bryfur/tang-av-scaler/hardware/av-board/README.md

# The AV board (rev C-B)

The scaler's hardware, for the sixth generation of game consoles: a Sipeed Tang Mega 138K SOM (Gowin
GW5AST-138, with its DDR3 and configuration flash) on a carrier of its own, 100 x 100 mm, four
layers, about 290 parts. Built (JLCPCB) and running the scaler since 2026-11.

Rev C-B, 3D

| On the board | Part | For |
|---|---|---|
| Component video in (three RCA jacks) | ADV7181D decoder | the console's YPbPr, sampled line-locked: 16-bit 4:2:2 to the FPGA; also wired: RGB with SCART sync, a VGA header (RGBHV with DDC): not used by the gateware yet |
| Stereo audio in (two RCA jacks) | PCM1808 converter, on its own 4.5 V supply | the console's sound, to HDMI |
| S/PDIF in (a header: coax or an optical module) | a slicer | not used by the gateware yet |
| HDMI out | SN65DP159 between the FPGA's transceivers and the receptacle (run as a redriver), ESD arrays, DDC/HPD/CEC | up to 4K60 by the link's rate; the scaler sends 1080p60 |
| Clock | MS5351M generator | the transceivers' reference, trimmed by the scaler to keep the output in step with the input; the audio converter's clock |
| Control | a Seeed XIAO ESP32-C5 in sockets, through level translators | Wi-Fi and the web page; the FPGA's JTAG (it loads bitstreams) and a UART and SPI port to it |
| Power | USB-C, 5 V / 3 A; a buck and LDOs | 3.3 V, 1.8 V, 1.1 V and the analogue rails |
| Test access | J17 (I2C buses and six spare FPGA pins behind 220 R), J16 (JTAG), rail test pads | [rev-cb/README.md](rev-cb/README.md) |

The design, connection by connection with its sources: [rev-c/design.md](rev-c/design.md) (the
SOM's interface, power, the clock generator, the XIAO, HDMI) and, for the circuits taken from the
earlier rev B (the decoder's front end, the audio converter, the supplies),
[older/rev-b/design.md](older/rev-b/design.md). Reviewed against every part's data sheet:
[rev-c/review.md](rev-c/review.md), [older/rev-b/review.md](older/rev-b/review.md). Fab files and
ordering notes: [rev-cb/README.md](rev-cb/README.md). The FPGA's pins:
`rev-cb/fpga/av-board-cb.cst` (generated from the board).

The board is generated with KiCad's Python API from `rev-cb/board.py`; nothing is drawn by hand.

## Layout of this directory

| Path | What |
|---|---|
| `rev-cb/` | the board: `board.py` (its parts and nets: the one source the schematic and PCB are generated from), `gen_pcb.py` (outline, placement, routing passes), the generated KiCad project, `fab/` (JLCPCB Gerbers, BOM, CPL), `img/` (renders), `fpga/` (pin constraints) |
| `rev-c/` | what rev C-B shares with its sibling C-A: the circuit (`carrier.py`), floor plan and layout, the SOM's interface (`som.py`, `som-pinout.csv`, `check_som_fp.py`), the FPGA pin assignment (`pinmap.py`), `design.md`, `review.md` |
| `kit/` | the generators and checks (below), and the circuits and layout taken from rev B: `circuits.py` (the supplies, the ADV7181D front end, the PCM1808, the S/PDIF input, the XIAO, the HDMI receptacle), `adv7181d_layout.py`, `tmds_layout.py` |
| `lib/` | LCSC symbols and footprints (3D models not in git) |
| `refs/` | data sheets and reference designs (not in git) |
| `older/` | the revisions before this one (A, B: hats on Sipeed's Tang Console; C-A: with an ADV7511): not built, kept for their design notes and reviews. [older/README.md](older/README.md) |

## Making the board

Everything is generated from `rev-cb/board.py`; edit that (and `gen_pcb.py` for placement), not
the KiCad files. On a machine with KiCad 9 (here: the build host), from this directory:

| Step | Command | Makes |
|---|---|---|
| check the design | `python3 rev-cb/board.py` | errors: one-pin nets, chip pins left open that should not be |
| schematic | `python3 kit/gen_sch.py rev-cb` | `rev-cb/av-board-cb.kicad_sch`, project and library tables |
| ERC | `kicad-cli sch erc rev-cb/av-board-cb.kicad_sch` | (clean) |
| netlist check | `kicad-cli sch export netlist -o /tmp/av.net rev-cb/av-board-cb.kicad_sch && python3 kit/check_netlist.py rev-cb /tmp/av.net` | schematic = board.py, pin by pin |
| PCB | `python3 rev-cb/gen_pcb.py --route` | `rev-cb/av-board-cb.kicad_pcb`: placed, fanned out, routed, ground poured, the revision's own pass, then whatever is left unconnected finished by mazeroute.py (`--complete`). Router: Freerouting (`FREEROUTING=1.9.0` default, under a private Xvfb; `2.5.0` headless), or DeepPCB (`ROUTER=deeppcb MINUTES=60`, API key in `~/.config/deeppcb/key`), or any session (`SES=file.ses`); a session from elsewhere gets a Freerouting finishing pass with its copper fixed (`FINISH=0`: none); `PCB=path` for a trial board elsewhere; `--silk`: the silkscreen pass again on a routed board; `--move REF x y angle`, then `--complete`: one part moved on a routed board, its connections made again |
| finishing | `kicad-cli pcb drc ...`, then for each connection left: `python3 kit/mazeroute.py dump BOARD REF.PAD REF.PAD /tmp/m.json [PARTNER_NET] && ~/tools/eda-venv/bin/python kit/mazeroute.py route /tmp/m.json /tmp/p.json && python3 kit/mazeroute.py apply BOARD /tmp/p.json` | a grid router (A*) for what Freerouting leaves: F/In2/B (`MAZE_LAYERS`, `MAZE_WIDTH`), new vias where they fit, our clearances; with `MAZE_SOFT=1` it may cross other signal nets' unlocked copper at a cost, and apply takes up what it crossed (rip-up). `gen_pcb.py --complete` does all this for whatever DRC lists, the rip-up last; DRC after |
| a router's result for some nets | `python3 kit/sesgraft.py BOARD x.ses PREFIX` | those nets' copper from a session added to a routed board |
| keep-outs on a routed board | `python3 rev-cb/gen_pcb.py --keepouts && python3 rev-cb/gen_pcb.py --complete` | after a change to the keep-outs (kit/tmds_layout.py's along the TMDS pairs: other lines 30 mil off, the arrays' pads voided in the planes): the board's own taken off, made again from its locked lines, the copper they now hold out taken up; `--complete` routes those connections again. The rest of the route stays |
| placement check | `python3 kit/placecheck.py rev-cb [--min 8]` | the small parts' signal pins far from the rest of their net (a part by the wrong anchor); `gen_pcb.py` itself prints the crossings left in each header bus |
| analog isolation | `python3 kit/xtalk.py rev-cb` | each analog line's digital neighbours within 1 mm on its layer: the closest gap, how far they run within 1 mm and within 0.5 mm |
| HDMI layout | `python3 kit/hdmi_audit.py rev-cb` | the TMDS pairs (and on rev C-B the transceivers' lanes and reference clock) against TI's layout rules (SN65DP159 12.1, SPRAAR7) and the HDMI skew budgets: lengths, skew, vias, turns, other copper along the run, crystals, switchers and holes nearby, the ground plane's edges and voids under the lines, the planes voided under parts on them; each finding with its rule |
| renders | `python3 kit/render.py rev-cb` | `rev-cb/img/`: a 3D view and a top view (KiCad's raytracer; models from `fetch_lib.sh` and `kit/fetch_3d.py`) |
| picture | `python3 kit/snap.py BOARD out.png` | a PNG of the board (needs PyMuPDF in `~/tools/eda-venv`) |
| DRC | `kicad-cli pcb drc BOARD` | |
| fab files | `python3 kit/gen_fab.py rev-cb` | `rev-cb/fab/`: Gerbers + drill zip, JLCPCB BOM and CPL, all from the board's lower-left corner; a BOM + CPL per assembly variant (`VARIANTS` in board.py: parts left for hand soldering) |
| parts library | `./kit/fetch_lib.sh` | `lib/`: LCSC symbols/footprints (committed) and 3D models (not) |

`kit/parts.py` is what board.py is written with (parts, LCSC numbers);
`kit/pcbkit.py` the PCB generator (placer, fanout, rules, planes, routing passes, silkscreen);
`kit/doubled.py` connections a router laid twice (loops, lengths counted twice, copper slivers);
`kit/decouple.py` each chip's supply pins and their capacitors (distances; regulators' in and out);
`kit/sexp.py` reads and writes KiCad's s-expression files; `kit/fix_lib.py` makes the LCSC
symbols' pins passive (their EasyEDA pin types are arbitrary); `kit/merge_sym.py` adds a symbol
whose EasyEDA name clashes with one already there; `kit/deeppcb.py` drives DeepPCB.

## Reference documents

In `refs/` (not in git). Every circuit on the board follows these (the ADV7842's and the ADV7511's are the older revisions').

| File | What | From |
|---|---|---|
| ADV7842_datasheet_adi.pdf | ADV7842 data sheet, Rev B: supplies, currents, crystal (28.63636 MHz), 256-ball map | analog.com data-sheets/ADV7842.pdf |
| UG-214_ADV7842_hardware.pdf | ADV7842 Hardware User Guide: analog input configuration (6.2.1), reset, pixel port, PCB layout recommendations, recommended decoupling (Fig. 168, 179), 75 R input termination (Appendix B) | analog.com user-guides/UG-214.pdf (via docs.ampnuts.ru mirror) |
| HDMI_RX_PowerSupplies_RevA_050411.pdf | ADI "PCB Layout and Power Supply Design Recommendations for HDMI RX Products", Rev A (April 2011): a ferrite per supply rail (Murata NFE61PT472C1H9), 10 nF + 100 nF per pin, 10 uF bulk on AVDD/CVDD/PVDD, LDOs not switchers, 3.3 V before 1.8 V; Fig. 2 the reference LDO supply (10 uH + 10 uF after the 1.8 V LDO, 100 nF + 1 uF on AVDD/CVDD/PVDD, 100 nF on DVDD/DVDDIO/TVDD, 1.8 V enable from 3.3 V via 100 k / 470 nF) | ADI EngineerZone, ADV7842 design support files (downloaded by hand) |
| adv7844ebz/ | ADI's ADV7844 evaluation board ("ADV7844 Input Module", Rev C, July 2010): schematic (11 sheets, image-only PDF), manufacturing BOM (.xls), IPC-356 netlist, Gerbers. The main circuit reference: see reference-notes.md | ADI EngineerZone, ADV7844 evaluation board info (downloaded by hand) |
| ADV7844-VER.5.8c.txt | ADI's recommended register scripts for the ADV7844 (v5.8c, 2012), the ADV7842's sibling: I2C write sequences per input mode, configuring the receiver (0x40 IO, 0x44 CP, 0x4C AFE ...) and the ADV7511 (0x72) together; "CP YPbPr SD/ED/HD" are the PS2's component modes. For bring-up; the ADV7842's own file (Rev 1.9) is the exact match | ADI EngineerZone, ADV7842 design support files (downloaded by hand) |
| UG-206_ADV7842_software.pdf | ADV7842 software (register) guide | analog.com user-guides/UG-206.pdf |
| UG-235_eval_ADV7842_7511.pdf | EVAL-ADV7842-7511 user guide (placement drawing, jumpers; no schematic) | farnell.com mirror of UG-235 |
| ADV7511_hardware_users_guide_RevD.pdf | ADV7511 Hardware User's Guide, Rev D: 100-lead LQFP pinout, input/output connections, HPD, DDC, PLL circuit, power domains and filtering, example schematic (Fig. 27) | analog.com user-guides/ADV7511_Hardware_Users_Guide.pdf |
| ADV7511_programming_guide.pdf | ADV7511 Programming Guide | analog.com user-guides |
| ADV7511_HDMI_designs_appnote.pdf | HDMI-enabled designs using the ADV7511 | analog.com evaluation-documentation |
| ADV7511W_hardware_users_guide_RevA.pdf | ADV7511W (64-lead) guide: cross-check only, its pinout does not apply | digikey.com |
| ADV7511_datasheet.pdf | ADV7511 short data sheet | docs.ampnuts.ru mirror |
| ADV7181D_datasheet.pdf | ADV7181D data sheet, Rev C (2024): 64-lead LFCSP pinout, supplies, component formats (525i-1080i), typical connection diagram (Fig. 9: ADC reference caps, loop filter, crystal), pixel output modes (rev B) | analog.com data-sheets/ADV7181D.pdf (downloaded by hand) |
| AN-1260.pdf | Crystal design considerations for ADI video decoders and HDMI parts | docs.ampnuts.ru mirror |
| AN-1270.pdf | ADV7511-based video generators | docs.ampnuts.ru mirror |
| AN-1143.pdf | ADV7511 HDCP 1.1 enable/disable | docs.ampnuts.ru mirror |
| PCM1808_datasheet.pdf | TI PCM1808 (Rev B): typical application circuit | ti.com |
| console138k_C.pdf | Sipeed Tang_138K_Console_V32001C schematic | dl.sipeed.com TANG/Console/02_Schematic |
| ibom_C.html | Sipeed's interactive BOM for board 32001C (part positions) | dl.sipeed.com TANG/Console/03_Designator_drawing |
| console/ | the Tang Mega 138K SOM's drawing, the NEO Console's schematic, the Retro Console's STEP model | dl.sipeed.com |
| RCJ-01.pdf | CUI RCJ-01x RCA jacks: footprint, colour codes | cuidevices.com |
| tlv62569.pdf, tps7a7001.pdf, tps7a20.pdf, tpd1e05u06.pdf, tpd4e05u06.pdf | TI: the buck, the LDOs, the ESD diodes and arrays | ti.com |
| sn65dp159.pdf | TI SN65DP159 retimer, SLLSEJ2G (rev C-B) | ti.com |
| MS5351M_datasheet_V1.4.pdf | Relmon MS5351M clock generator, V1.4 (Chinese): supplies, crystal, outputs (rev C) | LCSC (atta.szlcsc.com) |
| gowin/DS1239E.pdf | Gowin GW5AST data sheet DS1239: I/O standards, transceiver DC and reference clock characteristics (rev C) | cdn.gowinsemi.com.cn |

Still wanted, for cross-checking: the ADV7842 recommended settings (Rev 1.9) and the ADV7511
evaluation schematic (ADI's design support files).

What these documents say, circuit by circuit: [rev-c/design.md](rev-c/design.md) and [older/rev-b/design.md](older/rev-b/design.md) (rev C-B's circuits), [older/rev-a/reference-notes.md](older/rev-a/reference-notes.md) (ADV7842, ADV7511).

Fetching: analog.com serves its PDFs to `wget` (HTTP/1.1); curl over HTTP/2 stalls. EngineerZone
(ez.analog.com) refuses automated clients ("Access Denied"): its files are downloaded by hand.
Sipeed's file server lists folders with a POST to `https://dl.sipeed.com/fileList/<path>`.
