bryfur/tang-av-scaler/docs/compare/abyss-480i.png

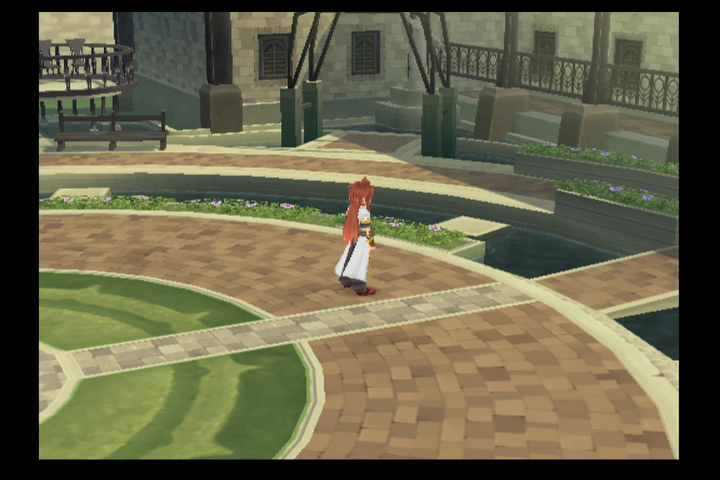
docs/compare/abyss-480i.png
