bryfur/tang-av-scaler/docs/compare/ammo.png

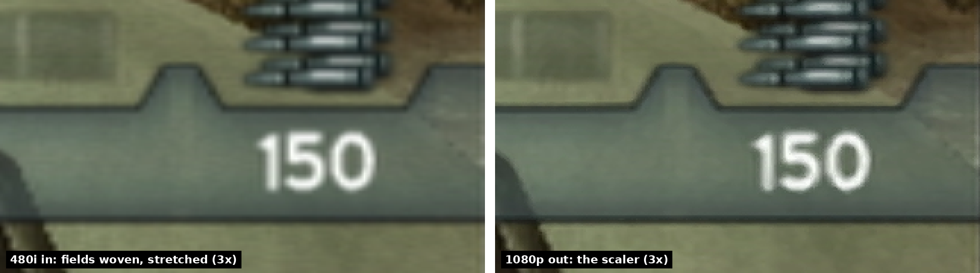
docs/compare/ammo.png
