bryfur/tang-av-scaler/docs/compare/foliage.png

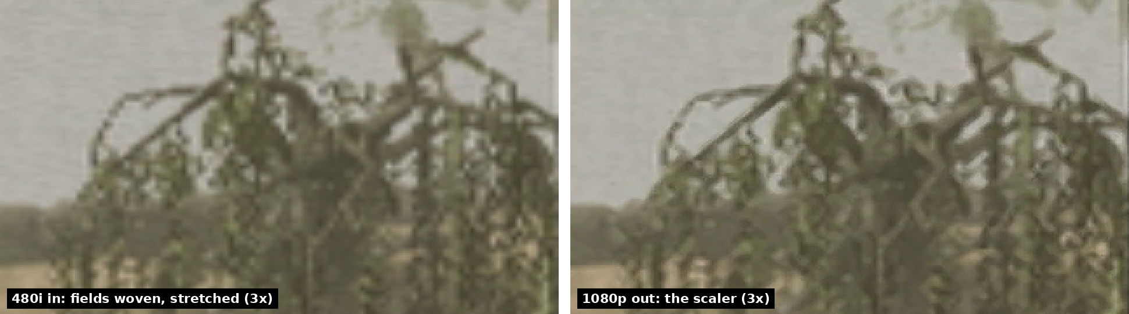
docs/compare/foliage.png
