bryfur/tang-av-scaler/docs/compare/game-480i.png

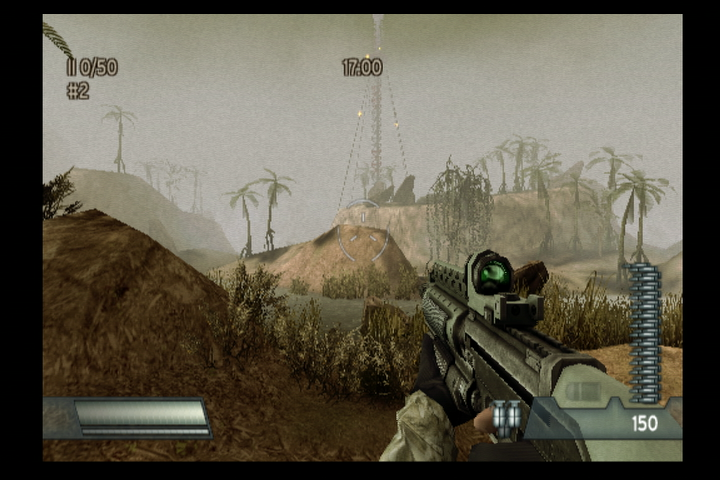
docs/compare/game-480i.png
