bryfur/tang-av-scaler/docs/compare/game-plain.png

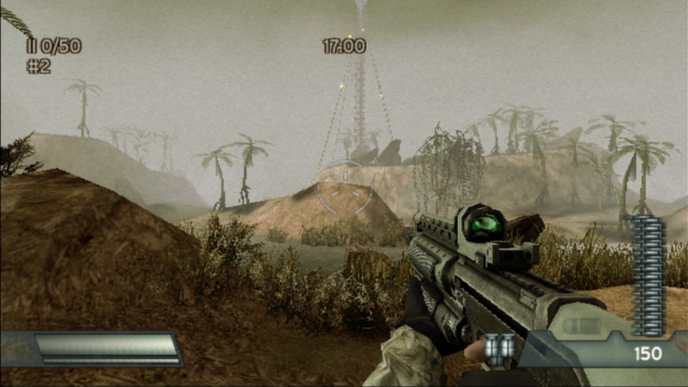
docs/compare/game-plain.png
