bryfur/tang-av-scaler/docs/compare/hud-text.png

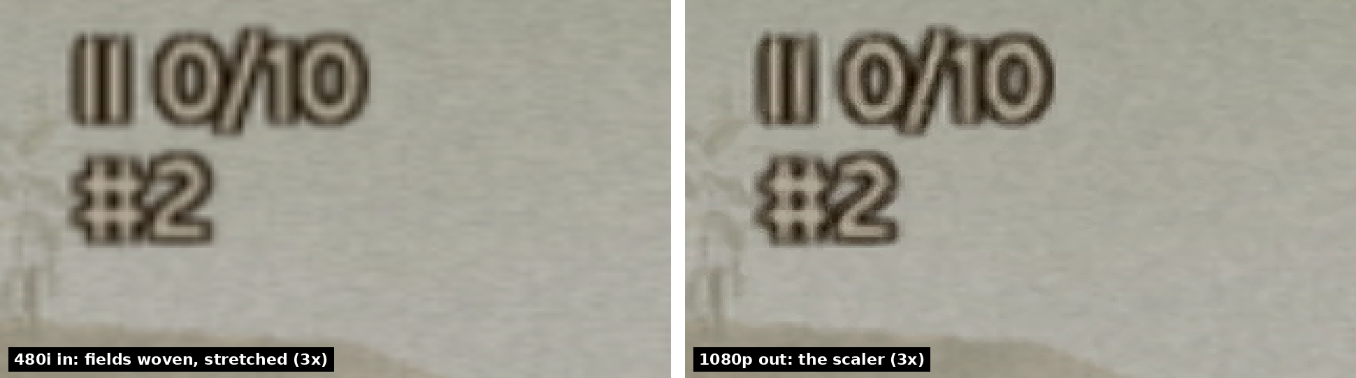
docs/compare/hud-text.png
