bryfur/tang-av-scaler/docs/compare/palms.png

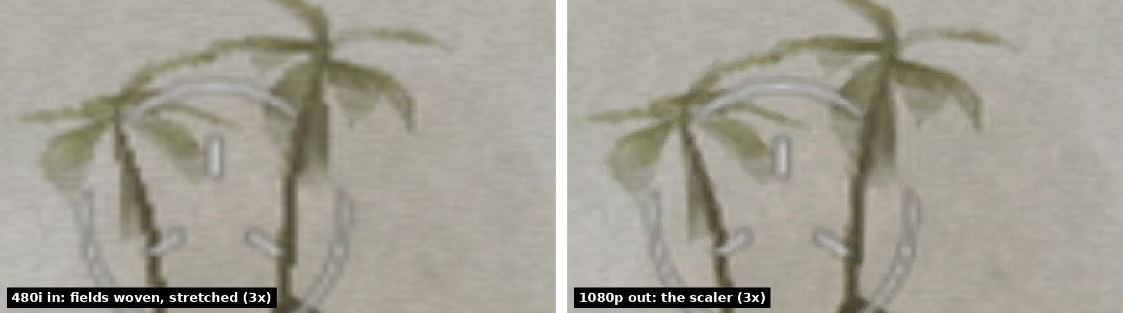
docs/compare/palms.png
