bryfur/tang-av-scaler/docs/compare/tower.png

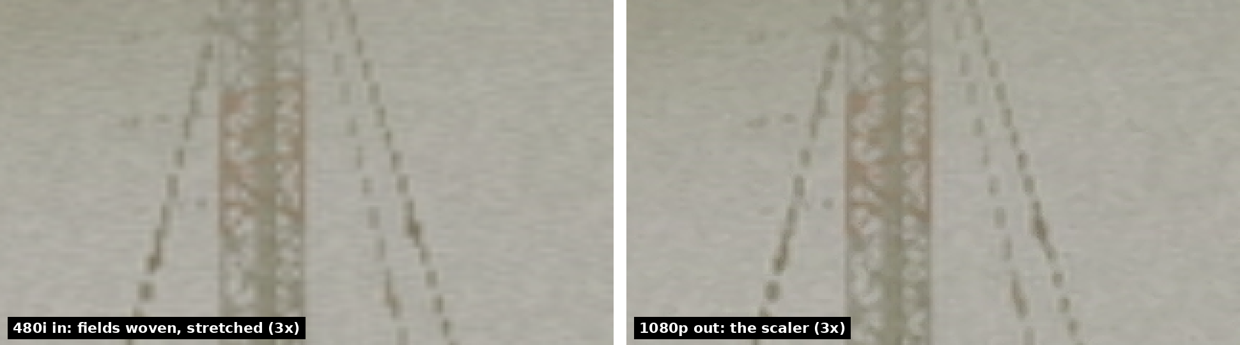
docs/compare/tower.png
