bryfur/tang-av-scaler/gateware/sim/ref/border480.png

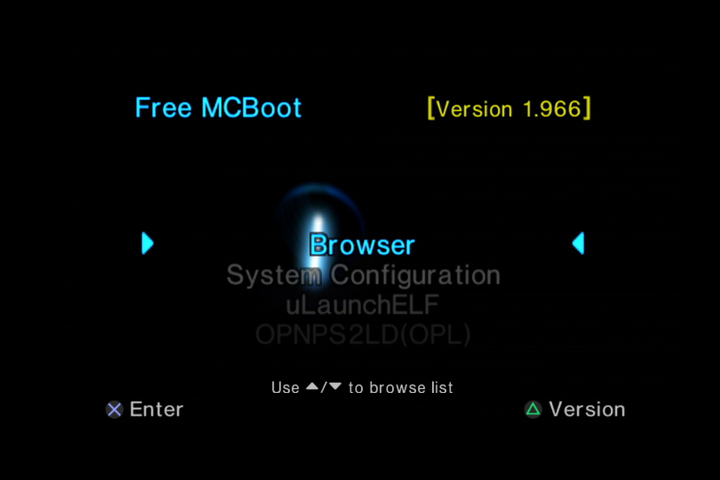
gateware/sim/ref/border480.png
