bryfur/tang-av-scaler/gateware/sim/ref/diag480.png

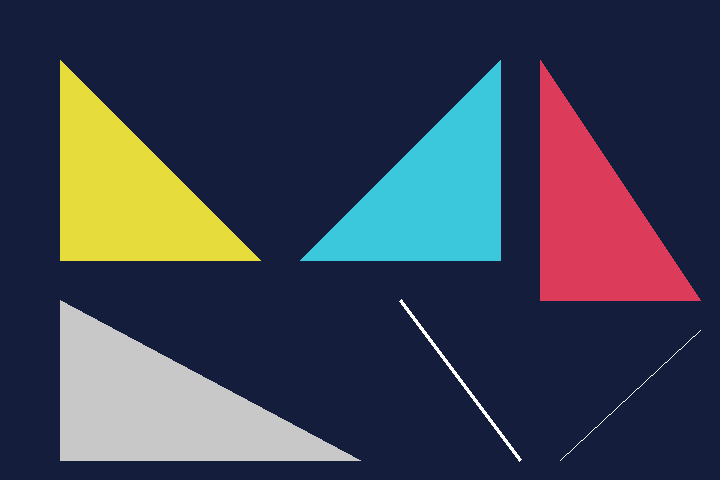
gateware/sim/ref/diag480.png
