bryfur/tang-av-scaler/gateware/sim/ref/layers480.png

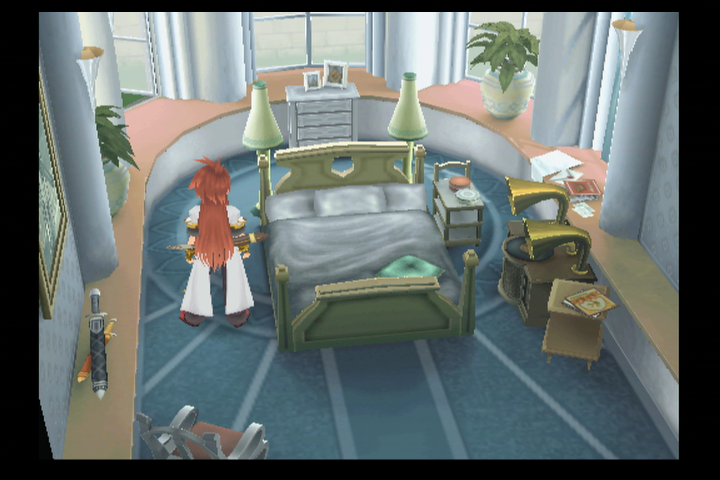
gateware/sim/ref/layers480.png
