bryfur/tang-av-scaler/gateware/sim/ref/menu480.png

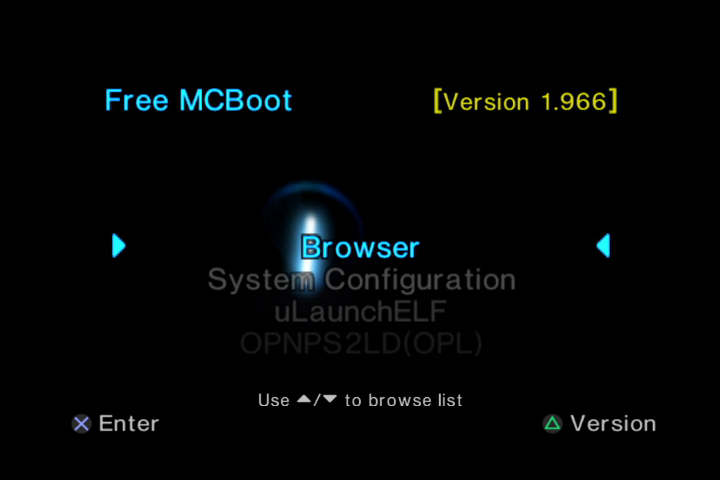
gateware/sim/ref/menu480.png
