bryfur/tang-av-scaler/gateware/sim/ref/shallow480.png

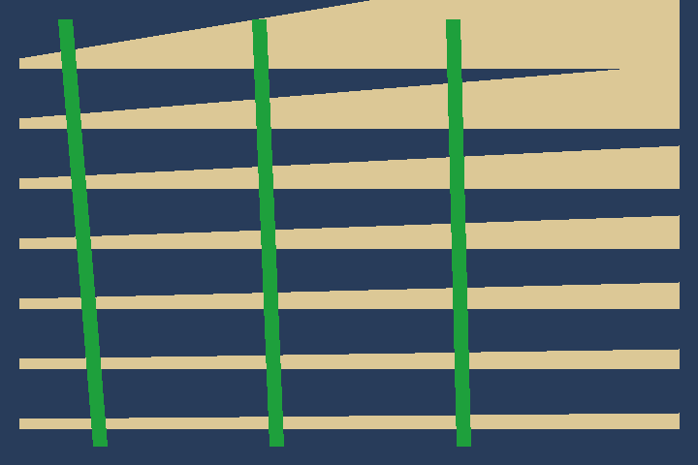
gateware/sim/ref/shallow480.png
