bryfur/tang-av-scaler/gateware/sim/ref/shapes480.png

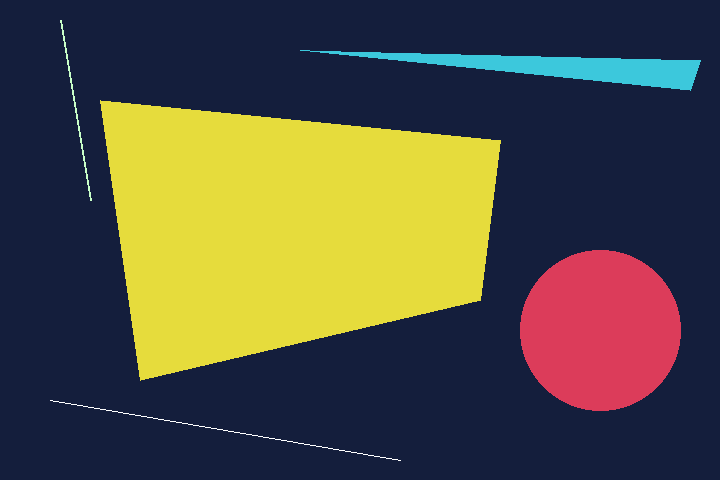
gateware/sim/ref/shapes480.png
