bryfur/tang-av-scaler/hardware/av-board/rev-c/som-pinout.csv

connector | pin | net | console_use | clock
J0 | 1 | GND
J0 | 2 | GND
J0 | 3 | BANK10_T13_IOB169B | JTAG.TMS
J0 | 4 | BANK8_V19_IOB81B | PMOD0_IO1 | SGCLKC_4/BPLL2_C_FB1/BPLL3_C_FB1
J0 | 5 | BANK10_U13_IOB169A | {DBG_JTAG} JTAG.TDO
J0 | 6 | BANK8_V18_IOB81A | PMOD0_IO0 | SGCLKT_4/BPLL2_T_FB1/BPLL3_T_FB1
J0 | 7 | BANK10_V12_IOB173B | JTAG.TCK
J0 | 8 | GND | {LCD_DPI}
J0 | 9 | BANK10_R13_IOB173A | JTAG.TDI
J0 | 10 | BANK4_U22_IOB104A | LCD_DPI.DEN | PUDC_B
J0 | 11 | GND
J0 | 12 | BANK4_T18_IOB138B | SDRAM1_D6
J0 | 13 | BANK4_U21_IOB97B | SDRAM1_D2 | SSPI_SI
J0 | 14 | BANK4_R18_IOB138A | SDRAM1_D7
J0 | 15 | BANK4_T21_IOB97A | {SDRAM1} SDRAM1_D3
J0 | 16 | GND
J0 | 17 | GND
J0 | 18 | BANK4_R17_IOB144B | {SDRAM1} SDRAM1_D4
J0 | 19 | BANK4_T20_IOB102B | SDRAM1_~{CS} | SSPI_SO
J0 | 20 | BANK4_P16_IOB144A | SDRAM1_D5
J0 | 21 | GND
J0 | 22 | GND | {LCD_DPI}
J0 | 23 | BANK4_R19_IOB99B | SDRAM1_D0 | SSPI_WPN
J0 | 24 | BANK3_L14_IOR62A | LCD_DPI.G1
J0 | 25 | BANK4_P19_IOB99A | SDRAM1_D1 | SSPI_CLK
J0 | 26 | BANK3_L15_IOR62B | LCD_DPI.VSYNC
J0 | 27 | GND
J0 | 28 | BANK3_N20_IOR94A | LCD_DPI.HSYNC
J0 | 29 | VCCO_3
J0 | 30 | BANK3_M20_IOR94B | LCD_DPI.B7
J0 | 31 | BANK3_N22_IOR89A | LCD_DPI.G6 | SSPI_SI
J0 | 32 | BANK3_L16_IOR65A | LCD_DPI.B6
J0 | 33 | BANK3_M22_IOR89B | LCD_DPI.G5 | SSPI_CSN
J0 | 34 | BANK3_K16_IOR65B | LCD_DPI.B5
J0 | 35 | GND
J0 | 36 | BANK4_P20_IOB92A | LCD_DPI_BL
J0 | 37 | BANK3_M21_IOR71A | LCD_DPI.G4
J0 | 38 | GND
J0 | 39 | BANK3_L21_IOR71B | LCD_DPI.G3
J0 | 40 | BANK3_N18_IOR92A | LCD_DPI.B4
J0 | 41 | BANK3_L19_IOR85A | LCD_DPI.CLK | SGCLKT_2/RPLL2_T_IN0/RPLL3_T_IN0
J0 | 42 | BANK3_N19_IOR92B | LCD_DPI.B3
J0 | 43 | BANK3_L20_IOR85B | LCD_DPI.G0 | SGCLKC_2/RPLL2_C_IN0/RPLL3_C_IN0
J0 | 44 | BANK3_M18_IOR87A | LCD_DPI.B2
J0 | 45 | BANK3_K21_IOR76A | LCD_DPI.R7
J0 | 46 | BANK3_L18_IOR87B | LCD_DPI.B1
J0 | 47 | BANK3_K22_IOR76B | LCD_DPI.R6
J0 | 48 | BANK3_K18_IOR83A | LCD_DPI.G2 | MGCLKT_2/RPLL2_T_IN1/RPLL3_T_IN1
J0 | 49 | BANK3_J22_IOR74A | LCD_DPI.R5
J0 | 50 | BANK3_K19_IOR83B | LCD_DPI.G7 | MGCLKC_2/RPLL2_C_IN1/RPLL3_C_IN1
J0 | 51 | BANK3_H22_IOR74B | LCD_DPI.R4
J0 | 52 | BANK3_H17_IOR96A | USB_RXDP_D+
J0 | 53 | BANK3_J20_IOR78A | LCD_DPI.R1 | SGCLKT_3/RPLL2_T_FB0/RPLL3_T_FB0
J0 | 54 | BANK3_H18_IOR96B | USB_RXDP_D-
J0 | 55 | BANK3_J21_IOR78B | LCD_DPI.R0 | SGCLKC_3/RPLL2_C_FB0/RPLL3_C_FB0
J0 | 56 | BANK3_J19_IOR80A | USB_DX_D+ | MGCLKT_3/RPLL2_T_FB1/RPLL3_T_FB1
J0 | 57 | BANK3_G17_IOR107A | LCD_DPI.R3 | ADCINCK1
J0 | 58 | BANK3_H19_IOR80B | USB_DX_D- | MGCLKC_3/RPLL2_C_FB1/RPLL3_C_FB1
J0 | 59 | BANK3_G18_IOR107B | LCD_DPI.R2
J0 | 60 | GND
J0 | 61 | BANK10_N12_IOB179B | RECONFIG_N {LCD_DPI}
J0 | 62 | BANK3_H20_IOR69A | {USB_SOFT_D} USB_RXDN_D+
J0 | 63 | GND
J0 | 64 | BANK3_G20_IOR69B | USB_RXDN_D-
J0 | 65 | BANK2_G21_IOR53A | PMOD0_IO2
J0 | 66 | GND | {PMOD1}
J0 | 67 | BANK2_G22_IOR53B | PMOD0_IO3
J0 | 68 | BANK2_F19_IOT124A | PMOD1_IO2
J0 | 69 | BANK2_F18_IOR35A | PMOD0_IO4
J0 | 70 | BANK2_F20_IOT124B | PMOD1_IO3 {SDRAM0}
J0 | 71 | BANK2_E18_IOR35B | PMOD0_IO5
J0 | 72 | BANK2_F21_IOT142A | SDRAM0_~{CS} SDRAM0_~{CS}IS
J0 | 73 | BANK2_C22_IOR42A | PMOD0_IO6
J0 | 74 | BANK2_E22_IOT140A | PMOD1_IO4
J0 | 75 | BANK2_B22_IOR42B | PMOD0_IO7
J0 | 76 | BANK2_D22_IOT140B | PMOD1_IO5
J0 | 77 | DONE | {PMOD0}
J0 | 78 | BANK2_E21_IOT138A | {PMOD1} PMOD1_IO6
J0 | 79 | READY
J0 | 80 | BANK2_D21_IOT138B | PMOD1_IO7
J1 | 1 | VCCO_2
J1 | 2 | GND
J1 | 3 | GND
J1 | 4 | BANK2_C20_IOR47B | SDRAM0_BA1
J1 | 5 | BANK2_A21_IOR44B | SDRAM0_D9
J1 | 6 | BANK2_D20_IOR47A | SDRAM0_A10
J1 | 7 | BANK2_B21_IOR44A | SDRAM0_D8
J1 | 8 | GND
J1 | 9 | GND
J1 | 10 | BANK2_D19_IOR29B | SDRAM0_A0 | SGCLKC_0/RPLL0_C_IN0/RPLL1_C_IN0
J1 | 11 | BANK2_A20_IOR40B | SDRAM0_D11
J1 | 12 | BANK2_E19_IOR29A | SDRAM0_A1 | SGCLKT_0/RPLL0_T_IN0/RPLL1_T_IN0
J1 | 13 | BANK2_B20_IOR40A | SDRAM0_D10
J1 | 14 | GND
J1 | 15 | GND
J1 | 16 | BANK2_C19_IOR31B | SDRAM0_A2 | MGCLKC_0/RPLL0_C_IN1/RPLL1_C_IN1
J1 | 17 | BANK2_A19_IOR38B | SDRAM0_A7
J1 | 18 | BANK2_C18_IOR31A | SDRAM0_A3 | MGCLKT_0/RPLL0_T_IN1/RPLL1_T_IN1
J1 | 19 | BANK2_A18_IOR38A | SDRAM0_A8
J1 | 20 | GND
J1 | 21 | GND
J1 | 22 | BANK2_E17_IOR13B | SDRAM0_~{CAS}
J1 | 23 | BANK2_B18_IOR24B | SDRAM0_A12 | SGCLKC_1/RPLL0_C_FB0/RPLL1_C_FB0
J1 | 24 | BANK2_F16_IOR13A | SDRAM0_~{RAS}
J1 | 25 | BANK2_B17_IOR24A | SDRAM0_CLK | SGCLKT_1/RPLL0_T_FB0/RPLL1_T_FB0
J1 | 26 | GND
J1 | 27 | GND
J1 | 28 | BANK2_D16_IOR6B | SDRAM0_~{WE}
J1 | 29 | BANK2_C17_IOR26B | SDRAM0_A9 | MGCLKC_1/RPLL0_C_FB1/RPLL1_C_FB1
J1 | 30 | BANK2_E16_IOR6A | SDRAM0_A4
J1 | 31 | BANK2_D17_IOR26A | SDRAM0_A11 | MGCLKT_1/RPLL0_T_FB1/RPLL1_T_FB1
J1 | 32 | GND
J1 | 33 | GND
J1 | 34 | BANK2_D15_IOR4B | SDRAM0_A5
J1 | 35 | BANK2_A16_IOR20B | SDRAM0_D13
J1 | 36 | BANK2_D14_IOR4A | SDRAM0_A6
J1 | 37 | BANK2_A15_IOR20A | SDRAM0_D12
J1 | 38 | GND
J1 | 39 | GND
J1 | 40 | BANK2_F15_IOR1A | SDRAM0_BA0
J1 | 41 | BANK2_B16_IOR22B | SDRAM0_D15
J1 | 42 | BANK2_F14_IOR11B | SDRAM0_DM0
J1 | 43 | BANK2_B15_IOR22A | SDRAM0_D14
J1 | 44 | BANK2_F13_IOR11A | SDRAM0_DM1
J1 | 45 | GND
J1 | 46 | GND | {USB_SOFT_D}
J1 | 47 | BANK2_A14_IOR15B | SDRAM0_D6
J1 | 48 | BANK3_J16_IOR109A | USB_TERM_RXDP
J1 | 49 | BANK2_A13_IOR15A | SDRAM0_D7
J1 | 50 | BANK3_J17_IOR58B | DVI-A_D2.N
J1 | 51 | GND
J1 | 52 | BANK3_K17_IOR58A | DVI-A_D2.P
J1 | 53 | BANK2_B13_IOR17B | SDRAM0_D4
J1 | 54 | BANK3_H15_IOR101B | DVI-A_D1.N
J1 | 55 | BANK2_C13_IOR17A | SDRAM0_D5
J1 | 56 | BANK3_J15_IOR101A | DVI-A_D1.P
J1 | 57 | GND
J1 | 58 | BANK3_H14_IOR103B | DVI-A_D0.N
J1 | 59 | BANK2_C15_IOR8B | SDRAM0_D2
J1 | 60 | BANK3_J14_IOR103A | {DVI_TMDS} DVI-A_D0.P
J1 | 61 | BANK2_C14_IOR8A | SDRAM0_D3
J1 | 62 | BANK3_G16_IOR105B | DVI-A_CK.N
J1 | 63 | GND
J1 | 64 | BANK3_G15_IOR105A | DVI-A_CK.P
J1 | 65 | BANK2_E14_IOR2B | SDRAM0_D0
J1 | 66 | BANK3_G13_IOR98B | FPGA_USB2_N
J1 | 67 | BANK2_E13_IOR2A | SDRAM0_D1
J1 | 68 | BANK3_H13_IOR98A | {USB-A2} FPGA_USB2_P
J1 | 69 | GND
J1 | 70 | GND
J1 | 71 | Q0_REFCLK1.N | E10
J1 | 72 | Q0_L3.RXN | C11
J1 | 73 | Q0_REFCLK1.P | {Q0_REFCLK1} F10
J1 | 74 | Q0_L3.RXP | {Q0_DAT3} D11
J1 | 75 | GND
J1 | 76 | GND
J1 | 77 | Q0_L1.TXN
J1 | 78 | Q0_L2.RXN
J1 | 79 | Q0_L1.TXP | {Q0_DAT1}
J1 | 80 | Q0_L2.RXP | {Q0_DAT2}
J1 | 81 | GND
J1 | 82 | GND
J1 | 83 | Q0_L2.TXN
J1 | 84 | Q0_L1.RXN
J1 | 85 | Q0_L2.TXP | {Q0_DAT2}
J1 | 86 | Q0_L1.RXP | {Q0_DAT1}
J1 | 87 | GND
J1 | 88 | GND
J1 | 89 | Q0_L3.TXN
J1 | 90 | Q0_L0.RXN
J1 | 91 | Q0_L3.TXP | {Q0_DAT3}
J1 | 92 | Q0_L0.RXP | {Q0_DAT0}
J1 | 93 | GND
J1 | 94 | GND
J1 | 95 | Q0_L0.TXN
J1 | 96 | Q0_REFCLK0.N
J1 | 97 | Q0_L0.TXP | {Q0_DAT0}
J1 | 98 | Q0_REFCLK0.P | {Q0_REFCLK0}
J1 | 99 | GND
J1 | 100 | GND
J2 | 1 | VCCO_6/7/8
J2 | 2 | BANK4_W22_IOB124B | {SDRAM1} SDRAM1_D13
J2 | 3 | BANK4_Y22_IOB131B | SDRAM1_A9
J2 | 4 | BANK4_W21_IOB124A | SDRAM1_D12
J2 | 5 | BANK4_Y21_IOB131A | SDRAM1_A11 | SSPI_CS_N
J2 | 6 | BANK4_V20_IOB120B | SDRAM1_A12 | GCLKC_8 SGCLKC_5/BPLL2_C_IN0/BPLL3_C_IN0
J2 | 7 | BANK4_AB22_IOB129B | SDRAM1_A7
J2 | 8 | BANK4_U20_IOB120A | SDRAM1_CLK | GCLKT_8 SGCLKT_5/BPLL2_T_IN0/BPLL3_T_IN0
J2 | 9 | BANK4_AB21_IOB129A | SDRAM1_A8
J2 | 10 | BANK3_M17_IOR73A | USB_DP_PULL
J2 | 11 | BANK4_AA21_IOB126B | SDRAM1_A5
J2 | 12 | BANK4_P17_IOB135B | SDRAM1_D11
J2 | 13 | BANK4_AA20_IOB126A | SDRAM1_A6
J2 | 14 | BANK4_N17_IOB135A | {USB-A1} SDRAM1_D10
J2 | 15 | BANK4_AB20_IOB110B | SDRAM1_~{WE}
J2 | 16 | BANK3_M16_IOR67B | FPGA_USB1_N
J2 | 17 | BANK4_AA19_IOB110A | SDRAM1_A4
J2 | 18 | BANK3_M15_IOR67A | FPGA_USB1_P
J2 | 19 | BANK4_W20_IOB122B | PMOD1_IO1 | MGCLKC_5/BPLL2_C_IN1/BPLL3_C_IN1
J2 | 20 | BANK4_N15_IOB146A | SDRAM1_BA0
J2 | 21 | BANK4_W19_IOB122A | PMOD1_IO0 | MGCLKT_5/BPLL2_T_IN1/BPLL3_T_IN1
J2 | 22 | BANK4_N13_IOB142A | {SDRAM1} SDRAM1_D8
J2 | 23 | BANK4_AB18_IOB108B | SDRAM1_DM1 {PMOD1}
J2 | 24 | BANK4_N14_IOB142B | {I2S_OUT} SDRAM1_D9
J2 | 25 | BANK4_AA18_IOB108A | SDRAM1_DM0
J2 | 26 | BANK5_Y17_IOB91A | I2S_BCLK
J2 | 27 | BANK4_Y19_IOB116B | SDRAM1_~{CAS} | MGCLKC_4/BPLL2_C_FB0/BPLL3_C_FB0
J2 | 28 | BANK5_AB17_IOB80B | I2S_LRCK
J2 | 29 | BANK4_Y18_IOB116A | SDRAM1_~{RAS} | MGCLKT_4/BPLL2_T_FB0/BPLL3_T_FB0
J2 | 30 | BANK5_AA16_IOB78B | {DVI_DDC} I2S_DOUT
J2 | 31 | BANK4_W17_IOB106B | SDRAM1_D15
J2 | 32 | BANK3_M13_IOR56A | DVI_DDC_CLK
J2 | 33 | BANK4_V17_IOB106A | SDRAM1_D14
J2 | 34 | BANK3_L13_IOR56B | {USB_SOFT_D} DVI_DDC_DAT
J2 | 35 | BANK4_U18_IOB112B | SDRAM1_BA1
J2 | 36 | BANK5_AB16_IOB80A | USB_TERM_RXDN
J2 | 37 | BANK4_U17_IOB112A | SDRAM1_A10
J2 | 38 | BANK5_AA15_IOB83A | TF_SDIO_D0 | SPI_MISO
J2 | 39 | BANK5_W16_IOB72B | LCD.INT0
J2 | 40 | BANK5_AB15_IOB83B | TF_SDIO_D1
J2 | 41 | BANK5_U16_IOB76B | LCD.INT1
J2 | 42 | BANK5_Y16_IOB78A | TF_SDIO_CMD | SPI_MOSI
J2 | 43 | BANK5_T16_IOB76A | LCD.INT2
J2 | 44 | BANK5_W15_IOB72A | TF_SDIO_D3 | SPI_CSN
J2 | 45 | BANK5_T15_IOB70B | LCD.INT3
J2 | 46 | BANK5_V15_IOB68B | {SDIO_CARD} TF_SDIO_CLK | SGCLKC_7/BPLL0_C_FB1/BPLL1_C_FB1 SPI_SCK
J2 | 47 | GND | {LCD_INIT}
J2 | 48 | BANK5_W14_IOB85A | {FPGA_UART} TF_SDIO_D2
J2 | 49 | BANK4_R16_IOB140B | SDRAM1_A0
J2 | 50 | BANK5_U15_IOB68A | FPGA_UART.TX | SGCLKT_7/BPLL0_T_FB1/BPLL1_T_FB1
J2 | 51 | BANK4_P15_IOB140A | SDRAM1_A1
J2 | 52 | BANK5_Y14_IOB56B | PA_EN
J2 | 53 | GND
J2 | 54 | BANK5_V14_IOB47B | FPGA_UART.RX | MGCLKC_7/BPLL0_C_FB0/BPLL1_C_FB0
J2 | 55 | BANK4_R14_IOB133B | SDRAM1_A2
J2 | 56 | BANK5_Y13_IOB56A | SDIO_DET
J2 | 57 | BANK4_P14_IOB133A | SDRAM1_A3
J2 | 58 | BANK5_AA14_IOB87B | {EX_KEY} PCIE_CLKREQ#
J2 | 59 | GND
J2 | 60 | BANK5_AA13_IOB54B | EX_KEY.0
J2 | 61 | BANK3_K14_IOR60B | DVI-A_PSV
J2 | 62 | BANK5_AB13_IOB54A | EX_KEY.1
J2 | 63 | BANK3_K13_IOR60A | DVI-A_HPD
J2 | 64 | BANK5_Y12_IOB52A | EX_KEY.2 | SGCLKC_6/BPLL0_C_IN0/BPLL1_C_IN0
J2 | 65 | GND | {DVI_ALT}
J2 | 66 | BANK5_AB12_IOB18A | FAN_EN
J2 | 67 | VCCO_5
J2 | 68 | BANK5_V10_IOB71B | USR_CLK_IN
J2 | 69 | BANK10_U9_IOB177B | MODE2
J2 | 70 | BANK5_W11_IOB35A | PCIE_PRST# | MGCLKT_6/BPLL0_T_IN1/BPLL1_T_IN1
J2 | 71 | BANK10_U10_IOB177A | MODE1
J2 | 72 | BANK5_Y11_IOB20B | NC_IO7 | SGCLKT_6/BPLL0_T_IN0/BPLL1_T_IN0
J2 | 73 | BANK10_U11_IOB175A | MODE0
J2 | 74 | BANK5_W10_IOB35B | {NC_10P} NC_IO6
J2 | 75 | BANK10_U8_IOB179A | LCD_DPI.B0 | CFGBVS
J2 | 76 | BANK5_AB11_IOB18B | NC_IO5
J2 | 77 | GND | {LCD_DPI} R22
J2 | 78 | BANK5_AA11_IOB20A | NC_IO4
J2 | 79 | GND
J2 | 80 | BANK5_AB10_IOB3B | NC_IO3
J2 | 81 | GND
J2 | 82 | BANK5_AA10_IOB1B | NC_IO2
J2 | 83 | GND | Modes Configuration
J2 | 84 | BANK5_AA9_IOB1A | NC_IO1
J2 | 85 | GND | Description Width
J2 | 86 | BANK5_W12_IOB52B | NC_IO0 | MGCLKC_6/BPLL0_C_IN1/BPLL1_C_IN1
J2 | 87 | GND
J2 | 88 | BANK5_V13_IOB66A | SYS_ACT | MGCLKT_7/BPLL0_T_FB0/BPLL1_T_FB0
J2 | 89 | VBUS_SOM | series GW5AST
J2 | 90 | BANK5_T14_IOB70A | PCIE_WAKE#
J2 | 91 | VBUS_SOM | interface JTAG
J2 | 92 | ADC_N9 | ADCT_N
J2 | 93 | VBUS_SOM
J2 | 94 | ADC_N10 | {FPGA_ADC} {PCIE_CTRL}
J2 | 95 | VBUS_SOM | data reads
J2 | 96 | ADC_M9 | ADCV_N
J2 | 97 | VBUS_SOM | configuration for
J2 | 98 | ADC_L10 | ADCV_P
J2 | 99 | VBUS_SOM
J2 | 100 | GND
