bryfur/tang-av-scaler/hardware/av-board/rev-ca/fab/av-board-ca-bom.csv

Comment | Designator | Footprint | LCSC Part #
47u | C1,C2 | C_1206_3216Metric | C96123
100n | C3,C20,C21,C22,C27,C28,C30,C33,C36,C38,C41,C42,C43,C44,C45,C47,C49,C51,C53,C55,C58,C60,C62,C68,C69,C70,C71,C72,C74,C75,C76,C77,C78,C81,C82,C86,C87,C88,C89,C90,C91,C92,C93,C94,C95,C96 | C_0402_1005Metric | C1525
10u | C4,C6,C7,C9,C10,C12,C13,C15,C73 | C_0805_2012Metric | C15850
6.8p | C5 | C_0402_1005Metric | C1576
220p | C8,C11,C14,C64,C66 | C_0402_1005Metric | C1530
10u | C16,C17,C18,C19,C59,C61,C63,C80,C83,C84,C85 | C_0603_1608Metric | C19702
1n | C23,C24 | C_0402_1005Metric | C1523
33p | C25,C26 | C_0402_1005Metric | C1562
10u | C29,C32,C35,C37 | C_0402_1005Metric | C15525
10n | C31,C34,C40,C46,C48,C50,C52,C54,C56 | C_0402_1005Metric | C15195
82n | C39 | C_0402_1005Metric | C277511
1u | C57,C65,C67,C79 | C_0603_1608Metric | C15849
22u | C97,C98,C99,C100 | C_0805_2012Metric | C45783
B5819W | D1,D3 | D_SOD-123 | C8598
KT-0603R | D2,D4,D5 | LED-SMD_L1.6-W0.8-R-RD | C2286
SMF5.0A | D6 | D_SMF | C2857263
1N4148WS | D7 | D_SOD-323 | C2128
TPD1E05U06DPYR | D8,D9,D10,D11,D12,D13 | X1SON-2_L1.0-W0.6-P0.65-RD-1 | C436349
3A | F1 | Fuse_1812_4532Metric | C18198349
0.2A | F2,F3 | F0805 | C883105
120R | FB1,FB2,FB3,FB4 | L_0603_1608Metric | C14709
RCA Y | J1 | CONN-TH_RCJ-011 | C4991844
RCA Pb | J2 | CONN-TH_RCJ-011 | C4991844
RCA Pr | J3 | CONN-TH_RCJ-011 | C4991691
RCA L | J4 | CONN-TH_RCJ-011 | C4991844
RCA R | J5 | CONN-TH_RCJ-011 | C4991691
HDMI-001 | J6 | HDMI-SMD_19P-P0.50-H-F | C138388
SYNC | J7 | HDR-TH_2P-P2.54-V-M | C492401
VGA | J8 | HDR-TH_16P-P2.54-V-M-R2-C8-S2.54 | C68234
XIAO 5V..D7 | J11 | HDR-TH_7P-P2.54-V-F | C22438157
XIAO D0..D6 | J12 | HDR-TH_7P-P2.54-V-F | C22438157
OPTICAL | J13 | HDR-TH_3P-P2.54-V-M_PZ254V-11-03P | C2937625
RCA S/PDIF | J14 | CONN-TH_RCJ-011 | C22359757
USB-C 5V | J15 | USB-C_SMD-TYPE-C-31-M-12_1 | C165948
JTAG | J16 | HDR-TH_6P-P2.54-V-M | C492405
DF40HC(3.0)-80DS | J20 | DF40HC-3.0-80DS-SOM | C2858577
DF40HC(3.0)-100DS | J21,J22 | DF40HC-3.0-100DS-SOM | C424649
2.2uH | L1 | IND-SMD_L3.0-W3.0_FNR30XXS | C167747
10uH | L2,L3,L4 | IND-SMD_L4.0-W4.0_SMNR4012 | C222882
2N7002 | Q1,Q2,Q3,Q4 | SOT-23-3_L2.9-W1.3-P1.90-LS2.4-BR | C8545
5.1k | R1,R2,R101,R102 | R_0402_1005Metric | C25905
499k | R3 | R_0402_1005Metric | C25793
100k | R4,R53,R55 | R_0402_1005Metric | C25741
169k | R5 | R_0402_1005Metric | C25758
30.1k | R6,R8,R10 | R_0402_1005Metric | C29402
78.7k | R7,R9 | R_0402_1005Metric | C67239
75 | R11,R12,R13,R14,R32,R33,R34,R50 | R_0603_1608Metric | C4275
1M | R15,R51 | R_0402_1005Metric | C26083
1.69k | R16 | R_0402_1005Metric | C25870
33 | R17,R18,R19,R20,R21,R22,R23,R24,R37,R38,R52,R54,R89 | R_0402_1005Metric | C25105
4.7k | R25,R26,R27,R28,R29,R30,R39,R41,R87,R88 | R_0402_1005Metric | C25900
10k | R31,R35,R36,R43,R44,R45,R47,R49,R60,R61,R62,R63,R64,R65,R66,R67,R68,R69,R70,R71,R72,R73,R74,R75,R76,R78,R80,R81,R85 | R_0402_1005Metric | C25744
47k | R40,R42 | R_0402_1005Metric | C25792
12k | R46,R48 | R_0402_1005Metric | C25752
470 | R56,R57,R58,R59,R77,R79,R82 | R_0402_1005Metric | C25117
2k | R83,R84,R96,R97,R98,R99 | R_0402_1005Metric | C4109
27k | R86 | R_0402_1005Metric | C25771
49.9 | R90,R91,R92,R93,R94 | R_0402_1005Metric | C25120
887 | R95 | R_0402_1005Metric | C55968414
1k | R100 | R_0402_1005Metric | C11702
33 | RN1,RN2,RN3 | RES-ARRAY-SMD_0402-8P-L2.0-W1.0-BL | C25501
TS-1187A-B-A-B | SW1,SW2,SW3 | SW-SMD_4P-L5.1-W5.1-P3.70-LS6.5-TL_H1.5 | C318884
ADV7181DBCPZ-RL | U1 | LFCSP-64_L9.0-W9.0-P0.50-BL-EP7.1 | C514378
ADV7511KSTZ | U2 | LQFP-100_L14.0-W14.0-P0.50-LS16.0-BL | C179459
PCM1808PWR | U3 | TSSOP-14_L5.0-W4.4-P0.65-LS6.4-BL | C55513
TLV62569DBVR | U4 | SOT-23-5_L3.0-W1.7-P0.95-LS2.8-BR | C141836
TPS7A7001DDAR | U5,U6,U7 | SOIC-8_L4.9-W3.9-P1.27-LS6.0-BL-EP | C60719
TPD4E05U06DQAR | U8,U9,U10,U19,U20 | USON-10_L2.5-W1.0-P0.50-BL | C138714
TPS7A2045PDBVR | U12 | SOT-23-5_L2.9-W1.6-P0.95-LS2.8-BR | C2873627
SN74LVC1GU04DBVR | U13 | SOT-23-5_L3.0-W1.7-P0.95-LS2.8-BR | C81934
SN74LVC1G04DBVR | U14,U15 | SOT-23-5_L3.0-W1.7-P0.95-LS2.8-BR | C7827
MS5351M | U17 | MSOP-10_L3.0-W3.0-P0.50-LS5.0-BL | C1509083
SN74LVC2G17DBVR | U21 | SOT-23-6_L2.9-W1.6-P0.95-LS2.8-BL | C10429
SN74LVC8T245PWR | U22 | TSSOP-24_L7.8-W4.4-P0.65-LS6.4-BL | C27643
SN74AVC4T245PWR | U23 | TSSOP-16_L5.0-W4.4-P0.65-LS6.4-BL | C81461
ME6211C30M5G-N | U24 | SOT-23-5_L2.9-W1.6-P0.95-LS2.8-BL | C403651
28.63636MHz 20pF | Y1 | CRYSTAL-SMD_L5.0-W3.2 | C112564
25MHz 10pF | Y2 | CRYSTAL-SMD_4P-L2.0-W1.6-BL | C5265839
