bryfur/tang-av-scaler/hardware/av-board/older/rev-b/av-board-b.kicad_pcb

## KiCad design hardware/av-board/older/rev-b/av-board-b.kicad_pcb (2026-10-28, an earlier design)

Schematic: av-board-b.kicad_sch, Tang Console AV board rev B

Parts:
C1, C2: 22u; C_0805_2012Metric; LCSC C45783
C3, C5, C6, C7, C8, C25, C26, C27, C32, C33, C35, C38, C41, C43, C46, C47, C48, C49, C50, C52, C54, C56, C58, C60, C63, C65, C67, C73, C74, C75, C76, C77, C81, C82, C83, C84, C85, C86, C87, C88, C89, C90, C91, C92: 100n; C_0402_1005Metric; LCSC C1525
C4, C9, C11, C12, C14, C15, C17, C18, C20: 10u; C_0805_2012Metric; LCSC C15850
C10: 6.8p; C_0402_1005Metric; LCSC C1576
C13, C16, C19, C69, C71: 220p; C_0402_1005Metric; LCSC C1530
C21, C22, C23, C24, C64, C66, C68, C78, C79, C80: 10u; C_0603_1608Metric; LCSC C19702
C28, C29: 1n; C_0402_1005Metric; LCSC C1523
C30, C31: 33p; C_0402_1005Metric; LCSC C1562
C34, C37, C40, C42: 10u; C_0402_1005Metric; LCSC C15525
C36, C39, C45, C51, C53, C55, C57, C59, C61: 10n; C_0402_1005Metric; LCSC C15195
C44: 82n; C_0402_1005Metric; LCSC C277511
C62, C70, C72: 1u; C_0603_1608Metric; LCSC C15849
D1, D3: B5819W; D_SOD-123; LCSC C8598
D2: KT-0603R; LED-SMD_L1.6-W0.8-R-RD; LCSC C2286
D7: 1N4148WS; D_SOD-323; LCSC C2128
D8, D9, D10, D11, D12, D13: TPD1E05U06DPYR; X1SON-2_L1.0-W0.6-P0.65-RD-1; LCSC C436349
F1, F2: 0.2A; F0805; LCSC C883105
FB1, FB2, FB3, FB4: 120R; L_0603_1608Metric; LCSC C14709
J1: RCA Y; CONN-TH_RCJ-011; LCSC C4991844
J2: RCA Pb; CONN-TH_RCJ-011; LCSC C4991844
J3: RCA Pr; CONN-TH_RCJ-011; LCSC C4991691
J4: RCA L; CONN-TH_RCJ-011; LCSC C4991844
J5: RCA R; CONN-TH_RCJ-011; LCSC C4991691
J6: HDMI-001; HDMI-SMD_19P-P0.50-H-F; LCSC C138388
J7: SYNC; HDR-TH_2P-P2.54-V-M; LCSC C492401
J8: VGA; HDR-TH_16P-P2.54-V-M-R2-C8-S2.54; LCSC C68234
J9, J10: 2x20 socket; HDR-TH_40P-P2.54-V-F-R2-C20-S2.54-2; LCSC C5124634
J11: XIAO 5V..D7; HDR-TH_7P-P2.54-V-F; LCSC C22438157
J12: XIAO D0..D6; HDR-TH_7P-P2.54-V-F; LCSC C22438157
J13: SPDIF; HDR-TH_5P-P2.54-V-M; LCSC C492404
L1: 2.2uH; IND-SMD_L3.0-W3.0_FNR30XXS; LCSC C167747
L2, L3, L4: 10uH; IND-SMD_L4.0-W4.0_SMNR4012; LCSC C222882
Q1, Q2: 2N7002; SOT-23-3_L2.9-W1.3-P1.90-LS2.4-BR; LCSC C8545
R1, R2, R7, R8, R9, R10, R11, R12, R41, R45, R46, R53, R54, R55, R57, R59, R77: 10k; R_0402_1005Metric; LCSC C25744
R3, R5, R6: 470; R_0402_1005Metric; LCSC C25117
R4, R14, R63: 100k; R_0402_1005Metric; LCSC C25741
R13: 499k; R_0402_1005Metric; LCSC C25793
R15: 169k; R_0402_1005Metric; LCSC C25758
R16, R18, R20: 30.1k; R_0402_1005Metric; LCSC C29402
R17, R19: 78.7k; R_0402_1005Metric; LCSC C67239
R21, R22, R23, R24, R42, R43, R44, R60: 75; R_0603_1608Metric; LCSC C4275
R25, R61: 1M; R_0402_1005Metric; LCSC C26083
R26: 1.69k; R_0402_1005Metric; LCSC C25870
R27, R28, R29, R30, R31, R32, R33, R34, R47, R48, R62, R64: 33; R_0402_1005Metric; LCSC C25105
R35, R36, R37, R38, R39, R40, R49, R51: 4.7k; R_0402_1005Metric; LCSC C25900
R50, R52: 47k; R_0402_1005Metric; LCSC C25792
R56, R58: 12k; R_0402_1005Metric; LCSC C25752
R65, R66, R67, R68, R69: 49.9; R_0402_1005Metric; LCSC C25120
R70: 887; R_0402_1005Metric; LCSC C55968414
R71, R72, R73, R74, R75, R76: 2k; R_0402_1005Metric; LCSC C4109
R78: 27k; R_0402_1005Metric; LCSC C25771
RN1, RN2, RN3: 33; RES-ARRAY-SMD_0402-8P-L2.0-W1.0-BL; LCSC C25501
SW1, SW2: TS-1187A-B-A-B; SW-SMD_4P-L5.1-W5.1-P3.70-LS6.5-TL_H1.5; LCSC C318884
U1: ADV7181DBCPZ-RL; LFCSP-64_L9.0-W9.0-P0.50-BL-EP7.1; LCSC C514378
U2: ADV7511KSTZ; LQFP-100_L14.0-W14.0-P0.50-LS16.0-BL; LCSC C179459
U3: PCM1808PWR; TSSOP-14_L5.0-W4.4-P0.65-LS6.4-BL; LCSC C55513
U4: TLV62569DBVR; SOT-23-5_L3.0-W1.7-P0.95-LS2.8-BR; LCSC C141836
U5, U6, U7: TPS7A7001DDAR; SOIC-8_L4.9-W3.9-P1.27-LS6.0-BL-EP; LCSC C60719
U8, U9, U10, U19, U20: TPD4E05U06DQAR; USON-10_L2.5-W1.0-P0.50-BL; LCSC C138714
U12: TPS7A2045PDBVR; SOT-23-5_L2.9-W1.6-P0.95-LS2.8-BR; LCSC C2873627
U13: SN74LVC1GU04DBVR; SOT-23-5_L3.0-W1.7-P0.95-LS2.8-BR; LCSC C81934
U14, U15: SN74LVC1G04DBVR; SOT-23-5_L3.0-W1.7-P0.95-LS2.8-BR; LCSC C7827
U21: SN74LVC2G17DBVR; SOT-23-6_L2.9-W1.6-P0.95-LS2.8-BL; LCSC C10429
U22: SN74LVC8T245PWR; TSSOP-24_L7.8-W4.4-P0.65-LS6.4-BL; LCSC C27643
U23: SN74AVC4T245PWR; TSSOP-16_L5.0-W4.4-P0.65-LS6.4-BL; LCSC C81461
Y1: 28.63636MHz 20pF; CRYSTAL-SMD_L5.0-W3.2; LCSC C112564

Connections:
1V8A: C16.1, C17.1, D1.2 (A), FB1.1, FB2.1, R17.1, U6.6 (OUT)
1V8B: C19.1, C20.1, L2.1, L3.1, L4.1, R19.1, U7.6 (OUT)
3V3: C6.1, C8.1, C13.1, C14.1, C15.1, C18.1, C49.1, C67.1, C68.1, C75.1, C76.1, C77.1, C91.1, D1.1 (K), FB3.1, FB4.1, Q1.1 (G), Q2.1 (G), R1.1, R2.1, R10.2, R11.2, R12.2, R15.1, R35.1, R36.1, R49.1, R51.1, R71.1, R72.1, R73.1, R78.1, U2.47 (MVDD), U3.4 (VDD), U5.6 (OUT), U6.2 (EN), U6.3 (IN), U7.2 (EN), U7.3 (IN), U13.5 (VCC), U14.5 (VCC), U15.5 (VCC), U21.5 (VCC), U22.23 (VCCB), U22.24 (VCCB), U23.16 (VCCB)
3V6: C10.1, C11.1, C12.1, L1.2, R13.1, U5.2 (EN), U5.3 (IN)
5VA: C65.1, C66.1, U3.3 (VCC), U12.5 (OUT)
+5V: C1.1, C2.1, C3.1, C9.1, C62.1, D3.2 (A), F1.1, F2.1, J9.11, J10.11, U4.1 (EN), U4.4 (VIN), U12.1 (IN), U12.3 (EN)
AIN_PB: C26.2, U1.47 (AIN8)
AIN_PR: C27.2, U1.45 (AIN6)
AIN_VB: C48.2, U1.48 (AIN9)
AIN_VG: C47.2, U1.35 (AIN2)
AIN_VR: C46.2, U1.46 (AIN7)
AIN_Y: C25.2, U1.49 (AIN10)
ALSB: R39.2, U1.52 (ALSB)
AUD_DIV_L: C69.1, C70.1, R56.2, R57.1
AUD_DIV_R: C71.1, C72.1, R58.2, R59.1
AUD_VINL: C70.2, U3.13 (VINL)
AUD_VINR: C72.2, U3.14 (VINR)
AV_AVDD: C23.1, C60.1, C61.1, FB3.2, U1.41 (AVDD)
AV_C0: R31.1, U1.26 (P2)
AV_C1: R30.1, U1.25 (P3)
AV_C2: RN3.3, U1.19 (P4)
AV_C3: RN3.2, U1.18 (P5)
AV_C4: RN3.1, U1.17 (P6)
AV_C5: R29.1, U1.16 (P7)
AV_C6: R28.1, U1.15 (P8)
AV_C7: R27.1, U1.14 (P9)
AV_DE: R34.1, U1.63 (FIELD/DE)
AV_DVDD: C21.1, C54.1, C55.1, C56.1, C57.1, FB1.2, U1.23 (DVDD), U1.58 (DVDD)
AV_DVDDIO: C24.1, C50.1, C51.1, C52.1, C53.1, FB4.2, R38.1, R39.1, R40.1, U1.4 (DVDDIO), U1.11 (DVDDIO)
AV_HS: R32.1, U1.2 (HS/CS)
AV_LLC: RN3.4, U1.20 (LLC)
AV_PVDD: C22.1, C44.2, C45.2, C58.1, C59.1, FB2.2, U1.31 (PVDD)
AV_VS: R33.1, U1.64 (VS)
AV_Y0: RN2.4, U1.8 (P12)
AV_Y1: RN2.3, U1.7 (P13)
AV_Y2: RN2.2, U1.6 (P14)
AV_Y3: RN2.1, U1.5 (P15)
AV_Y4: RN1.4, U1.62 (P16)
AV_Y5: RN1.3, U1.61 (P17)
AV_Y6: RN1.2, U1.60 (P18)
AV_Y7: RN1.1, U1.59 (P19)
CAPC2: C37.1, C38.1, C39.1, U1.44 (CAPC2)
CAPY1: C34.1, C35.1, C36.1, U1.39 (CAPY1)
CAPY2: C32.1, C33.1, C34.2, C35.2, C36.2, C37.2, C38.2, C39.2, U1.40 (CAPY2)
CEC_PU: D7.2 (A), R78.2
CML: C42.1, C43.1, U1.43 (CML)
ELPF: C45.1, R26.1, U1.30 (ELPF)
ELPF_RC: C44.1, R26.2
ESP_CS: J9.32, R10.1, U22.21 (B1)
ESP_IRQ: J9.33, R11.1, U23.13 (1B1)
ESP_MISO: J9.35, R12.1, U23.12 (1B2)
ESP_MOSI: J9.36, U22.19 (B3)
ESP_SCK: J9.34, U22.20 (B2)
FB_1V8A: C16.2, R17.2, R18.1, U6.7 (FB)
FB_1V8B: C19.2, R19.2, R20.1, U7.7 (FB)
FB_3V3: C13.2, R15.2, R16.1, U5.7 (FB)
FB_3V6: C10.2, R13.2, R14.1, U4.5 (FB)
FMT: R55.1, U3.12 (FMT)
GND: C1.2, C2.2, C3.2, C4.2, C5.2, C6.2, C7.2, C8.2, C9.2, C11.2, C12.2, C14.2, C15.2, C17.2, C18.2, C20.2, C21.2, C22.2, C23.2, C24.2, C30.2, C31.2, C32.2, C33.2, C40.2, C41.2, C42.2, C43.2, C49.2, C50.2, C51.2, C52.2, C53.2, C54.2, C55.2, C56.2, C57.2, C58.2, C59.2, C60.2, C61.2, C62.2, C63.2, C64.2, C65.2, C66.2, C67.2, C68.2, C69.2, C71.2, C73.2, C75.2, C76.2, C77.2, C78.2, C79.2, C80.2, C81.2, C82.2, C83.2, C84.2, C85.2, C86.2, C87.2, C88.2, C89.2, C90.2, C91.2, C92.2, D2.2 (K), D8.2 (GND), D9.2 (GND), D10.2 (GND), D11.2 (GND), D12.2 (GND), D13.2 (GND), J1.1, J2.1, J3.1, J4.1, J5.1, J6.2 (TMDSData2Shield), J6.5 (TMDSData1Shield), J6.8 (TMDSData0Shield), J6.11 (TMDSClockShield), J6.17 (DDC/CECGround), J6.20, J6.21, J6.22, J6.23, J7.2, J8.5, J8.6, J8.7, J8.8, J8.10, J9.12, J10.12, J10.37, J10.38, J10.39, J10.40, J11.2, J13.2, J13.4, R4.2, R9.2, R14.2, R16.2, R18.2, R20.2, R21.2, R22.2, R23.2, R24.2, R37.2, R41.2, R42.2, R43.2, R44.2, R45.2, R46.2, R53.2, R54.2, R55.2, R57.2, R59.2, R60.2, R63.2, R70.2, R74.2, R77.2, SW1.4 (D), SW2.4 (D), U1.3 (GND), U1.10 (GND), U1.24 (GND), U1.57 (GND), U1.65 (EP), U2.3 (DSD0), U2.4 (DSD1), U2.5 (DSD2), U2.6 (DSD3), U2.7 (DSD4), U2.8 (DSD5), U2.9 (DSDCLK), U2.13 (I2S1), U2.14 (I2S2), U2.15 (I2S3), U2.18 (GND), U2.20 (GND), U2.22 (GND), U2.23 (GND), U2.27 (GND), U2.31 (GND), U2.37 (GND), U2.44 (GND), U2.51 (HEAC-), U2.52 (HEAC+), U2.57 (D35), U2.58 (D34), U2.59 (D33), U2.60 (D32), U2.61 (D31), U2.62 (D30), U2.63 (D29), U2.64 (D28), U2.65 (D27), U2.66 (D26), U2.67 (D25), U2.68 (D24), U2.75 (GND), U2.89 (D7), U2.90 (D6), U2.91 (D5), U2.92 (D4), U2.93 (D3), U2.94 (D2), U2.95 (D1), U2.96 (D0), U2.99 (GND), U2.100 (GND), U3.2 (AGND), U3.5 (DGND), U4.2 (GND), U5.1 (NC), U5.4 (NC), U5.5 (NC), U5.8 (GND), U5.9 (EP), U6.1 (NC), U6.4 (NC), U6.5 (NC), U6.8 (GND), U6.9 (EP), U7.1 (NC), U7.4 (NC), U7.5 (NC), U7.8 (GND), U7.9 (EP), U8.3 (GND), U8.8 (GND), U9.3 (GND), U9.8 (GND), U10.3 (GND), U10.8 (GND), U12.2 (GND), U13.3 (GND), U14.3 (GND), U15.3 (GND), U19.3 (GND), U19.8 (GND), U20.3 (GND), U20.8 (GND), U21.2 (GND), U22.6 (A4), U22.7 (A5), U22.8 (A6), U22.9 (A7), U22.10 (A8), U22.11 (GND), U22.12 (GND), U22.13 (GND), U22.22 (~OE), U23.2 (1DIR), U23.3 (2DIR), U23.8 (GND), U23.9 (GND), U23.10 (2B2), U23.11 (2B1), U23.14 (2#OE), U23.15 (1#OE)
HDMI_5V: C92.1, F2.2, J6.18 (+5VPower), R75.1, R76.1
HDMI_CEC: D7.1 (K), J6.13 (CEC), U2.48 (CEC), U8.5 (D2-), U8.6 (NC)
HDMI_HPD: J6.19 (HotPlugDetect), R77.1, U2.30 (HPD), U8.4 (D2+), U8.7 (NC)
HDMI_SCL: J6.15 (SCL), R75.2, U2.53 (DDCSCL), U8.1 (D1+), U8.10 (NC)
HDMI_SDA: J6.16 (SDA), R76.2, U2.54 (DDCSDA), U8.2 (D1-), U8.9 (NC)
IN_BCK: J9.40, U3.8 (BCK)
IN_C0: J10.26, R31.2
IN_C1: J10.25, R30.2
IN_C2: J10.24, RN3.6
IN_C3: J10.23, RN3.7
IN_C4: J10.22, RN3.8
IN_C5: J10.21, R29.2
IN_C6: J10.19, R28.2
IN_C7: J10.18, R27.2
IN_DE: J10.8, R34.2
IN_DOUT: J9.39, U3.9 (DOUT)
IN_HS: J10.13, R32.2
IN_INT: J10.10, R38.2, U1.1 (#INT)
IN_KEY1: J10.31, R1.2, SW1.1 (A)
IN_KEY2: J10.32, R2.2, SW2.1 (A)
IN_LED: J10.33, R3.1
IN_LLC: J10.20, RN3.5
IN_LRCK: J9.38, U3.7 (LRCK)
IN_RESET_N: J10.1, R37.1, U1.51 (#RESET)
IN_SCKI: J9.37, U3.6 (SCKI)
IN_SCL: J10.3, R35.2, U1.54 (SCLK)
IN_SDA: J10.2, R36.2, U1.53 (SDATA)
IN_VS: J10.9, R33.2
IN_Y0: J10.17, RN2.5
IN_Y1: J10.16, RN2.6
IN_Y2: J10.15, RN2.7
IN_Y3: J10.14, RN2.8
IN_Y4: J10.7, RN1.5
IN_Y5: J10.6, RN1.6
IN_Y6: J10.5, RN1.7
IN_Y7: J10.4, RN1.8
LED_A: D2.1 (A), R3.2
MD0: R53.1, U3.10 (MD0)
MD1: R54.1, U3.11 (MD1)
OUT_C0: J9.15, U2.80 (D16)
OUT_C1: J9.13, U2.78 (D17)
OUT_C2: J9.10, U2.74 (D18)
OUT_C3: J9.9, U2.73 (D19)
OUT_C4: J9.8, U2.72 (D20)
OUT_C5: J9.7, U2.71 (D21)
OUT_C6: J9.6, U2.70 (D22)
OUT_C7: J9.5, U2.69 (D23)
OUT_CECCLK: J9.31, U2.50 (CEC_CLK)
OUT_CLK: J9.14, U2.79 (CLK)
OUT_DE: J9.24, U2.97 (DE)
OUT_HSYNC: J9.25, U2.98 (HSYNC)
OUT_I2S0: J9.28, R68.1
OUT_INT: J9.2, R73.2, U2.45 (INT)
OUT_LRCLK: J9.30, R67.1
OUT_MCLK: J9.27, R65.1
OUT_PD: J9.1, R74.1, U2.38 (PD)
OUT_SCL: J9.3, R71.2, U2.55 (SCL)
OUT_SCLK: J9.29, R66.1
OUT_SDA: J9.4, R72.2, U2.56 (SDA)
OUT_SPDIF: J10.28, R69.1
OUT_VSYNC: J9.26, U2.2 (VSYNC)
OUT_Y0: J9.23, U2.88 (D8)
OUT_Y1: J9.22, U2.87 (D9)
OUT_Y2: J9.21, U2.86 (D10)
OUT_Y3: J9.20, U2.85 (D11)
OUT_Y4: J9.19, U2.84 (D12)
OUT_Y5: J9.18, U2.83 (D13)
OUT_Y6: J9.17, U2.82 (D14)
OUT_Y7: J9.16, U2.81 (D15)
PD_FB: R41.1, U1.32 (FB)
PWRDWN: R40.2, U1.29 (#PWRDWN)
RCA_L: J4.2, R56.1
RCA_PB: C26.1, D9.1 (I/O), J2.2, R22.1
RCA_PR: C27.1, D10.1 (I/O), J3.2, R23.1
RCA_R: J5.2, R58.1
RCA_SYNC: C29.1, D11.1 (I/O), J7.1, R24.1
RCA_Y: C25.1, C28.1, D8.1 (I/O), J1.2, R21.1
REFOUT: C40.1, C41.1, U1.42 (REFOUT)
R_EXT: R70.1, U2.28 (R_EXT)
SPDIF_5V: C73.1, F1.2, J13.5
SPDIF_AC: C74.2, R61.2, U13.2 (A)
SPDIF_AMP: R61.1, U13.4 (Y), U14.2 (A)
SPDIF_COAX: C74.1, D12.1 (I/O), J13.1, R60.1
SPDIF_OPT: D13.1 (I/O), J13.3, R63.1, U15.2 (A)
SPDIF_ORX: J10.35, R64.2
SPDIF_OSQ: R64.1, U15.4 (Y)
SPDIF_RX: J10.27, R62.2
SPDIF_SQ: R62.1, U14.4 (Y)
SW_3V6: L1.1, U4.3 (SW)
SYNC_G: C29.2, U1.33 (SOG)
SYNC_Y: C28.2, U1.50 (SOY)
TMDS_CK_N: J6.12 (TMDSClock-), U2.32 (TXC-), U10.5 (D2-), U10.6 (NC)
TMDS_CK_P: J6.10 (TMDSClock+), U2.33 (TXC+), U10.4 (D2+), U10.7 (NC)
TMDS_D0_N: J6.9 (TMDSData0-), U2.35 (TX0-), U10.2 (D1-), U10.9 (NC)
TMDS_D0_P: J6.7 (TMDSData0+), U2.36 (TX0+), U10.1 (D1+), U10.10 (NC)
TMDS_D1_N: J6.6 (TMDSData1-), U2.39 (TX1-), U9.5 (D2-), U9.6 (NC)
TMDS_D1_P: J6.4 (TMDSData1+), U2.40 (TX1+), U9.4 (D2+), U9.7 (NC)
TMDS_D2_N: J6.3 (TMDSData2-), U2.42 (TX2-), U9.2 (D1-), U9.9 (NC)
TMDS_D2_P: J6.1 (TMDSData2+), U2.43 (TX2+), U9.1 (D1+), U9.10 (NC)
TX_AVDD: C79.1, C85.1, C86.1, C87.1, C88.1, L3.2, U2.24 (PVDD), U2.25 (PVDD), U2.29 (AVDD), U2.34 (AVDD), U2.41 (AVDD)
TX_DVDD: C78.1, C81.1, C82.1, C83.1, C84.1, L2.2, U2.1 (DVDD), U2.19 (DVDD), U2.49 (DVDD), U2.76 (DVDD), U2.77 (DVDD)
TX_I2S0: R68.2, U2.12 (I2S0)
TX_LRCLK: R67.2, U2.17 (LRCLK)
TX_MCLK: R65.2, U2.11 (MCLK)
TX_PLVDD: C80.1, C89.1, C90.1, L4.2, U2.21 (PLVDD), U2.26 (BGVDD)
TX_SCLK: R66.2, U2.16 (SCLK)
TX_SPDIF: R69.2, U2.10 (SPDIF)
VGA_5V: J8.9, R50.1, R52.1
VGA_B: C48.1, J8.3, R44.1, U19.5 (D2-), U19.6 (NC)
VGA_G: C47.1, J8.2, R43.1, U19.2 (D1-), U19.9 (NC)
VGA_HS: J8.13, R45.1, U20.1 (D1+), U20.10 (NC), U21.1 (1A)
VGA_HSB: R47.1, U21.6 (1Y)
VGA_HSIN: R47.2, U1.56 (HS_IN/CS_IN)
VGA_R: C46.1, J8.1, R42.1, U19.4 (D2+), U19.7 (NC)
VGA_SCL: J8.15, Q2.3 (D), R52.2, U20.5 (D2-), U20.6 (NC)
VGA_SCL_F: J10.34, Q2.2 (S), R51.2
VGA_SDA: J8.12, Q1.3 (D), R50.2, U20.4 (D2+), U20.7 (NC)
VGA_SDA_F: J10.36, Q1.2 (S), R49.2
VGA_VS: J8.14, R46.1, U20.2 (D1-), U20.9 (NC), U21.3 (2A)
VGA_VSB: R48.1, U21.4 (2Y)
VGA_VSIN: R48.2, U1.55 (VS_IN)
VREF: C63.1, C64.1, U3.1 (VREF)
XIAO_3V3: C5.1, C7.1, J11.3, R4.1, R7.2, R8.2, U22.1 (VCCA), U22.2 (DIR), U23.1 (VCCA)
XIAO_5V: C4.1, D3.1 (K), J11.1
XIAO_D4: J12.5, R7.1, U22.3 (A1)
XIAO_D5: J12.6, R5.2
XIAO_D5_A: R5.1, U23.4 (1A1)
XIAO_D8: J11.6, R8.1, U22.4 (A2)
XIAO_D9: J11.5, R6.2
XIAO_D9_A: R6.1, U23.5 (1A2)
XIAO_D10: J11.4, R9.1, U22.5 (A3)
XTAL: C30.1, R25.1, U1.22 (XTAL), Y1.1 (OSC1)
XTAL1: C31.1, R25.2, U1.21 (XTAL1), Y1.2 (OSC2)

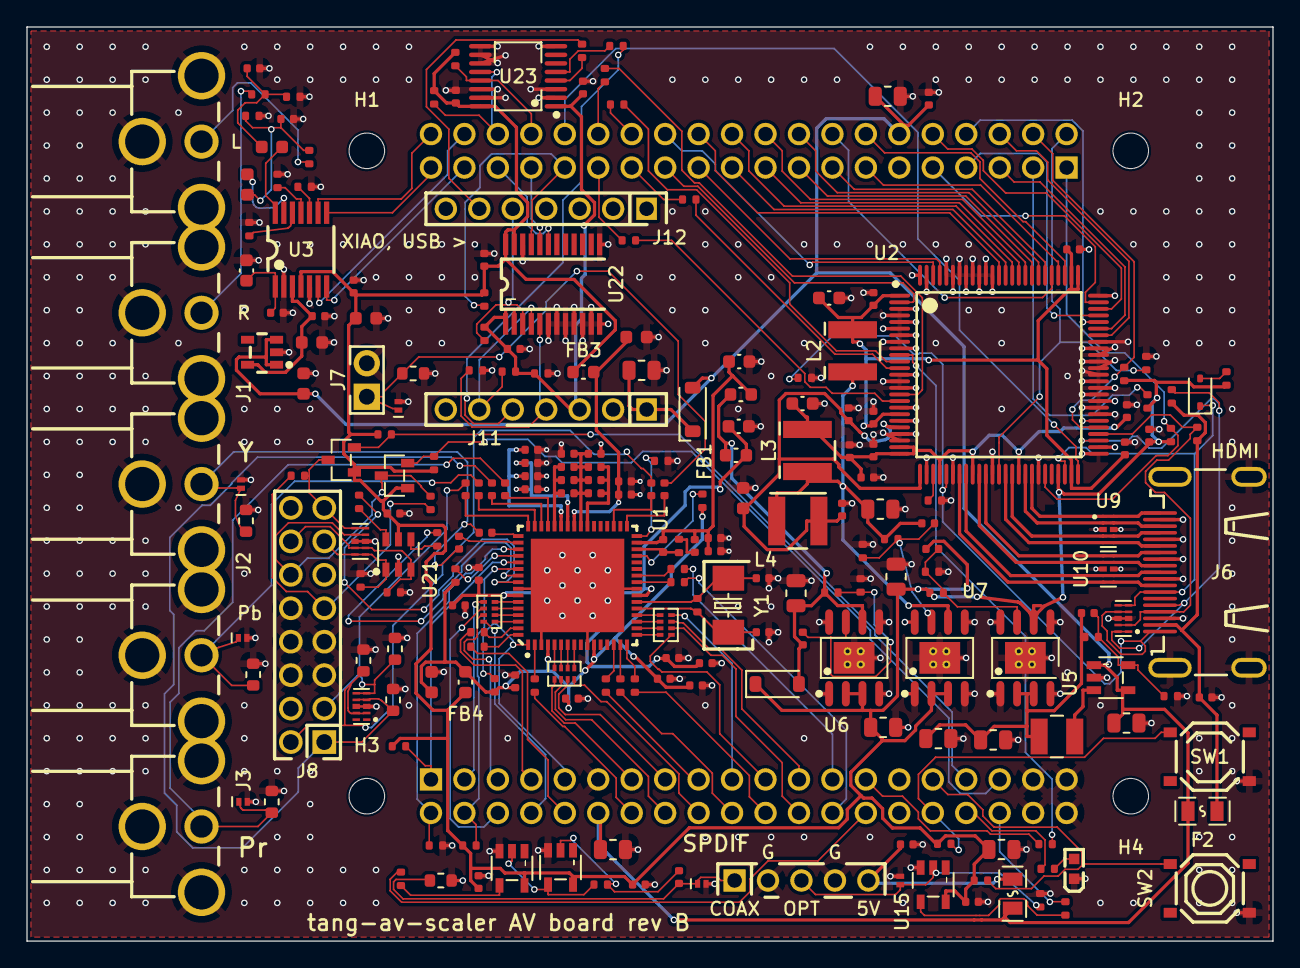
[picture p27: board av-board-b.kicad_pcb from above]

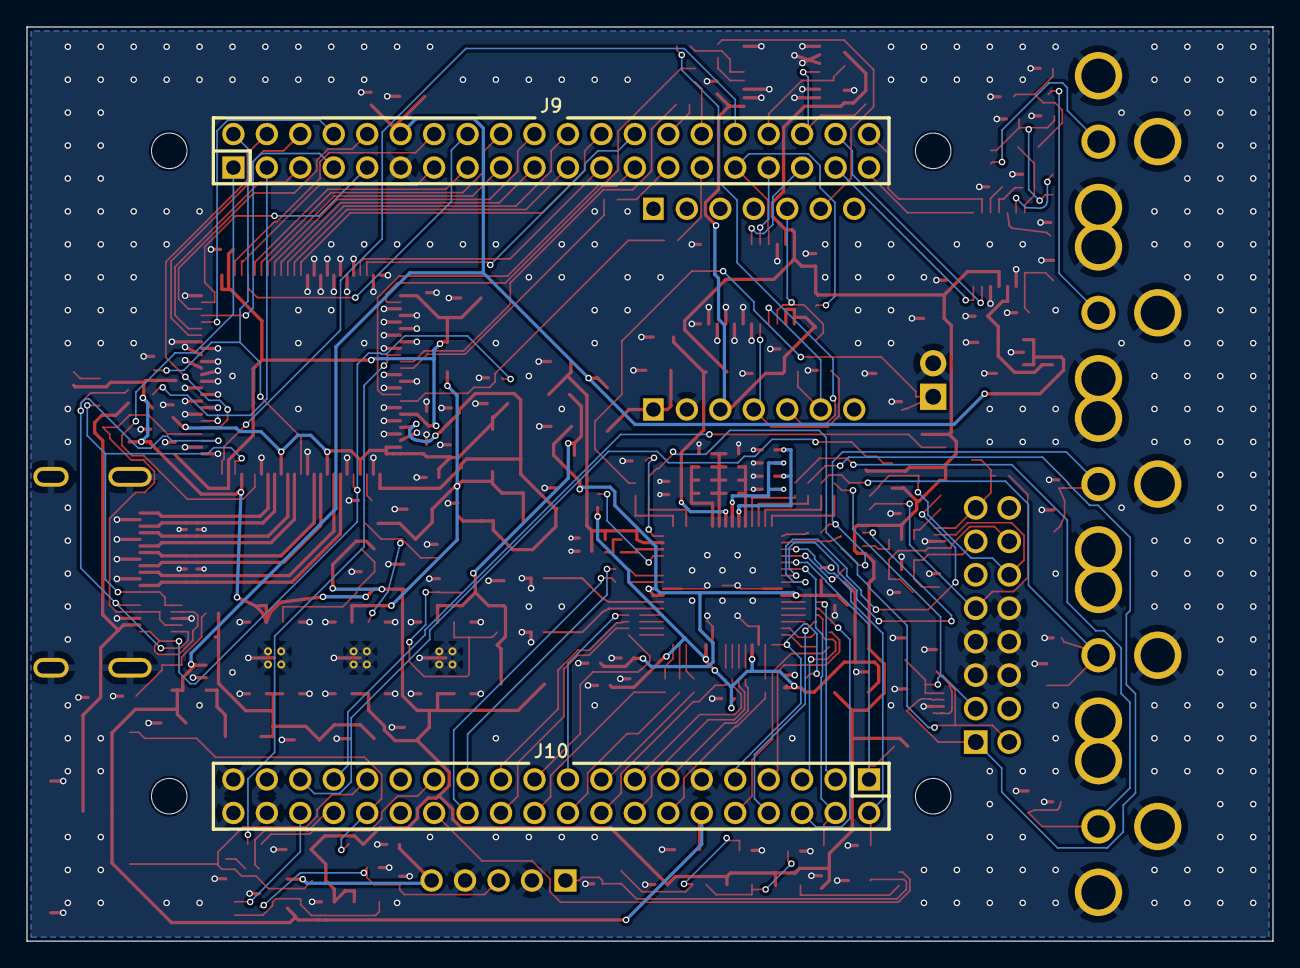
[picture p28: board av-board-b.kicad_pcb from below]

Board: 4 copper layers, 94.6 x 69.4 mm, 234 parts (2 on the bottom side), 192 nets.

Other parts of the board:
H1, H2, H3, H4: MountingHole_2.7mm_M2.5
