bryfur/tang-av-scaler/hardware/av-board/older/rev-a/av-board-a.kicad_pcb

## KiCad design hardware/av-board/older/rev-a/av-board-a.kicad_pcb (2026-10-27, an earlier design)

Schematic: av-board-a.kicad_sch, Tang Console AV board rev A

Parts:
C1, C2: 22u; C_0805_2012Metric; LCSC C45783
C3, C32, C33, C34, C38, C39, C43, C44, C71, C103, C104, C106, C108, C114, C115, C116, C117, C118, C119, C120, C121, C122, C123, C124, C125: 100n; C_0402_1005Metric; LCSC C1525
C4, C5, C8, C11, C12, C14, C15: 10u; C_0805_2012Metric; LCSC C15850
C6, C13, C16, C45, C46, C47, C48, C49, C50, C51, C52, C53, C59, C60, C61, C62, C63, C64, C65, C66, C67, C77, C78, C89, C90, C91, C92, C93, C94, C95, C96, C97, C98, C99, C100, C101, C110, C112: 220p; C_0402_1005Metric; LCSC C1530
C7: 4.7u; C_0805_2012Metric; LCSC C1779
C9: 6.8p; C_0402_1005Metric; LCSC C1576
C10: 470n; C_0603_1608Metric; LCSC C1623
C17, C19, C21, C23, C25, C27: 33u; CAP-SMD_L3.5-W2.8-R-RD; LCSC C7202
C18, C20, C22, C24, C26, C28, C29, C30, C31, C40, C105, C107, C109: 10u; C_0603_1608Metric; LCSC C19702
C35: 1n; C_0402_1005Metric; LCSC C1523
C36, C37: 30p; C_0402_1005Metric; LCSC C1570
C41, C42, C54, C55, C56, C57, C58, C68, C69, C70, C72, C73, C74, C75, C76, C79, C80, C81, C82, C83, C84, C85, C86, C87, C88, C102: 10n; C_0402_1005Metric; LCSC C15195
C111, C113: 1u; C_0603_1608Metric; LCSC C15849
F1: 0.2A; F0805; LCSC C883105
FB1: 600R; L_0603_1608Metric; LCSC C1002
FL1, FL2, FL3, FL4, FL5, FL6: NFE61PT472C1H9L; FILTER-SMD_NFE61PT472C1H9L; LCSC C79933
J1: RCA Y; CONN-TH_RCJ-011; LCSC C4992678
J2: RCA Pb; CONN-TH_RCJ-011; LCSC C4992678
J3: RCA Pr; CONN-TH_RCJ-011; LCSC C4991691
J4: RCA L; CONN-TH_RCJ-011; LCSC C4992678
J5: RCA R; CONN-TH_RCJ-011; LCSC C4991691
J6: HDMI-001; HDMI-SMD_19P-P0.50-H-F; LCSC C138388
J9, J10: 2x20 socket; HDR-TH_40P-P2.54-V-F-R2-C20-S2.54-2; LCSC C5124634
L1: 2.2uH; IND-SMD_L3.0-W3.0_FNR30XXS; LCSC C167747
L2, L3, L4: 10uH; IND-SMD_L4.0-W4.0_SMNR4012; LCSC C222882
R1, R2, R27, R28, R29, R30, R49, R50, R51, R52, R53, R54, R55, R67: 10k; R_0402_1005Metric; LCSC C25744
R3: 169k; R_0402_1005Metric; LCSC C25758
R4, R9, R11: 30.1k; R_0402_1005Metric; LCSC C29402
R5: 316k; R_0402_1005Metric; LCSC C25777
R6, R7: 100k; R_0402_1005Metric; LCSC C25741
R8, R10: 78.7k; R_0402_1005Metric; LCSC C67239
R12, R14, R16: 24; R_0402_1005Metric; LCSC C2909340
R13, R15, R17, R56, R57, R58, R59: 51; R_0402_1005Metric; LCSC C25125
R18: 390k; R_0402_1005Metric; LCSC C2909352
R19: 499; R_0402_1005Metric; LCSC C4125
R20, R21, R22, R23, R24, R25, R31, R32, R33, R34, R35, R36, R37, R38, R39, R40, R41, R42, R43, R44, R45, R46, R47, R48: 4.7k; R_0402_1005Metric; LCSC C25900
R26: 4.7k; R_0402_1005Metric; LCSC C25900; not fitted
R60: 887; R_0402_1005Metric; LCSC C55968414
R61, R62, R63, R64, R65, R66: 2k; R_0402_1005Metric; LCSC C4109
RN1, RN2, RN3, RN4, RN5: 75; RES-ARRAY-SMD_0402-8P-L2.0-W1.0-BL; LCSC C39128
SW1, SW2: TS-1187A-B-A-B; SW-SMD_4P-L5.1-W5.1-P3.70-LS6.5-TL_H1.5; LCSC C318884
U1: ADV7842KBCZ-5; CSPBGA-256_L17.0-W17.0-R16-C16-P1.00-BL; LCSC C514382
U2: ADV7511KSTZ; LQFP-100_L14.0-W14.0-P0.50-LS16.0-BL; LCSC C179459
U3: PCM1808PWR; TSSOP-14_L5.0-W4.4-P0.65-LS6.4-BL; LCSC C55513
U4: TLV62569DBVR; SOT-23-5_L3.0-W1.7-P0.95-LS2.8-BR; LCSC C141836
U5, U6, U7: TPS7A7001DDAR; SOIC-8_L4.9-W3.9-P1.27-LS6.0-BL-EP; LCSC C60719
U8, U9, U10: TPD4E05U06DQAR; USON-10_L2.5-W1.0-P0.50-BL; LCSC C138714
Y1: 28.63636MHz 20pF; CRYSTAL-SMD_L5.0-W3.2; LCSC C362486

Connections:
1V8A: C12.1, C13.1, FL1.1 (IN), FL2.1 (IN), FL3.1 (IN), FL4.1 (IN), R8.1, U6.6 (OUT)
1V8B: C15.1, C16.1, L2.1, L3.1, L4.1, R10.1, U7.6 (OUT)
2V5: C8.1, C9.1, C11.1, C14.1, L1.2, R5.1, R7.1, U6.3 (IN), U7.3 (IN)
3V3: C5.1, C6.1, C108.1, C109.1, C124.1, FL5.1 (IN), FL6.1 (IN), R1.1, R2.1, R3.1, R20.1, R21.1, R23.1, R24.1, R25.1, R61.1, R62.1, R63.1, U2.47 (MVDD), U3.4 (VDD), U5.6 (OUT)
5VA: C106.1, C107.1, FB1.2, U3.3 (VCC)
+5V: C1.1, C2.1, C3.1, C4.1, C7.1, F1.1, FB1.1, J9.11, J10.11, U1.C8 (RXB_5V), U1.C9 (RXA_5V), U4.1 (EN), U4.4 (VIN), U5.2 (EN), U5.3 (IN)
AIN_PB: C33.2, U1.J13 (AIN6)
AIN_PR: C34.2, U1.K13 (AIN5)
AIN_Y: C32.2, U1.J14 (AIN4)
AUD_DIV_L: C110.1, C111.1, R52.2, R53.1
AUD_DIV_R: C112.1, C113.1, R54.2, R55.1
AUD_VINL: C111.2, U3.13 (VINL)
AUD_VINR: C113.2, U3.14 (VINR)
AV_AVDD: C19.1, C20.1, C54.1, C55.1, C56.1, C57.1, C58.1, C59.1, C60.1, C61.1, C62.1, C63.1, C64.1, C65.1, C66.1, C67.1, FL2.3 (OUT), U1.F12 (AVDD), U1.G12 (AVDD), U1.H12 (AVDD), U1.J12 (AVDD), U1.K12 (AVDD), U1.L12 (AVDD)
AV_C0: RN1.1, U1.B2 (P4)
AV_C1: RN1.2, U1.B1 (P5)
AV_C2: RN1.3, U1.C2 (P6)
AV_C3: RN1.4, U1.C1 (P7)
AV_C4: RN2.3, U1.D2 (P8)
AV_C5: RN2.4, U1.D1 (P9)
AV_C6: RN3.2, U1.E2 (P10)
AV_C7: RN3.3, U1.F2 (P11)
AV_CVDD: C21.1, C22.1, C68.1, C69.1, C70.1, C71.1, FL3.3 (OUT), U1.C12 (CVDD), U1.C13 (CVDD), U1.C14 (CVDD), U1.D12 (CVDD), U1.E11 (CVDD), U1.E12 (CVDD)
AV_DE: RN3.1, U1.D4 (FIELD/DE)
AV_DVDDIO: C25.1, C26.1, C79.1, C80.1, C81.1, C82.1, C83.1, C84.1, C85.1, C86.1, C87.1, C88.1, C89.1, C90.1, C91.1, C92.1, C93.1, C94.1, C95.1, C96.1, C97.1, C98.1, C99.1, C100.1, C101.1, FL5.3 (OUT), U1.F5 (DVDDIO), U1.G5 (DVDDIO), U1.H5 (DVDDIO), U1.J5 (DVDDIO), U1.K5 (DVDDIO), U1.L5 (DVDDIO), U1.M5 (DVDDIO), U1.M6 (VDD_SDRAM), U1.M7 (VDD_SDRAM), U1.M8 (VDD_SDRAM), U1.M9 (VDD_SDRAM), U1.M10 (VDD_SDRAM)
AV_HS: RN2.2, U1.C4 (HS/CS)
AV_LLC: RN5.4, U1.N1 (LLC)
AV_PVDD: C23.1, C24.1, C102.1, C103.1, FL4.3 (OUT), U1.D15 (PVDD), U1.D16 (PVDD)
AV_TVDD: C27.1, C28.1, C41.1, C42.1, C43.1, C44.1, C45.1, C46.1, C47.1, C48.1, C49.1, C50.1, C51.1, C52.1, C53.1, FL6.3 (OUT), U1.A5 (TVDD), U1.A15 (TVDD), U1.B5 (TVDD), U1.B15 (TVDD)
AV_VDD: C17.1, C18.1, C72.1, C73.1, C74.1, C75.1, C76.1, C77.1, C78.1, FL1.3 (OUT), U1.J7 (VDD), U1.K6 (VDD), U1.K7 (VDD), U1.K8 (VDD), U1.K9 (VDD), U1.L6 (VDD), U1.L7 (VDD), U1.L8 (VDD), U1.L9 (VDD)
AV_VS: RN2.1, U1.C3 (VS/FIELD)
AV_Y0: RN3.4, U1.H1 (P16)
AV_Y1: RN4.1, U1.J2 (P17)
AV_Y2: RN4.2, U1.J1 (P18)
AV_Y3: RN4.3, U1.K2 (P19)
AV_Y4: RN4.4, U1.K1 (P20)
AV_Y5: RN5.1, U1.L2 (P21)
AV_Y6: RN5.2, U1.L1 (P22)
AV_Y7: RN5.3, U1.M2 (P23)
EN_1V8: C10.1, R7.2, U6.2 (EN), U7.2 (EN)
FB_1V8A: C13.2, R8.2, R9.1, U6.7 (FB)
FB_1V8B: C16.2, R10.2, R11.1, U7.7 (FB)
FB_2V5: C9.2, R5.2, R6.1, U4.5 (FB)
FB_3V3: C6.2, R3.2, R4.1, U5.7 (FB)
FMT: R51.1, U3.12 (FMT)
GND: C1.2, C2.2, C3.2, C4.2, C5.2, C7.2, C8.2, C10.2, C11.2, C12.2, C14.2, C15.2, C17.2, C18.2, C19.2, C20.2, C21.2, C22.2, C23.2, C24.2, C25.2, C26.2, C27.2, C28.2, C29.2, C30.2, C31.2, C36.2, C37.2, C38.2, C39.2, C41.2, C42.2, C43.2, C44.2, C45.2, C46.2, C47.2, C48.2, C49.2, C50.2, C51.2, C52.2, C53.2, C54.2, C55.2, C56.2, C57.2, C58.2, C59.2, C60.2, C61.2, C62.2, C63.2, C64.2, C65.2, C66.2, C67.2, C68.2, C69.2, C70.2, C71.2, C72.2, C73.2, C74.2, C75.2, C76.2, C77.2, C78.2, C79.2, C80.2, C81.2, C82.2, C83.2, C84.2, C85.2, C86.2, C87.2, C88.2, C89.2, C90.2, C91.2, C92.2, C93.2, C94.2, C95.2, C96.2, C97.2, C98.2, C99.2, C100.2, C101.2, C102.2, C103.2, C104.2, C105.2, C106.2, C107.2, C108.2, C109.2, C110.2, C112.2, C114.2, C115.2, C116.2, C117.2, C118.2, C119.2, C120.2, C121.2, C122.2, C123.2, C124.2, C125.2, FL1.2 (GND), FL2.2 (GND), FL3.2 (GND), FL4.2 (GND), FL5.2 (GND), FL6.2 (GND), J1.1, J2.1, J3.1, J4.1, J5.1, J6.2 (TMDSData2Shield), J6.5 (TMDSData1Shield), J6.8 (TMDSData0Shield), J6.11 (TMDSClockShield), J6.17 (DDC/CECGround), J6.20, J6.21, J6.22, J6.23, J9.12, J9.31, J9.32, J9.33, J9.34, J9.35, J9.36, J10.12, J10.27, J10.28, J10.29, J10.30, J10.33, J10.34, J10.35, J10.36, J10.37, J10.38, J10.39, J10.40, R4.2, R6.2, R9.2, R11.2, R13.2, R15.2, R17.2, R19.2, R22.2, R26.2, R27.2, R28.2, R29.2, R30.2, R31.2, R32.2, R33.2, R34.2, R35.2, R36.2, R37.2, R38.2, R39.2, R40.2, R41.2, R42.2, R43.2, R44.2, R45.2, R46.2, R47.2, R48.2, R49.2, R50.2, R51.2, R53.2, R55.2, R60.2, R64.2, R67.2, SW1.4 (D), SW2.4 (D), U1.A1 (GND), U1.A10 (GND), U1.A16 (GND), U1.B10 (GND), U1.C5 (GND), U1.C15 (GND), U1.D5 (GND), U1.E1 (GND), U1.E5 (GND), U1.E6 (GND), U1.E7 (GND), U1.E8 (GND), U1.E9 (GND), U1.E10 (GND), U1.F6 (GND), U1.F7 (GND), U1.F8 (GND), U1.F9 (GND), U1.F10 (GND), U1.F11 (GND), U1.F15 (TRI4), U1.G6 (GND), U1.G7 (GND), U1.G8 (GND), U1.G9 (GND), U1.G10 (GND), U1.G11 (GND), U1.G14 (SYNC4), U1.H6 (GND), U1.H7 (GND), U1.H8 (GND), U1.H9 (GND), U1.H10 (GND), U1.H11 (GND), U1.H16 (SYNC3), U1.J6 (GND), U1.J8 (GND), U1.J9 (GND), U1.J10 (GND), U1.J11 (GND), U1.J16 (GND), U1.K10 (GND), U1.K11 (GND), U1.L10 (GND), U1.L11 (GND), U1.M1 (GND), U1.M11 (GND), U1.M12 (GND), U1.M13 (GND), U1.M14 (GND), U1.M15 (GND), U1.M16 (GND), U1.N4 (TEST4), U1.P3 (TEST5), U1.P13 (SDRAM_VREF), U1.T1 (GND), U1.T6 (GND), U1.T12 (GND), U1.T16 (GND), U2.3 (DSD0), U2.4 (DSD1), U2.5 (DSD2), U2.6 (DSD3), U2.7 (DSD4), U2.8 (DSD5), U2.9 (DSDCLK), U2.10 (SPDIF), U2.13 (I2S1), U2.14 (I2S2), U2.15 (I2S3), U2.18 (GND), U2.20 (GND), U2.22 (GND), U2.23 (GND), U2.27 (GND), U2.31 (GND), U2.37 (GND), U2.44 (GND), U2.48 (CEC), U2.50 (CEC_CLK), U2.51 (HEAC-), U2.52 (HEAC+), U2.57 (D35), U2.58 (D34), U2.59 (D33), U2.60 (D32), U2.61 (D31), U2.62 (D30), U2.63 (D29), U2.64 (D28), U2.65 (D27), U2.66 (D26), U2.67 (D25), U2.68 (D24), U2.75 (GND), U2.89 (D7), U2.90 (D6), U2.91 (D5), U2.92 (D4), U2.93 (D3), U2.94 (D2), U2.95 (D1), U2.96 (D0), U2.99 (GND), U2.100 (GND), U3.2 (AGND), U3.5 (DGND), U4.2 (GND), U5.1 (NC), U5.4 (NC), U5.5 (NC), U5.8 (GND), U5.9 (EP), U6.1 (NC), U6.4 (NC), U6.5 (NC), U6.8 (GND), U6.9 (EP), U7.1 (NC), U7.4 (NC), U7.5 (NC), U7.8 (GND), U7.9 (EP), U8.3 (GND), U8.8 (GND), U9.3 (GND), U9.8 (GND), U10.3 (GND), U10.8 (GND)
HDMI_5V: C125.1, F1.2, J6.18 (+5VPower), R65.1, R66.1, U8.5 (D2-), U8.6 (NC)
HDMI_HPD: J6.19 (HotPlugDetect), R67.1, U2.30 (HPD), U8.4 (D2+), U8.7 (NC)
HDMI_SCL: J6.15 (SCL), R65.2, U2.53 (DDCSCL), U8.1 (D1+), U8.10 (NC)
HDMI_SDA: J6.16 (SDA), R66.2, U2.54 (DDCSDA), U8.2 (D1-), U8.9 (NC)
IN_BCK: J9.40, U3.8 (BCK)
IN_C0: J10.1, RN1.8
IN_C1: J10.2, RN1.7
IN_C2: J10.3, RN1.6
IN_C3: J10.4, RN1.5
IN_C4: J10.7, RN2.6
IN_C5: J10.8, RN2.5
IN_C6: J10.10, RN3.7
IN_C7: J10.13, RN3.6
IN_DE: J10.9, RN3.8
IN_DOUT: J9.39, U3.9 (DOUT)
IN_HS: J10.6, RN2.7
IN_INT1: J10.24, R23.2, U1.M4 (INT1)
IN_KEY1: J10.31, R1.2, SW1.1 (A)
IN_KEY2: J10.32, R2.2, SW2.1 (A)
IN_LLC: J10.20, RN5.5
IN_LRCK: J9.38, U3.7 (LRCK)
IN_RESET_N: J10.26, R22.1, U1.N5 (~RESET)
IN_SCKI: J9.37, U3.6 (SCKI)
IN_SCL: J10.23, R20.2, U1.L3 (SCL)
IN_SDA: J10.25, R21.2, U1.M3 (SDA)
IN_VS: J10.5, RN2.8
IN_Y0: J10.14, RN3.5
IN_Y1: J10.15, RN4.8
IN_Y2: J10.16, RN4.7
IN_Y3: J10.17, RN4.6
IN_Y4: J10.18, RN4.5
IN_Y5: J10.19, RN5.8
IN_Y6: J10.21, RN5.7
IN_Y7: J10.22, RN5.6
MD0: R49.1, U3.10 (MD0)
MD1: R50.1, U3.11 (MD1)
OUT_C0: J9.15, U2.80 (D16)
OUT_C1: J9.13, U2.78 (D17)
OUT_C2: J9.10, U2.74 (D18)
OUT_C3: J9.9, U2.73 (D19)
OUT_C4: J9.8, U2.72 (D20)
OUT_C5: J9.7, U2.71 (D21)
OUT_C6: J9.6, U2.70 (D22)
OUT_C7: J9.5, U2.69 (D23)
OUT_CLK: J9.14, U2.79 (CLK)
OUT_DE: J9.24, U2.97 (DE)
OUT_HSYNC: J9.25, U2.98 (HSYNC)
OUT_I2S0: J9.28, R59.1
OUT_INT: J9.2, R63.2, U2.45 (INT)
OUT_LRCLK: J9.30, R58.1
OUT_MCLK: J9.27, R56.1
OUT_PD: J9.1, R64.1, U2.38 (PD)
OUT_SCL: J9.3, R61.2, U2.55 (SCL)
OUT_SCLK: J9.29, R57.1
OUT_SDA: J9.4, R62.2, U2.56 (SDA)
OUT_VSYNC: J9.26, U2.2 (VSYNC)
OUT_Y0: J9.23, U2.88 (D8)
OUT_Y1: J9.22, U2.87 (D9)
OUT_Y2: J9.21, U2.86 (D10)
OUT_Y3: J9.20, U2.85 (D11)
OUT_Y4: J9.19, U2.84 (D12)
OUT_Y5: J9.18, U2.83 (D13)
OUT_Y6: J9.17, U2.82 (D14)
OUT_Y7: J9.16, U2.81 (D15)
PD_DDCA_SCL: R28.1, U1.D10 (DDCA_SCL)
PD_DDCB_SCL: R27.1, U1.D8 (DDCB_SCL)
PD_SDRAM_DQ0: R31.1, U1.R13 (SDRAM_DQ0)
PD_SDRAM_DQ1: R32.1, U1.T13 (SDRAM_DQ1)
PD_SDRAM_DQ2: R33.1, U1.R12 (SDRAM_DQ2)
PD_SDRAM_DQ3: R34.1, U1.P12 (SDRAM_DQ3)
PD_SDRAM_DQ4: R35.1, U1.N12 (SDRAM_DQ4)
PD_SDRAM_DQ5: R36.1, U1.T11 (SDRAM_DQ5)
PD_SDRAM_DQ6: R37.1, U1.R11 (SDRAM_DQ6)
PD_SDRAM_DQ7: R38.1, U1.P11 (SDRAM_DQ7)
PD_SDRAM_DQ8: R39.1, U1.R16 (SDRAM_DQ8)
PD_SDRAM_DQ9: R40.1, U1.R15 (SDRAM_DQ9)
PD_SDRAM_DQ10: R41.1, U1.T15 (SDRAM_DQ10)
PD_SDRAM_DQ11: R42.1, U1.N14 (SDRAM_DQ11)
PD_SDRAM_DQ12: R43.1, U1.P14 (SDRAM_DQ12)
PD_SDRAM_DQ13: R44.1, U1.R14 (SDRAM_DQ13)
PD_SDRAM_DQ14: R45.1, U1.T14 (SDRAM_DQ14)
PD_SDRAM_DQ15: R46.1, U1.N13 (SDRAM_DQ15)
PD_SDRAM_LDQS: R47.1, U1.N11 (SDRAM_LDQS)
PD_SDRAM_UDQS: R48.1, U1.P15 (SDRAM_UDQS)
PD_TTX_SCL: R30.1, U1.F4 (TTX_SCL)
PD_VGA_SCL: R29.1, U1.D13 (VGA_SCL)
PWRDN1: R24.2, U1.C10 (~PWRDN1)
RCA_L: J4.2, R52.1
RCA_PB: J2.2, R14.1
RCA_PR: J3.2, R16.1
RCA_R: J5.2, R54.1
RCA_Y: J1.2, R12.1
REFN: C39.1, C40.2, U1.E16 (REFN)
REFP: C38.1, C40.1, U1.E15 (REFP)
RTERM: R19.1, U1.D11 (RTERM)
R_EXT: R60.1, U2.28 (R_EXT)
SW_2V5: L1.1, U4.3 (SW)
SYNC_Y: C35.2, U1.J15 (SYNC2)
TERM_PB: C33.1, R14.2, R15.1
TERM_PR: C34.1, R16.2, R17.1
TERM_Y: C32.1, C35.1, R12.2, R13.1
TEST8: R25.2, R26.1, U1.C11 (TEST8)
TMDS_CK_N: J6.12 (TMDSClock-), U2.32 (TXC-), U10.5 (D2-), U10.6 (NC)
TMDS_CK_P: J6.10 (TMDSClock+), U2.33 (TXC+), U10.4 (D2+), U10.7 (NC)
TMDS_D0_N: J6.9 (TMDSData0-), U2.35 (TX0-), U10.2 (D1-), U10.9 (NC)
TMDS_D0_P: J6.7 (TMDSData0+), U2.36 (TX0+), U10.1 (D1+), U10.10 (NC)
TMDS_D1_N: J6.6 (TMDSData1-), U2.39 (TX1-), U9.5 (D2-), U9.6 (NC)
TMDS_D1_P: J6.4 (TMDSData1+), U2.40 (TX1+), U9.4 (D2+), U9.7 (NC)
TMDS_D2_N: J6.3 (TMDSData2-), U2.42 (TX2-), U9.2 (D1-), U9.9 (NC)
TMDS_D2_P: J6.1 (TMDSData2+), U2.43 (TX2+), U9.1 (D1+), U9.10 (NC)
TX_AVDD: C30.1, C118.1, C119.1, C120.1, C121.1, L3.2, U2.24 (PVDD), U2.25 (PVDD), U2.29 (AVDD), U2.34 (AVDD), U2.41 (AVDD)
TX_DVDD: C29.1, C114.1, C115.1, C116.1, C117.1, L2.2, U2.1 (DVDD), U2.19 (DVDD), U2.49 (DVDD), U2.76 (DVDD), U2.77 (DVDD)
TX_I2S0: R59.2, U2.12 (I2S0)
TX_LRCLK: R58.2, U2.17 (LRCLK)
TX_MCLK: R56.2, U2.11 (MCLK)
TX_PLVDD: C31.1, C122.1, C123.1, L4.2, U2.21 (PLVDD), U2.26 (BGVDD)
TX_SCLK: R57.2, U2.16 (SCLK)
VREF: C104.1, C105.1, U3.1 (VREF)
XTALN: C37.1, R18.2, U1.C16 (XTALN), Y1.2 (OSC2)
XTALP: C36.1, R18.1, U1.B16 (XTALP), Y1.1 (OSC1)

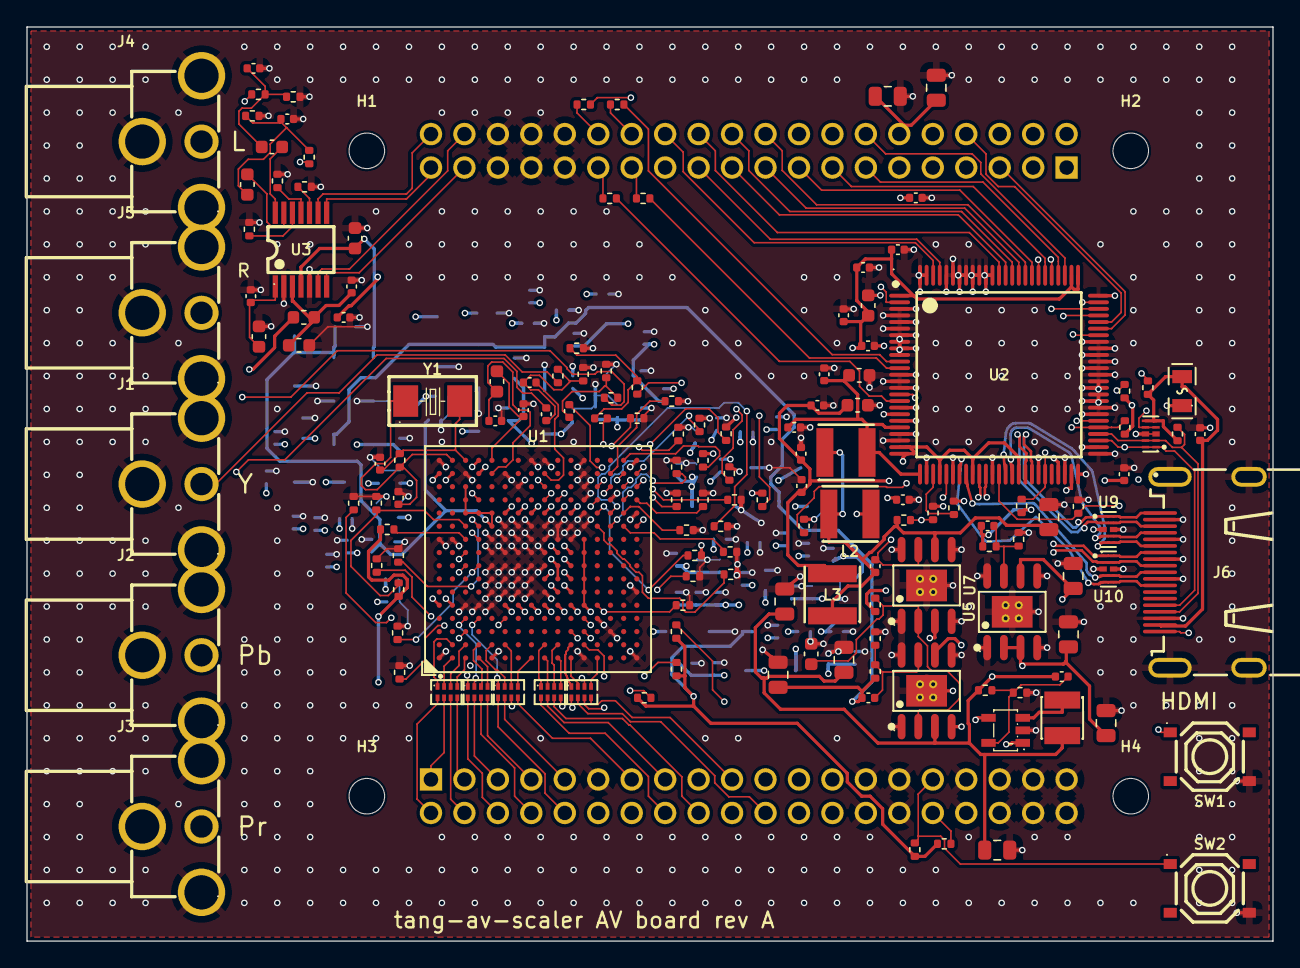
[picture p30: board av-board-a.kicad_pcb from above]

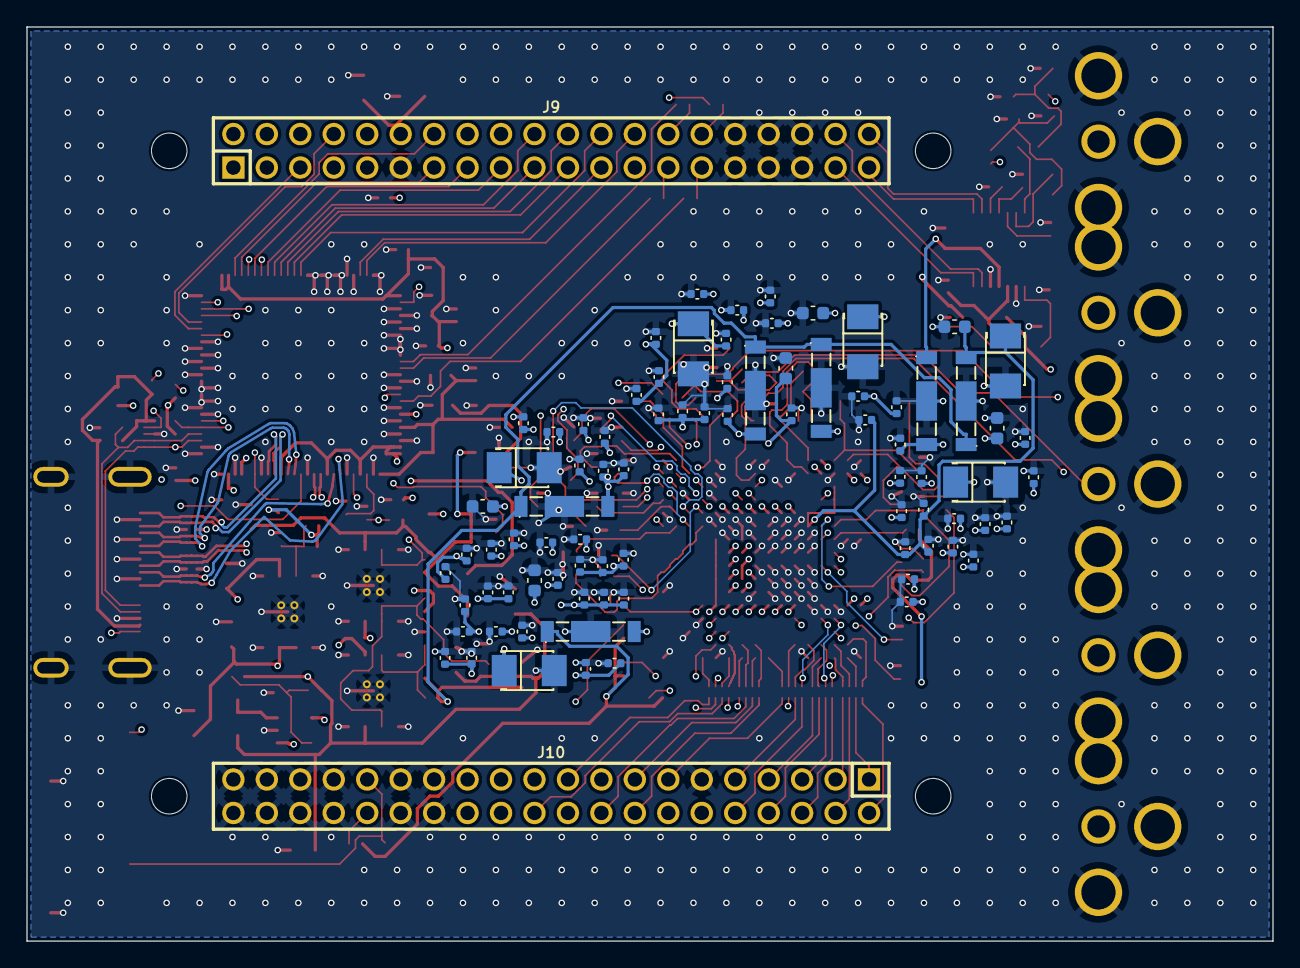
[picture p31: board av-board-a.kicad_pcb from below]

Board: 6 copper layers, 94.6 x 69.4 mm, 234 parts (83 on the bottom side), 166 nets.

Other parts of the board:
H1, H2, H3, H4: MountingHole_2.7mm_M2.5
