bryfur/tang-av-scaler/hardware/av-board/rev-cb/av-board-cb.kicad_pcb

## KiCad design hardware/av-board/rev-cb/av-board-cb.kicad_pcb (2026-10-28)

Schematic: av-board-cb.kicad_sch, Tang Console AV board rev C-B

Parts:
C1, C2: 47u; C_1206_3216Metric; LCSC C96123
C3, C17, C18, C19, C24, C25, C27, C30, C33, C35, C38, C39, C40, C41, C42, C44, C46, C48, C50, C52, C55, C57, C59, C65, C66, C67, C68, C69, C71, C72, C73, C74, C75, C80, C81, C82, C83, C87, C88, C89, C90, C91, C92, C93, C94, C95, C97, C98, C101, C102, C103, C104, C105: 100n; C_0402_1005Metric; LCSC C1525
C4, C6, C7, C9, C10, C12, C70, C84, C85: 10u; C_0805_2012Metric; LCSC C15850
C5, C86: 6.8p; C_0402_1005Metric; LCSC C1576
C8, C11, C61, C63: 220p; C_0402_1005Metric; LCSC C1530
C13, C14, C15, C16, C56, C58, C60, C77, C79, C96, C100: 10u; C_0603_1608Metric; LCSC C19702
C20, C21: 1n; C_0402_1005Metric; LCSC C1523
C22, C23: 33p; C_0402_1005Metric; LCSC C1562
C26, C29, C32, C34: 10u; C_0402_1005Metric; LCSC C15525
C28, C31, C37, C43, C45, C47, C49, C51, C53, C99, C106, C107: 10n; C_0402_1005Metric; LCSC C15195
C36: 82n; C_0402_1005Metric; LCSC C277511
C54, C62, C64, C76, C78: 1u; C_0603_1608Metric; LCSC C15849
C108, C109, C110, C111: 22u; C_0805_2012Metric; LCSC C45783
D1, D3: B5819W; D_SOD-123; LCSC C8598
D2, D4, D5: KT-0603R; LED-SMD_L1.6-W0.8-R-RD; LCSC C2286
D6: SMF5.0A; D_SMF; LCSC C2857263
D7: 1N4148WS; D_SOD-323; LCSC C2128
D8, D9, D10, D11, D12, D13: TPD1E05U06DPYR; X1SON-2_L1.0-W0.6-P0.65-RD-1; LCSC C436349
F1: 3A; Fuse_1812_4532Metric; LCSC C18198349
F2, F3: 0.2A; F0805; LCSC C883105
FB1, FB2, FB3, FB4: 120R; L_0603_1608Metric; LCSC C14709
J1: RCA Y; CONN-TH_RCJ-011; LCSC C4991844
J2: RCA Pb; CONN-TH_RCJ-011; LCSC C4991844
J3: RCA Pr; CONN-TH_RCJ-011; LCSC C4991691
J4: RCA L; CONN-TH_RCJ-011; LCSC C4991844
J5: RCA R; CONN-TH_RCJ-011; LCSC C4991691
J6: HDMI-001; HDMI-SMD_19P-P0.50-H-F; LCSC C138388
J7: SYNC; HDR-TH_2P-P2.54-V-M; LCSC C492401
J8: VGA; HDR-TH_16P-P2.54-V-M-R2-C8-S2.54; LCSC C68234
J11: XIAO 5V..D7; HDR-TH_7P-P2.54-V-F; LCSC C22438157
J12: XIAO D0..D6; HDR-TH_7P-P2.54-V-F; LCSC C22438157
J13: SPDIF; HDR-TH_5P-P2.54-V-M; LCSC C492404
J15: USB-C 5V; USB-C_SMD-TYPE-C-31-M-12_1; LCSC C165948
J16: JTAG; HDR-TH_6P-P2.54-V-M; LCSC C492405
J17: DEBUG; HDR-TH_16P-P2.54-V-M-R2-C8-S2.54; LCSC C68234
J20: DF40HC(3.0)-80DS; DF40HC-3.0-80DS-SOM; LCSC C2858577
J21, J22: DF40HC(3.0)-100DS; DF40HC-3.0-100DS-SOM; LCSC C424649
L1, L2: 2.2uH; IND-SMD_L3.0-W3.0_FNR30XXS; LCSC C167747
Q1, Q2, Q3, Q4, Q5: 2N7002; SOT-23-3_L2.9-W1.3-P1.90-LS2.4-BR; LCSC C8545
R1, R2, R114, R115: 5.1k; R_0402_1005Metric; LCSC C25905
R3: 499k; R_0402_1005Metric; LCSC C25793
R4, R51, R53, R91: 100k; R_0402_1005Metric; LCSC C25741
R5: 169k; R_0402_1005Metric; LCSC C25758
R6, R8: 30.1k; R_0402_1005Metric; LCSC C29402
R7: 78.7k; R_0402_1005Metric; LCSC C67239
R9, R10, R11, R12, R30, R31, R32, R48: 75; R_0603_1608Metric; LCSC C4275
R13, R49: 1M; R_0402_1005Metric; LCSC C26083
R14: 1.69k; R_0402_1005Metric; LCSC C25870
R15, R16, R17, R18, R19, R20, R21, R22, R35, R36, R50, R52, R87: 33; R_0402_1005Metric; LCSC C25105
R23, R24, R25, R26, R27, R28, R37, R39, R85, R86, R96, R97: 4.7k; R_0402_1005Metric; LCSC C25900
R29, R33, R34, R41, R42, R43, R45, R47, R58, R59, R60, R61, R62, R63, R64, R65, R66, R67, R68, R69, R70, R71, R72, R73, R74, R76, R78, R79, R83, R94, R95, R99: 10k; R_0402_1005Metric; LCSC C25744
R38, R40: 47k; R_0402_1005Metric; LCSC C25792
R44, R46: 12k; R_0402_1005Metric; LCSC C25752
R54, R55, R56, R57, R75, R77, R80: 470; R_0402_1005Metric; LCSC C25117
R81, R82, R92, R93: 2k; R_0402_1005Metric; LCSC C4109
R84: 27k; R_0402_1005Metric; LCSC C25771
R88, R89: 2.2; R_0402_1005Metric; LCSC C2909330
R90: 82.5k; R_0402_1005Metric; LCSC C11717
R98: 7.06k; R_0402_1005Metric; LCSC C853722
R100, R101, R102, R103, R104, R105, R106, R107, R108, R109, R110, R111, R112: 220; R_0402_1005Metric; LCSC C25091
R113: 1k; R_0402_1005Metric; LCSC C11702
RN1, RN2, RN3: 33; RES-ARRAY-SMD_0402-8P-L2.0-W1.0-BL; LCSC C25501
SO1, SO2, SO3, SO4: M2 spacer 3mm; SOM-M2-Hole
SW1, SW2, SW3: TS-1187A-B-A-B; SW-SMD_4P-L5.1-W5.1-P3.70-LS6.5-TL_H1.5; LCSC C318884
TP1: +5V; TestPoint_Pad_D1.5mm
TP2: 3V6; TestPoint_Pad_D1.5mm
TP3: 3V3; TestPoint_Pad_D1.5mm
TP4: 1V8A; TestPoint_Pad_D1.5mm
TP5: 1V1; TestPoint_Pad_D1.5mm
TP6: 3V0; TestPoint_Pad_D1.5mm
TP7: 2V5; TestPoint_Pad_D1.5mm
TP8: 5VA; TestPoint_Pad_D1.5mm
TP9, TP10: GND; TestPoint_THTPad_D2.0mm_Drill1.0mm
U1: ADV7181DBCPZ-RL; LFCSP-64_L9.0-W9.0-P0.50-BL-EP7.1; LCSC C514378
U2: SN65DP159RGZR; VQFN-48_L7.0-W7.0-P0.50-BL-EP4.1; LCSC C179676
U3: PCM1808PWR; TSSOP-14_L5.0-W4.4-P0.65-LS6.4-BL; LCSC C55513
U4, U7: TLV62569DBVR; SOT-23-5_L3.0-W1.7-P0.95-LS2.8-BR; LCSC C141836
U5, U6: TPS7A7001DDAR; SOIC-8_L4.9-W3.9-P1.27-LS6.0-BL-EP; LCSC C60719
U8, U9, U10, U19, U20: TPD4E05U06DQAR; USON-10_L2.5-W1.0-P0.50-BL; LCSC C138714
U12: TPS7A2045PDBVR; SOT-23-5_L2.9-W1.6-P0.95-LS2.8-BR; LCSC C2873627
U13: SN74LVC1GU04DBVR; SOT-23-5_L3.0-W1.7-P0.95-LS2.8-BR; LCSC C81934
U14, U15: SN74LVC1G04DBVR; SOT-23-5_L3.0-W1.7-P0.95-LS2.8-BR; LCSC C7827
U17: MS5351M; MSOP-10_L3.0-W3.0-P0.50-LS5.0-BL; LCSC C1509083
U18: ME6211C25M5G-N; SOT-23-5_L3.0-W1.7-P0.95-LS2.8-BR; LCSC C194395
U21: SN74LVC2G17DBVR; SOT-23-6_L2.9-W1.6-P0.95-LS2.8-BL; LCSC C10429
U22: SN74LVC8T245PWR; TSSOP-24_L7.8-W4.4-P0.65-LS6.4-BL; LCSC C27643
U23: SN74AVC4T245PWR; TSSOP-16_L5.0-W4.4-P0.65-LS6.4-BL; LCSC C81461
U24: ME6211C30M5G-N; SOT-23-5_L2.9-W1.6-P0.95-LS2.8-BL; LCSC C403651
Y1: 28.63636MHz 20pF; CRYSTAL-SMD_L5.0-W3.2; LCSC C112564
Y2: 25MHz 10pF; CRYSTAL-SMD_4P-L2.0-W1.6-BL; LCSC C5265839

Connections:
1V1: C85.1, C86.1, C100.1, C101.1, C102.1, C103.1, C104.1, C105.1, C106.1, C107.1, L2.2, R90.1, TP5.1, U2.14 (VDD), U2.23 (VDD), U2.24 (VDD), U2.37 (VDD), U2.48 (VDD)
1V8A: C11.1, C12.1, D1.2 (A), FB1.1, FB2.1, R7.1, TP4.1, U6.6 (OUT)
2V5: C79.1, C81.1, TP7.1, U17.7 (VDDO), U18.5 (VOUT)
3V0: C77.1, C80.1, TP6.1, U17.1 (VDD), U24.5 (VOUT)
3V3: C8.1, C9.1, C10.1, C41.1, C59.1, C60.1, C67.1, C68.1, C69.1, C72.1, C74.1, C76.1, C78.1, C96.1, C97.1, C98.1, C99.1, D1.1 (K), FB3.1, FB4.1, J16.1, Q1.1 (G), Q2.1 (G), Q5.1 (G), R5.1, R23.1, R24.1, R37.1, R39.1, R65.2, R67.2, R68.2, R69.2, R70.2, R71.2, R72.2, R73.1, R74.1, R75.1, R76.1, R77.1, R78.1, R79.1, R84.1, R85.1, R86.1, R92.1, R93.1, R94.1, R96.1, R97.1, R99.1, R100.1, R113.1, TP3.1, U2.13 (VCC), U2.43 (VCC), U3.4 (VDD), U5.6 (OUT), U6.2 (EN), U6.3 (IN), U13.5 (VCC), U14.5 (VCC), U15.5 (VCC), U18.1 (VIN), U18.3 (CE), U21.5 (VCC), U22.23 (VCCB), U22.24 (VCCB), U23.16 (VCCB), U24.1 (VIN), U24.3 (CE)
3V6: C5.1, C6.1, C7.1, L1.2, R3.1, TP2.1, U5.2 (EN), U5.3 (IN)
5VA: C57.1, C58.1, TP8.1, U3.3 (VCC), U12.5 (OUT)
+5V: C1.1, C2.1, C3.1, C4.1, C54.1, C84.1, C108.1, C109.1, C110.1, C111.1, D3.2 (A), F1.2, F2.1, F3.1, J22.89, J22.91, J22.93, J22.95, J22.97, J22.99, TP1.1, U4.1 (EN), U4.4 (VIN), U7.1 (EN), U7.4 (VIN), U12.1 (IN), U12.3 (EN)
AIN_PB: C18.2, U1.47 (AIN8)
AIN_PR: C19.2, U1.45 (AIN6)
AIN_VB: C40.2, U1.48 (AIN9)
AIN_VG: C39.2, U1.35 (AIN2)
AIN_VR: C38.2, U1.46 (AIN7)
AIN_Y: C17.2, U1.49 (AIN10)
ALSB: R27.2, U1.52 (ALSB)
AUD_DIV_L: C61.1, C62.1, R44.2, R45.1
AUD_DIV_R: C63.1, C64.1, R46.2, R47.1
AUD_VINL: C62.2, U3.13 (VINL)
AUD_VINR: C64.2, U3.14 (VINR)
AV_AVDD: C15.1, C52.1, C53.1, FB3.2, U1.41 (AVDD)
AV_C0: R19.1, U1.26 (P2)
AV_C1: R18.1, U1.25 (P3)
AV_C2: RN3.3, U1.19 (P4)
AV_C3: RN3.2, U1.18 (P5)
AV_C4: RN3.1, U1.17 (P6)
AV_C5: R17.1, U1.16 (P7)
AV_C6: R16.1, U1.15 (P8)
AV_C7: R15.1, U1.14 (P9)
AV_DE: R22.1, U1.63 (FIELD/DE)
AV_DVDD: C13.1, C46.1, C47.1, C48.1, C49.1, FB1.2, U1.23 (DVDD), U1.58 (DVDD)
AV_DVDDIO: C16.1, C42.1, C43.1, C44.1, C45.1, FB4.2, R26.1, R27.1, R28.1, U1.4 (DVDDIO), U1.11 (DVDDIO)
AV_HS: R20.1, U1.2 (HS/CS)
AV_LLC: RN3.4, U1.20 (LLC)
AV_PVDD: C14.1, C36.2, C37.2, C50.1, C51.1, FB2.2, U1.31 (PVDD)
AV_VS: R21.1, U1.64 (VS)
AV_Y0: RN2.4, U1.8 (P12)
AV_Y1: RN2.3, U1.7 (P13)
AV_Y2: RN2.2, U1.6 (P14)
AV_Y3: RN2.1, U1.5 (P15)
AV_Y4: RN1.4, U1.62 (P16)
AV_Y5: RN1.3, U1.61 (P17)
AV_Y6: RN1.2, U1.60 (P18)
AV_Y7: RN1.1, U1.59 (P19)
CAPC2: C29.1, C30.1, C31.1, U1.44 (CAPC2)
CAPY1: C26.1, C27.1, C28.1, U1.39 (CAPY1)
CAPY2: C24.1, C25.1, C26.2, C27.2, C28.2, C29.2, C30.2, C31.2, U1.40 (CAPY2)
CC1: J15.A5 (CC1), R1.1
CC2: J15.B5 (CC2), R2.1
CEC_FPGA: J21.53, Q5.2 (S), R99.2
CEC_PU: D7.2 (A), R84.2
CML: C34.1, C35.1, U1.43 (CML)
D4_A: D4.1 (A), R75.2
D4_K: D4.2 (K), Q3.3 (D)
D5_A: D5.1 (A), R77.2
D5_K: D5.2 (K), Q4.3 (D)
DBG0: J22.36, R107.1
DBG0_J: J17.9, R107.2
DBG1: J22.34, R108.1
DBG1_J: J17.10, R108.2
DBG2: J22.32, R109.1
DBG2_J: J17.11, R109.2
DBG3: J22.30, R110.1
DBG3_J: J17.12, R110.2
DBG4: J22.28, R111.1
DBG4_J: J17.13, R111.2
DBG5: J22.26, R112.1
DBG5_J: J17.14, R112.2
DBG_VREF: J17.1, R100.2
DDC_SCL: J21.60, R93.2, U2.46 (SCL_SRC)
DDC_SDA: J21.58, R92.2, U2.47 (SDA_SRC)
DP_A0: R95.1, U2.21 (EQ_SEL/A0)
DP_CK_N: C94.2, U2.12 (IN_CLKn)
DP_CK_P: C93.2, U2.11 (IN_CLKp)
DP_D0_N: C92.2, U2.9 (IN_D0n)
DP_D0_P: C91.2, U2.8 (IN_D0p)
DP_D1_N: C90.2, U2.6 (IN_D1n)
DP_D1_P: C89.2, U2.5 (IN_D1p)
DP_D2_N: C88.2, U2.3 (IN_D2n)
DP_D2_P: C87.2, U2.2 (IN_D2p)
DP_HPD: J21.49, U2.4 (HPD_SRC)
DP_I2C_EN: R94.2, U2.10 (I2C_EN/PIN)
DP_OE: C95.1, J21.62, U2.42 (OE)
DP_SCL: J21.47, R96.2, R103.1, U2.15 (SCL_CTL)
DP_SCL_J: J17.5, R103.2
DP_SDA: J21.43, R97.2, R104.1, U2.16 (SDA_CTL)
DP_SDA_J: J17.6, R104.2
DP_VSADJ: R98.1, U2.22 (VSADJ)
ELPF: C37.1, R14.1, U1.30 (ELPF)
ELPF_RC: C36.1, R14.2
ESP_CS: J22.2, R68.1, U22.18 (B4)
ESP_IRQ: J22.4, R70.1, U23.12 (1B2)
ESP_MISO: J22.14, R72.1, U23.10 (2B2)
ESP_MOSI: J22.16, U22.15 (B7)
ESP_RX: J22.10, R71.1, U23.11 (2B1)
ESP_SCK: J22.12, U22.16 (B6)
ESP_TX: J22.6, U22.17 (B5)
FB_1V1: C86.2, R90.2, R91.1, U7.5 (FB)
FB_1V8A: C11.2, R7.2, R8.1, U6.7 (FB)
FB_3V3: C8.2, R5.2, R6.1, U5.7 (FB)
FB_3V6: C5.2, R3.2, R4.1, U4.5 (FB)
FMT: R43.1, U3.12 (FMT)
FPGA_DONE: J20.77, Q3.1 (G), R74.2
FPGA_READY: J20.79, Q4.1 (G), R76.2
GND: C1.2, C2.2, C3.2, C4.2, C6.2, C7.2, C9.2, C10.2, C12.2, C13.2, C14.2, C15.2, C16.2, C22.2, C23.2, C24.2, C25.2, C32.2, C33.2, C34.2, C35.2, C41.2, C42.2, C43.2, C44.2, C45.2, C46.2, C47.2, C48.2, C49.2, C50.2, C51.2, C52.2, C53.2, C54.2, C55.2, C56.2, C57.2, C58.2, C59.2, C60.2, C61.2, C63.2, C65.2, C67.2, C68.2, C69.2, C70.2, C71.2, C72.2, C73.2, C74.2, C75.2, C76.2, C77.2, C78.2, C79.2, C80.2, C81.2, C84.2, C85.2, C95.2, C96.2, C97.2, C98.2, C99.2, C100.2, C101.2, C102.2, C103.2, C104.2, C105.2, C106.2, C107.2, C108.2, C109.2, C110.2, C111.2, D2.2 (K), D6.2 (A), D8.2 (GND), D9.2 (GND), D10.2 (GND), D11.2 (GND), D12.2 (GND), D13.2 (GND), J1.1, J2.1, J3.1, J4.1, J5.1, J6.2 (TMDSData2Shield), J6.5 (TMDSData1Shield), J6.8 (TMDSData0Shield), J6.11 (TMDSClockShield), J6.17 (DDC/CECGround), J6.20, J6.21, J6.22, J6.23, J7.2, J8.5, J8.6, J8.7, J8.8, J8.10, J11.2, J13.2, J13.4, J15.1 (EH), J15.2 (EH), J15.3 (EH), J15.4 (EH), J15.A1B12 (GND), J15.B1A12 (GND), J16.2, J17.2, J17.15, J17.16, J20.1, J20.2, J20.8, J20.11, J20.16, J20.17, J20.21, J20.22, J20.27, J20.35, J20.38, J20.60, J20.63, J20.66, J21.2, J21.3, J21.8, J21.9, J21.14, J21.15, J21.20, J21.21, J21.26, J21.27, J21.32, J21.33, J21.38, J21.39, J21.45, J21.46, J21.51, J21.57, J21.63, J21.69, J21.70, J21.75, J21.76, J21.81, J21.82, J21.87, J21.88, J21.93, J21.94, J21.99, J21.100, J22.47, J22.53, J22.59, J22.65, J22.77, J22.79, J22.81, J22.83, J22.85, J22.87, J22.100, Q3.2 (S), Q4.2 (S), R1.2, R2.2, R4.2, R6.2, R8.2, R9.2, R10.2, R11.2, R12.2, R25.2, R29.2, R30.2, R31.2, R32.2, R33.2, R34.2, R41.2, R42.2, R43.2, R45.2, R47.2, R48.2, R51.2, R53.2, R59.2, R64.2, R66.2, R83.2, R91.2, R95.2, R98.2, R114.2, R115.2, SO1.1, SO2.1, SO3.1, SO4.1, SW1.4 (D), SW2.4 (D), SW3.4 (D), TP9.1, TP10.1, U1.3 (GND), U1.10 (GND), U1.24 (GND), U1.57 (GND), U1.65 (EP), U2.7 (GND), U2.19 (GND), U2.30 (GND), U2.41 (GND), U2.49 (EP), U3.2 (AGND), U3.5 (DGND), U4.2 (GND), U5.1 (NC), U5.4 (NC), U5.5 (NC), U5.8 (GND), U5.9 (EP), U6.1 (NC), U6.4 (NC), U6.5 (NC), U6.8 (GND), U6.9 (EP), U7.2 (GND), U8.3 (GND), U8.8 (GND), U9.3 (GND), U9.8 (GND), U10.3 (GND), U10.8 (GND), U12.2 (GND), U13.3 (GND), U14.3 (GND), U15.3 (GND), U17.8 (GND), U18.2 (VSS), U19.3 (GND), U19.8 (GND), U20.3 (GND), U20.8 (GND), U21.2 (GND), U22.10 (A8), U22.11 (GND), U22.12 (GND), U22.13 (GND), U22.22 (~OE), U23.2 (1DIR), U23.3 (2DIR), U23.8 (GND), U23.9 (GND), U23.14 (2#OE), U23.15 (1#OE), U24.2 (VSS), Y2.2 (GND), Y2.4 (GND)
HDMI_5V: C75.1, F3.2, J6.18 (+5VPower), R81.1, R82.1
HDMI_CEC: D7.1 (K), J6.13 (CEC), Q5.3 (D), U8.5 (D2-), U8.6 (NC)
HDMI_HPD: J6.19 (HotPlugDetect), R83.1, U2.33 (HPD_SNK), U8.4 (D2+), U8.7 (NC)
HDMI_SCL: J6.15 (SCL), R81.2, U2.38 (SCL_SNK), U8.1 (D1+), U8.10 (NC)
HDMI_SDA: J6.16 (SDA), R82.2, U2.39 (SDA_SNK), U8.2 (D1-), U8.9 (NC)
IN_BCK: J21.67, U3.8 (BCK)
IN_C0: J22.86, R19.2
IN_C1: J22.84, R18.2
IN_C2: J22.82, RN3.6
IN_C3: J22.63, RN3.7
IN_C4: J22.80, RN3.8
IN_C5: J22.78, R17.2
IN_C6: J22.61, R16.2
IN_C7: J22.76, R15.2
IN_DE: J22.56, R22.2
IN_DOUT: J21.65, U3.9 (DOUT)
IN_HS: J22.62, R20.2
IN_INT: J22.60, R26.2, U1.1 (#INT)
IN_KEY1: J20.75, R78.2, SW1.1 (A)
IN_KEY2: J20.73, R79.2, SW2.1 (A)
IN_LED: J20.71, R80.1
IN_LLC: J22.88, RN3.5
IN_LRCK: J21.66, U3.7 (LRCK)
IN_RESET_N: J22.90, R25.1, U1.51 (#RESET)
IN_SCKI: J21.68, U3.6 (SCKI)
IN_SCL: J22.44, R23.2, R101.1, U1.54 (SCLK)
IN_SCL_J: J17.3, R101.2
IN_SDA: J22.42, R24.2, R102.1, U1.53 (SDATA)
IN_SDA_J: J17.4, R102.2
IN_VS: J22.58, R21.2
IN_Y0: J22.74, RN2.5
IN_Y1: J22.68, RN2.6
IN_Y2: J22.66, RN2.7
IN_Y3: J22.64, RN2.8
IN_Y4: J22.54, RN1.5
IN_Y5: J22.52, RN1.6
IN_Y6: J22.48, RN1.7
IN_Y7: J22.46, RN1.8
JTAG_TCK: J16.3, J20.7, R66.1, U22.20 (B2)
JTAG_TDI: J16.5, J20.9, R67.1, U22.19 (B3)
JTAG_TDO: J16.4, J20.5, R69.1, U23.13 (1B1)
JTAG_TMS: J16.6, J20.3, R65.1, U22.21 (B1)
LED_A: D2.1 (A), R80.2
MD0: R41.1, U3.10 (MD0)
MD1: R42.1, U3.11 (MD1)
MODE0: J22.73, R113.2
MODE1: J22.71, R114.1
MODE2: J22.69, R115.1
PD_FB: R29.1, U1.32 (FB)
PLL_CLK0: R88.1, U17.10 (CLK0)
PLL_CLK0_S: C82.1, R88.2
PLL_CLK1: R89.1, U17.9 (CLK1)
PLL_CLK1_S: C83.1, R89.2
PLL_CLK2: J21.31, R87.2
PLL_CLK2_S: R87.1, U17.6 (CLK2)
PLL_SCL: J21.64, R85.2, R105.1, U17.4 (SCL)
PLL_SCL_J: J17.7, R105.2
PLL_SDA: J21.55, R86.2, R106.1, U17.5 (SDA)
PLL_SDA_J: J17.8, R106.2
PLL_XA: U17.2 (XA), Y2.1
PLL_XB: U17.3 (XB), Y2.3
PWRDWN: R28.2, U1.29 (#PWRDWN)
RCA_L: J4.2, R44.1
RCA_PB: C18.1, D9.1 (I/O), J2.2, R10.1
RCA_PR: C19.1, D10.1 (I/O), J3.2, R11.1
RCA_R: J5.2, R46.1
RCA_SYNC: C21.1, D11.1 (I/O), J7.1, R12.1
RCA_Y: C17.1, C20.1, D8.1 (I/O), J1.2, R9.1
RECONFIG_N: J20.61, R73.2, SW3.1 (A)
REFOUT: C32.1, C33.1, U1.42 (REFOUT)
SER_CK_N: C94.1, J21.77
SER_CK_P: C93.1, J21.79
SER_D0_N: C92.1, J21.83
SER_D0_P: C91.1, J21.85
SER_D1_N: C90.1, J21.89
SER_D1_P: C89.1, J21.91
SER_D2_N: C88.1, J21.95
SER_D2_P: C87.1, J21.97
SER_REFCLK_N: C83.2, J21.96
SER_REFCLK_P: C82.2, J21.98
SPDIF_5V: C65.1, F2.2, J13.5
SPDIF_AC: C66.2, R49.2, U13.2 (A)
SPDIF_AMP: R49.1, U13.4 (Y), U14.2 (A)
SPDIF_COAX: C66.1, D12.1 (I/O), J13.1, R48.1
SPDIF_OPT: D13.1 (I/O), J13.3, R51.1, U15.2 (A)
SPDIF_ORX: J21.59, R52.2
SPDIF_OSQ: R52.1, U15.4 (Y)
SPDIF_RX: J21.61, R50.2
SPDIF_SQ: R50.1, U14.4 (Y)
SW_1V1: L2.1, U7.3 (SW)
SW_3V6: L1.1, U4.3 (SW)
SYNC_G: C21.2, U1.33 (SOG)
SYNC_Y: C20.2, U1.50 (SOY)
TMDS_CK_N: J6.12 (TMDSClock-), U2.25 (OUT_CLKn), U10.5 (D2-), U10.6 (NC)
TMDS_CK_P: J6.10 (TMDSClock+), U2.26 (OUT_CLKp), U10.4 (D2+), U10.7 (NC)
TMDS_D0_N: J6.9 (TMDSData0-), U2.28 (OUT_D0n), U10.2 (D1-), U10.9 (NC)
TMDS_D0_P: J6.7 (TMDSData0+), U2.29 (OUT_D0p), U10.1 (D1+), U10.10 (NC)
TMDS_D1_N: J6.6 (TMDSData1-), U2.31 (OUT_D1n), U9.5 (D2-), U9.6 (NC)
TMDS_D1_P: J6.4 (TMDSData1+), U2.32 (OUT_D1p), U9.4 (D2+), U9.7 (NC)
TMDS_D2_N: J6.3 (TMDSData2-), U2.34 (OUT_D2n), U9.2 (D1-), U9.9 (NC)
TMDS_D2_P: J6.1 (TMDSData2+), U2.35 (OUT_D2p), U9.1 (D1+), U9.10 (NC)
VBUS_IN: D6.1 (K), F1.1, J15.A4B9 (VBUS), J15.B4A9 (VBUS)
VGA_5V: J8.9, R38.1, R40.1
VGA_B: C40.1, J8.3, R32.1, U19.5 (D2-), U19.6 (NC)
VGA_G: C39.1, J8.2, R31.1, U19.2 (D1-), U19.9 (NC)
VGA_HS: J8.13, R33.1, U20.1 (D1+), U20.10 (NC), U21.1 (1A)
VGA_HSB: R35.1, U21.6 (1Y)
VGA_HSIN: R35.2, U1.56 (HS_IN/CS_IN)
VGA_R: C38.1, J8.1, R30.1, U19.4 (D2+), U19.7 (NC)
VGA_SCL: J8.15, Q2.3 (D), R40.2, U20.5 (D2-), U20.6 (NC)
VGA_SCL_F: J22.38, Q2.2 (S), R39.2
VGA_SDA: J8.12, Q1.3 (D), R38.2, U20.4 (D2+), U20.7 (NC)
VGA_SDA_F: J22.40, Q1.2 (S), R37.2
VGA_VS: J8.14, R34.1, U20.2 (D1-), U20.9 (NC), U21.3 (2A)
VGA_VSB: R36.1, U21.4 (2Y)
VGA_VSIN: R36.2, U1.55 (VS_IN)
VREF: C55.1, C56.1, U3.1 (VREF)
XIAO_3V3: C71.1, C73.1, J11.3, R53.1, R58.2, R60.2, R61.2, R62.2, R63.2, U22.1 (VCCA), U22.2 (DIR), U23.1 (VCCA)
XIAO_5V: C70.1, D3.1 (K), J11.1
XIAO_D0: J12.1, R58.1, U22.3 (A1)
XIAO_D1: J12.2, R59.1, U22.4 (A2)
XIAO_D2: J12.3, R60.1, U22.5 (A3)
XIAO_D3: J12.4, R54.2
XIAO_D3_A: R54.1, U23.4 (1A1)
XIAO_D4: J12.5, R61.1, U22.6 (A4)
XIAO_D5: J12.6, R55.2
XIAO_D5_A: R55.1, U23.5 (1A2)
XIAO_D6: J12.7, R62.1, U22.7 (A5)
XIAO_D7: J11.7, R56.2
XIAO_D7_A: R56.1, U23.6 (2A1)
XIAO_D8: J11.6, R63.1, U22.8 (A6)
XIAO_D9: J11.5, R57.2
XIAO_D9_A: R57.1, U23.7 (2A2)
XIAO_D10: J11.4, R64.1, U22.9 (A7)
XTAL: C22.1, R13.1, U1.22 (XTAL), Y1.1 (OSC1)
XTAL1: C23.1, R13.2, U1.21 (XTAL1), Y1.2 (OSC2)

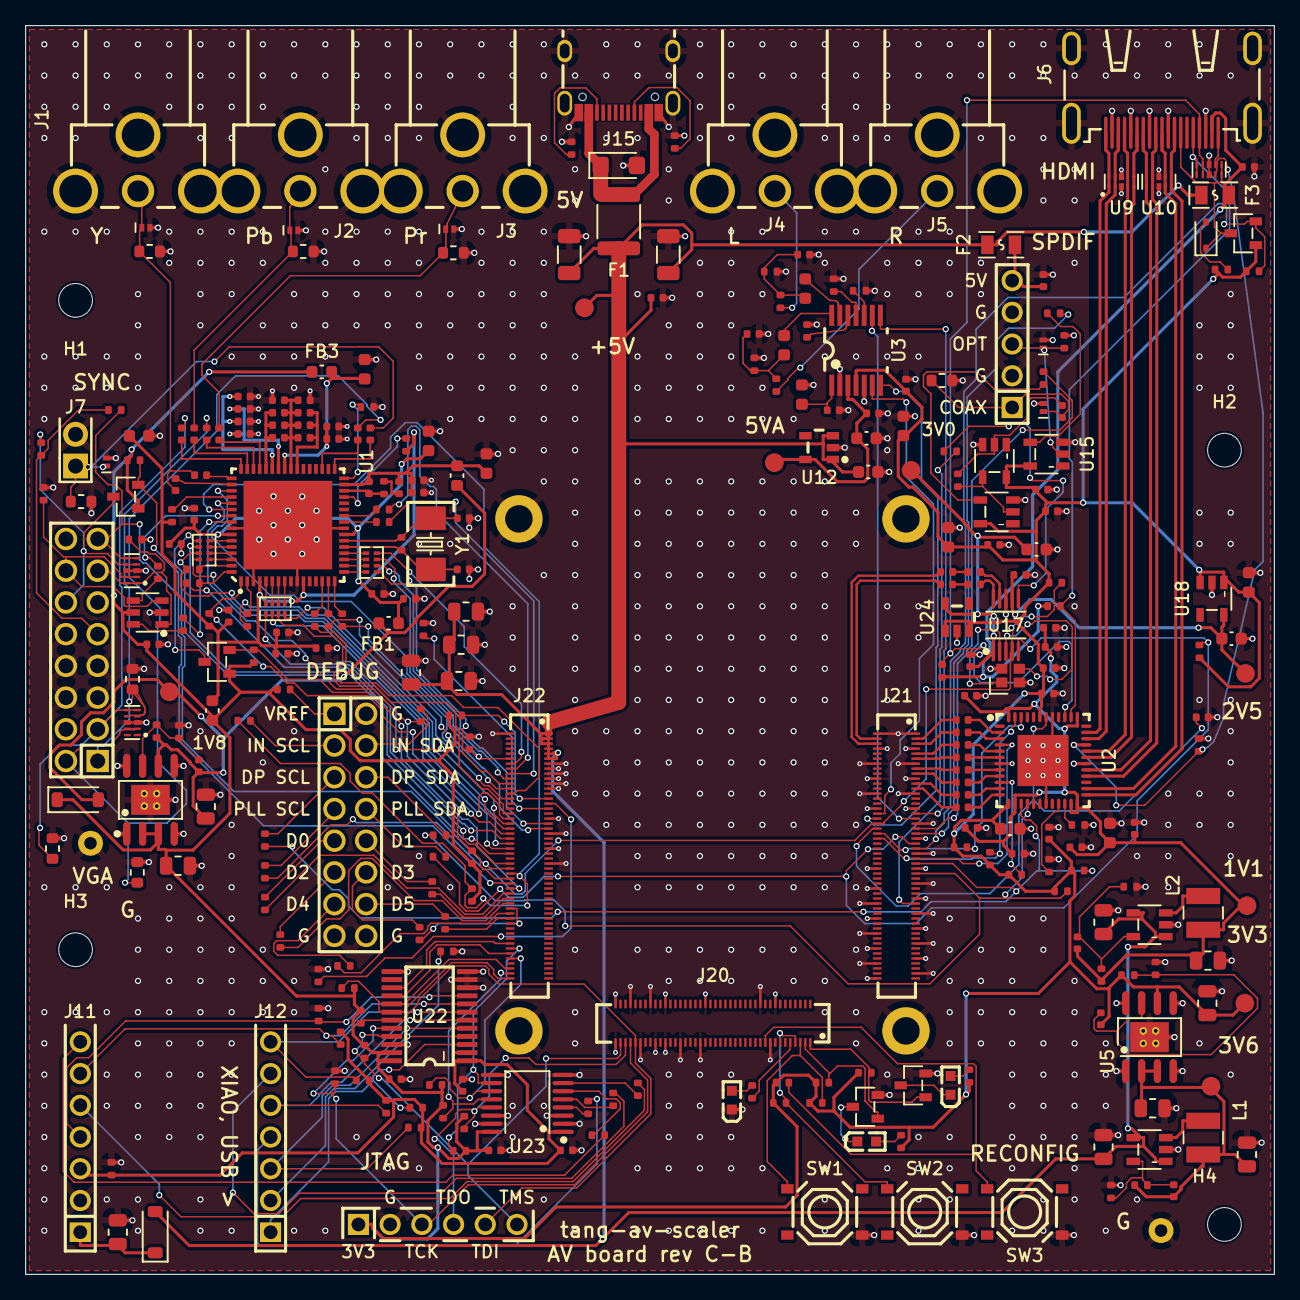
[picture p32: board av-board-cb.kicad_pcb from above]

Board: 4 copper layers, 100.0 x 100.0 mm, 318 parts (0 on the bottom side), 240 nets.

Other parts of the board:
H1, H2, H3, H4: MountingHole_2.7mm_M2.5
