bryfur/tang-av-scaler/gateware/rtl/hdmi_scr.v

// hdmi_scr.v: one TMDS channel's characters made ready for the encoder (tmds.v), N a clock: HDMI's
// framing and, above 340 MHz, HDMI 2.0's scrambling.
//
//   frame     the video guard band sent (the bytes below as data); else DVI: control to the pixel
//   scramble  characters scrambled: HDMI 2.0 6.1.2, here as its inventors' and implementers' patents
//             give it (the specification itself is for adopters):
//
// - An LFSR a channel, G(x) = 1 + x^11 + x^12 + x^13 + x^16, seeds 0xFFFF, 0xFFFE, 0xFFFD for channels
//   0, 1, 2, stepped eight places a character: a 16-bit register shifted up, 0x3801 XORed in when a
//   one falls out [US 11,962,847: the polynomial, the seeds, and its FIG. 2's first 21 values of
//   each channel, which this form gives: sim/scr_tb.py].
// - Once a frame eight characters of ordinary control tokens on all three channels (ucc), after
//   which the LFSRs start again: the first character after them takes the seed [US 11,962,847].
// - Picture bytes and guard band bytes XOR eight bits of the LFSR, then the ordinary encoder
//   [US 9,262,988; US 2014/0340579].  The video guard band as bytes: 0xAB on channels 0 and 2, 0x55
//   on 1 (what HDMI 1.4's guard band characters are of the encoder from a count of zero).
// - Any other control character: its two control bits and the channel's number (00, 01, 10) make
//   four bits, XORed with four of the LFSR's (its bits 11 to 14); with a bit that alternates from one
//   control character to the next (IToggle, the low bit; here 0 after the unscrambled characters)
//   they pick one of 32 ten-bit codes
//   [US 9,262,988 FIG. 4, FIG. 5; US 11,165,539: the alternation, the codes' counts of ones and
//   transitions, which the table below has].
//
// What those texts do not give, chosen here by opt and tried against a sink:
//   opt[1:0]  the LFSR's bits for a byte's bits 7:0: 0 its bits 7:0, 1 its bits 15:8, 2 bits 0:7,
//             3 bits 8:15
//   opt[2]    the control bits' four of the LFSR: 0 vector bit i with LFSR bit 14 - i, 1 with 11 + i
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
