bryfur/tang-av-scaler/(commit log)

2026-10-24 tang-av-scaler: the project, its plan, the repository
    A PS2-class console's component video on a Tang Console 138K: deinterlaced, SMAA,
    scaled, out as 1080p60 HDMI with its audio, through an AV board on the Console's
    two 2x20 headers (ADV7842 + PCM1808 in, ADV7511 out). The vendors' documents
    stay out of git.
2026-10-24 av-board: the host headers' map and the reference documents
    J9/J10 on the Tang Console 138K (32001C): 38 I/O each (bank 2 / bank 4),
    +5 V and one GND, no 3.3 V; their clock-capable balls. The documents every
    circuit follows (ADV7842 data sheet + UG-214, ADV7511 hardware guide Rev D,
    PCM1808 data sheet, Sipeed's schematic and iBOM), where each came from;
    the files themselves stay out of git.
2026-10-24 av-board: ADI's HDMI RX power supply recommendations (Rev A) in the references
    The ADV7842's supplies follow its Fig. 2: LDOs, a ferrite per rail, the
    decoupling per pin and the 3.3 V-before-1.8 V sequence.
2026-10-24 av-board: ADI's ADV7844 recommended register scripts (v5.8c) in the references
    The component (CP YPbPr SD/ED/HD) sequences, receiver and ADV7511 together:
    the bring-up reference until the ADV7842's own file is in.
2026-10-24 av-board: notes from the ADV7844 evaluation board and UG-214
    The ADV7844 EBZ schematic, BOM and netlist (Rev C) are the circuit
    reference for the ADV7842 side: input termination, crystal, REFP/REFN,
    pixel-port series resistors, reset, supplies and per-rail decoupling.
2026-10-24 av-board: electrical design
    ADV7842 (component in, 16-bit 4:2:2 out on P[23:16]/P[11:4]), PCM1808,
    ADV7511 (16-bit 4:2:2 in, ID 1 style 1 right-justified), power tree,
    header pin plan, every connection traced to UG-214, the ADV7842 and
    ADV7844 evaluation schematics, the ADV7511 guide or TI data sheets;
    deviations listed.
2026-10-24 av-board: board.py, the parts and nets in one place
    217 parts, 164 nets, every value with its LCSC number and its source.
    Checks: no single-pin nets, every ADV7842 ball connected or one UG-214
    Appendix C says to float, every ADV7511 pin connected. LCSC symbols and
    footprints (easyeda2kicad, upgraded to KiCad 9) in lib/; the ADV7842
    symbol checked against UG-214 Table 1, the ADV7511 one against the HWG
    pinout.
2026-10-24 av-board: generated schematic, ERC clean, netlist checked
    gen_sch.py writes av-board.kicad_sch from board.py (each unit placed by
    block, every pin a wire and a net label or a no-connect). ERC: no
    violations. check_netlist.py compares KiCad's netlist with board.py:
    881 pins, no mismatches. fix_lib.py makes the LCSC symbols' pins passive
    (their EasyEDA types are arbitrary).
    [av-board.kicad_sch]
2026-10-24 av-board: mechanics (window over the SOM, wings past the Console, standoffs)
    SOM position from its drawing and the Console's H1-H4; header pin
    coordinates from the ibom; what the board covers on the Console and how.
2026-10-24 av-board: PCB generator, placement and BGA fanout
    gen_pcb.py builds av-board.kicad_pcb from board.py: outline (130 x 69.4
    mm, window over the SOM with notches to the Console buttons S1/S2, M2.5
    standoff holes on the Console's H7 holes), sockets renumbered by the
    Console pin under each hole, hand-placed ICs/connectors/rail filters,
    a nearest-free-spot placer for the small parts (ADV7842 decoupling in
    a ring under it), net classes, ADV7842 dogbone fanout (124 vias, each
    rail's inside its own In2 plane), In1 ground, In2 rail planes. TMDS
    ESD now two TPD4E05U06 (0.5 pF, flow-through). DRC: no shorts or
    clearance errors; routing is next.
    [av-board.kicad_pcb]
2026-10-24 av-board: fab script (Gerbers, drill, JLCPCB BOM/CPL), build steps in the README
2026-10-24 av-board: 6 layers, placement for straight video buses, Freerouting 1.9.0
    - 6-layer stack (signal/GND/signal/rail planes+signal/GND/signal): on 4
    layers Freerouting left ~100 connections around the BGA and diverged.
    - ADV7842 at J10's height, its 75 R arrays in a column beside the pixel
    balls (regrouped by ball row), so the input bus runs straight into J10;
    ADV7511 level with J9. Rail planes exit away from the bus; filters
    fitted so their output pad lands in their plane.
    - Standoffs on two diagonal Console holes; the other two blocked the
    buses. Console S1/S2 covered: two buttons of our own on J10 31/32.
    - Vias for every ground/rail pad before routing; edge/window keepouts;
    power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
    [av-board.kicad_sch]
2026-10-24 av-board: routing fixes (locked/restored fanout, plane keepouts, PVDD plane, corridors)
    - Fanout copper locked and put back after the session import (KiCad
    replaces all copper with Freerouting's result).
    - In3 rail planes: no signal tracks across them (In3-only keepouts); inner
    plane clearance 0.127 mm, so the planes survive the BGA's via field.
    - PVDD gets its own small plane and its filter beside it.
    - SDRAM DQ pull-downs as single 0402s beside their balls (UG-214 App. C).
    - Bus corridors kept free of small parts; stitching vias; two-stage route.
    [av-board.kicad_sch]
2026-10-24 av-board: no window: the board is the Console's outline, over the SOM
    Nothing is mounted on the SOM (about 7 mm tall, the AV board's underside
    at 11 mm), so the window and the wings go: 79.6 x 69.4 mm. The ADV7842
    sits right above J10's data end (pixel side down, 75 R arrays in a row,
    ~6 mm of bus), the ADV7511 right under J9's (data side up, ~9 mm),
    HDMI on the right edge, jacks on the left. Rail planes re-planned for
    this orientation (VDD/DVDDIO right, AVDD/PVDD up; VDD_SDRAM and CVDD
    balls joined on F.Cu). Standoffs on the right-hand Console holes.
2026-10-24 av-board: drop the window-era workarounds
    Back to Freerouting 2.5 (headless; no 1.9.0/Xvfb, no second stage), 4
    layers by default (LAYERS=6 still available), no reserved bus
    corridors, SDRAM DQ pull-downs as 4.7 k arrays again. Kept: the
    no-window placement, plane design and fanout, locked/restored fanout,
    plane keepouts, rules, placer anchoring.
    [av-board.kicad_sch]
2026-10-24 av-board: 15 mm wider on the left for the RCA jacks
    94.6 x 69.4 mm: the jacks overhang the Console's left edge, giving the
    analog front end, crystal and PCM1808 room beside the ADV7842; all four
    Console standoff holes are usable again.
2026-10-24 av-board: DeepPCB client, TMDS nets as _P/_N pairs, Freerouting selectable
    - deeppcb.py: route a DSN on DeepPCB through its public API (key from
    ~/.config/deeppcb/key, never the repo): upload, resubmit as DeepPCB
    JSON with the board-edge clearance and the TMDS differential pairs
    (a DSN carries neither), route keeping our wiring, poll, fetch the
    session. gen_pcb.py imports any session with SES=file.
    - TMDS nets renamed TMDS_X_P/_N so KiCad and DeepPCB see pairs; TMDS
    class pair geometry 0.25/0.2 mm (~97 R, to check with JLCPCB).
    - Rail planes reach their caps and filters; FREEROUTING selects the
    Freerouting version (1.9.0 by default, via a private Xvfb).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
    [av-board.kicad_sch]
2026-10-24 av-board: rail caps over their planes; DeepPCB as a router in gen_pcb.py
    - Decoupling for a rail with a plane goes where its footprint lies over
    the plane (a via straight down connects it); TVDD plane widened.
    - route(): clear all copper before importing a session, put back the
    locked fanout it lacks (DeepPCB sessions carry it, Freerouting's
    drop some); ROUTER=deeppcb runs deeppcb.py.
    - First DeepPCB run (25 min, untuned, earlier placement): 0 clearance
    errors, 0 shorts, 26 unconnected.
    [gen_pcb.py]
2026-10-24 av-board: deeppcb.py applies DeepPCB's own recommendations
    Boundary clearance 0.25 mm, the four TMDS differential pairs, and
    DeepPCB's fanout of U1 (DEEPPCB_FANOUT) before routing: the steps its
    assistant lists for this board.
    [deeppcb.py]
2026-10-24 av-board: centre the RCA jack column (1.9 mm from the outer lugs to the edges)
    The top jack's shell lug pad came within 0.4 mm of the board edge.
2026-10-24 av-board: route(): take the track list before the DSN export
    After ExportSpecctraDSN the board's track list cannot be iterated from
    Python; clearing the copper before a session import used it.
2026-10-24 av-board: restored fanout matched by distance (no duplicate vias after import)
    Routers return our protected vias rounded by a few tenths of a micron;
    only fanout with nothing within 20 um is put back.
2026-10-24 av-board: prune dangling vias/stubs after routing; keepouts at the standoffs
    route() ends with prune(): KiCad's DRC lists the dangling vias and
    track ends (fanout the router did not use), they are removed by UUID,
    zones refilled, repeated. Standoff holes get 6 mm track/via keepouts.
2026-10-24 Placement: parts by the pins they serve, both header buses flat
    The router was failing on placement, not on routing time:
    - Small parts were anchored on the first earlier IC sharing any net. Pull-ups to 3V3 went to
    the 3V3 regulator (R20-R25 near J9, 35-45 mm from their ADV7842 balls), and the 51 R
    video terminations (on TERM_x only, no IC pad) fell back to the middle of the bottom edge.
    Now a part on a signal goes to the IC pin it serves, else beside the part it hangs on, else
    the connector pin; supply nets do not count. The terminations sit at the ADV7842 (UG-214
    App. A), the ADV7511 audio series resistors at the source, J9 (HWG 7.3). Parts wait until
    what they hang on is plac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
    [av-board.kicad_pcb, av-board.kicad_sch]
2026-10-24 Rail planes sized for their caps: 68 of 69 ADV7842 rail caps over their plane
    40 of the ADV7842 rail caps sat off their planes (median 7 mm, up to 12 mm from their rail),
    among them 10 per-ball 10/100 nF caps and AVDD/PVDD caps: noise on the ADC and PLL supplies,
    and one more routed connection each into the crowd round the BGA.
    - The planes widen past the BGA to hold their filter and every cap: AVDD over the top right,
    PVDD over the top left (taking room TVDD did not use), VDD and DVDDIO to the right with
    DVDDIO (25 caps per UG-214 Fig. 179) taking the larger lower part, up to the regulators.
    - CVDD's filter and tantalum move from the right of the BGA, where they took VDD/DVDDIO room,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
    [av-board.kicad_pcb, av-board.kicad_sch]
2026-10-24 Review against the data sheets: LDO feed-forward and EN, HPD, anti-alias, clock clearance
    Every IC checked pin by pin against its document (design.md "Review against the data sheets"):
    the ADV7842 against every row of UG-214 App. C and the AIN_SEL routing, the ADV7511 against
    HWG Rev D, the PCM1808, TPS7A7001, TLV62569 and TPD4E05U06 against their data sheets. Fixed:
    - TPS7A7001: a 220 pF feed-forward across R1 on all three; the data sheet requires it with
    47-200 uF on the output (3V3 and both 1.8 V rails carry more than 47 uF through the filters).
    U6/U7 output 22 uF -> 10 uF, keeping 1V8A (about 185 uF) under the 200 uF limit.
    - TPS7A7001 EN: the 1.8 V LDOs' enable RC now pulls up to 2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
    [av-board.kicad_pcb, av-board.kicad_sch]
2026-10-24 Routing room round the BGA, 6-layer stack, finishing pass after an outside router
    What DeepPCB left open on four layers (14 of 743, no clearance errors or shorts) was nearly all
    escapes from under the ADV7842: the SDRAM pull-down corner, two pixel lines, SYNC_Y and the two
    RXA/RXB_5V balls. So:
    - A 1 mm ring round the ADV7842 is kept free of small parts on both sides (its outer two rings
    escape through it), and the J10 bus's fan-out under the 75 R arrays is reserved for routing.
    - RXA/RXB_5V take escape vias like the other inner balls (they had F.Cu only).
    - Six layers: JLC06161H-7628B, whose outer prepreg (0.218 mm, er 4.4) keeps the TMDS geometry.
    - route(): a session from elsewhere (De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
    [av-board.kicad_pcb]
2026-10-24 Pull-down balls escape through vias; their arrays by the BGA's right side
    The SDRAM pull-downs failed in every run, on both routers: their balls are in the BGA's outer
    two rings at its top right corner, which had no escape via (outer-ring balls escape on F.Cu),
    and F.Cu there is full with the analog inputs' terminations and RCA lines. DeepPCB's own BGA
    fanout does not work round our fanout, and its router does not add vias inside the BGA.
    - A ball whose only connection is a pull-down (PD_*) takes an escape via in the outer rings too.
    - The SDRAM pull-down arrays are placed by the ADV7842's right side, level with their balls.
    - Router scratch files (DSN, sessions, log) are named after the bo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
    [gen_pcb.py]
2026-10-24 SDRAM pull-downs grouped by ball position, arrays along the BGA's right side; six layers default
    The pull-down arrays were grouped by DQ number, so each collected four lines from scattered
    balls across the BGA's top right corner (RN8: R16, R15, T15 and N14, four rows in), and lines
    for different arrays crossed in the tightest spot on the board. Any pin may take any of these
    identical 4.7 k pull-downs, so:
    - board.py orders the 18 balls along the chip's T-row edge (column, then row); each array serves
    four neighbouring balls, the two at the ends of the run take single resistors.
    - gen_pcb.py's array placer (was place_rn, for the 75 R arrays) takes any side: the pull-down
    arrays now stand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
    [av-board.kicad_pcb, av-board.kicad_sch]
2026-10-24 Single pull-down resistors, SYNC_Y escape via, rail caps by their rail pad
    From a round of free Freerouting trials (each variant routed on fpga, DRC'd, failures counted
    over several runs):
    - The unused SDRAM port's 18 pull-downs are single 0402s by the ADV7842's right side. With
    4-resistor arrays two to five of them failed in every run on both routers (four lines meeting a
    0.5 mm-pitch array in order, in the board's tightest corner); with singles, rarely one.
    - SYNC_Y (J15) takes an escape via like the pull-down balls: it failed in nearly every run on
    F.Cu under the analog inputs' terminations, and not once with the via.
    - A rail cap is placed where its rail pad (0.3 mm in) is over it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
    [av-board.kicad_pcb, av-board.kicad_sch]
2026-10-25 The AV board routed: six layers, DRC clean
    av-board.kicad_pcb is now routed: Freerouting 1.9 (60 passes) on the six-layer placement, then
    mazeroute.py for the two connections it left (C20's AVDD pad round C54, and the Y5 pixel line
    from U1 L2 to RN5). DRC: no unconnected items, no clearance or short violations, nothing
    dangling; only silkscreen warnings and the two sockets' renumbered pads.
    mazeroute.py is a small grid router (A*) for what an autorouter leaves: one net between two
    pads on F.Cu/In2.Cu/B.Cu, round everything on the board with our clearances, a new via where
    one fits on all layers with drill spacing; obstacles dumped by KiCad's python, the search in
    numpy (eda-venv), the resul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
    [av-board.kicad_pcb]
2026-10-25 TMDS refined on DeepPCB: pairs coupled, DRC clean
    The routed board, refined: DeepPCB rerouted with only the locked fanout protected (any routed
    track free to move), the rail planes kept clear of other wires and the stitching vias left out,
    and routed D2 and D0 as pairs (81 % and 79 % coupled, 0.6 mm skew). mazeroute.py finished CK
    and D1 with the N line following the P line (52 %, 59 %). Before, Freerouting had the four pairs
    4-22 % coupled. Worst skew 3.7 mm (about 25 ps, HDMI allows about 100 ps). DRC: no errors.
    R_EXT still has nothing switching near it.
    - deeppcb.py: DEEPPCB_PROTECT_FILE (protect only the listed copper; DeepPCB otherwise protects
    all of it), DEEPPCB_PLANE_KEEPOUT (pla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
    [av-board.kicad_pcb]
2026-10-25 Ready to order: silkscreen, 0.2 mm TMDS on the outer layers, fab outputs
    - Silkscreen (gen_pcb.py silkscreen(), also on a routed board with --silk): designators only for
    ICs, connectors, filters, inductors, crystal, buttons and holes, each moved to the first spot
    clear of copper and other text (above, below, beside, on the body) or hidden; the passives' and
    every other field (values, LCSC numbers, which KiCad had put on the silkscreen) hidden. Labels
    Y/Pb/Pr/L/R by the jacks, HDMI, and the board's name. No text over copper; what DRC still lists
    is footprint outline graphics.
    - TMDS: CK and D1's mazeroute segments redone at the class's 0.2 mm on F/B only (they were
    0.127 mm, mostl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
    [av-board-bom.csv, av-board.kicad_pcb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]
2026-10-25 gen_fab.py: Gerbers, drills and CPL from one origin
    JLCPCB's placement preview had every part off the board: the CPL was measured from the board's
    lower-left corner, the Gerbers (--use-drill-file-origin with no drill/place origin set) and the
    drills (absolute) from KiCad's page origin. gen_fab.py now sets the drill/place origin at the
    board's lower-left corner on a copy of the board and plots the Gerbers (--use-drill-file-origin)
    and drills (--drill-origin plot) from that copy, the CPL from the same corner.
2026-10-25 AV board: revisions in rev-a/, shared generators in kit/
    The board moves to hardware/av-board/rev-a/ (av-board-a.*): its board.py and gen_pcb.py keep
    only what is rev A's own. What a next revision reuses goes to kit/: parts.py (the part
    record, two-pin parts and LCSC numbers, the Console headers), pcbkit.py (the placer, fanout,
    rules, planes, routing passes and silkscreen, as a Layout class a revision subclasses with
    hooks for its chips), and the tools, which now take the revision (kit/gen_sch.py rev-a).
    Rev A regenerates exactly as before: the same parts and nets, placement, fanout copper,
    zones and silkscreen, and the same Gerbers, drills, BOM and CPL (only the file names carry
    the revisi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
    [av-board-a-bom.csv, av-board-a.kicad_pcb, av-board-a.kicad_sch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]
2026-10-25 Rev B: the ADV7181D (LFCSP-64) in place of the ADV7842, four layers
    rev-b/board.py: rev A with the decoder changed, from the ADV7181D data sheet Rev C (Fig. 8
    loop filter, Fig. 9 typical connection, Table 8 input mapping, Table 11 16-bit SDR output):
    75 R / 0.1 uF component inputs on AIN10/8/6, sync on Y, the ADC reference network, 33 R on
    every output, one ferrite + 10 uF per supply in place of the NFE61PT filters. J10 follows the
    new chip pin order, LLC still on the CLK pin. ERC clean, netlist = board.py.
    rev-b/gen_pcb.py: analog side towards the jacks, pixel side towards J10, the series resistors
    in rows along the chip, decoupling under its pins, exposed-pad vias and a paste grid.
    kit: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
    [av-board-b.kicad_sch]
2026-10-25 Rev B: escape vias at the ADV7181D, resistor rows that keep out of their way, cheaper parts
    gen_pcb.py: every supply pin and tied-off pin of the ADV7181D gets a via just past its
    neighbours tips before routing (in front of itself or of a GND/unused neighbour, chosen to
    leave the series resistors most room); the 33 R rows keep each resistor between the pins on
    either side of its own that have lines out, packing a closed run, spilling an open one towards
    the corner. Freerouting had boxed such pins in (11, then 3, then 4 connections left). The GND
    pin ties run straight in (one shorted a DVDDIO pin).
    board.py: yellow RCJ-014 jacks for the black RCJ-011 (same footprint, half the price, five
    time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
    [board.py, gen_pcb.py, mazeroute.py, parts.py]
2026-10-25 Rev B routed: DRC clean, fab files
    Freerouting connected every net on four layers over the locked fanout; the TMDS pairs were
    then laid again pair-wise on the outer layers with mazeroute.py (Freerouting had taken two
    through In2, which has no close ground on this stack), skew 1.2-5.1 mm. DRC: no errors, no
    unconnected items. fab/: Gerbers, BOM (46 lines), CPL (172 parts, 14 on the bottom). ERC
    clean, schematic = board.py.
    [av-board-b-bom.csv, av-board-b.kicad_pcb, av-board-b.kicad_sch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]
2026-10-25 Rev B: SMT on the top only, resistor arrays, a BOM without the RCA jacks
    Every SMT part is now on the top (only the through-hole J9/J10 sockets sit underneath), so
    JLCPCB assembles one side. To make room for the ADV7181D decoupling on the top, the three
    runs of four pixel pins get 4 x 0402 33 R arrays at the pins own 0.5 mm pitch, in line with
    them (163 parts, from 172); the band between the chip and its resistors is kept for the lines
    and each supply pin 100 nF is placed first (2.7-4.3 mm from its pin).
    gen_fab.py writes a BOM + CPL per assembly variant (VARIANTS in board.py); rev B hand-jacks
    leaves J1-J5 for soldering by hand. Same Gerbers.
    The routing flow does the hand steps now: a po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
    [av-board-b-bom.csv, av-board-b-hand-jacks-bom.csv, av-board-b.kicad_pcb, av-board-b.kicad_sch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]
2026-10-25 Rev B reviewed against every data sheet; supplies, stack-up and TMDS fixed
    review.md: each part against its document, for margin, not just limits. Fixed:
    - Supply sequencing: the ADV7181D allows 3.3 V at most 2 V above and 0.3 V below the 1.8 V
    rails [DS Table 5]; rev A RC enable put 3V3 30 ms ahead. Now buck -> 3V6 -> 3V3 LDO ->
    1.8 V LDOs fed and enabled by 3V3, plus a B5819W clamp 1V8A -> 3V3 for power-down. The 3V3
    LDO runs from 3.6 V (0.17 W, was 0.94 W).
    - Ferrites: the 0.2 A / 0.45 R beads dropped AVDD under 3.15 V at the LDO low limit;
    BLM18PG121SN1D (2 A, 50 mR), a basic part.
    - Crystal: YXC X50322863636MSB2GI (476 in stock, +-10 ppm) for the 68-in-stock TXM.
    - Stack-up: In2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
    [av-board-b-bom.csv, av-board-b-hand-jacks-bom.csv, av-board-b.kicad_pcb, av-board-b.kicad_sch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]
2026-10-26 AV boards: second full review, ESD at the connectors, rev C, rev B and C-B routed
    Rev C (the SOM on its own carrier, C-A with the ADV7511, C-B with the SN65DP159) joins rev B on
    shared code: kit/circuits.py (rev B's circuits), kit/adv7181d_layout.py, kit/tmds_layout.py,
    rev-c/ (carrier, floor plan, SOM pin matching, design notes, review).
    Review fixes (rev-b/review.md, rev-c/review.md):
    - ESD at each connector: a TPD1E05U06 per video and S/PDIF input (the shared four-line arrays
    sat 11-25 mm from some of their connectors); every ESD part placed first, at its connector;
    an array's ground through the package to one via away from the connector (TI's layout); the
    VGA array's channels in t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
    [av-board-b-bom.csv, av-board-b-hand-jacks-bom.csv, av-board-b.kicad_pcb, av-board-b.kicad_sch, av-board-ca.kicad_sch, av-board-cb-bom.csv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]
2026-10-26 Rev C-A routed: DRC clean, fab files, renders; prune in a process per round
    Rev C-A after the second review: routed with the analog lines kept 0.5 mm from digital ones,
    the last gaps closed by rip-up; no DRC errors, no unconnected items. TMDS from the ADV7511
    74.9-83.6 mm, no vias, 6 ps within a pair; its pixel clock 11.7 mm without a via. Fab files and
    renders made; rev-c/review.md has the numbers.
    pcbkit: prune() runs each round in a process of its own (gen_pcb.py --prune-round): after a zone
    fill, pcbnew hands back the next board it loads without its type, which crashed the finishing
    step after rip-up's many loads.
    [av-board-ca-bom.csv, av-board-ca-hand-jacks-bom.csv, av-board-ca.kicad_pcb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]
2026-10-27 AV boards: the last complete, valid design of each revision; decoupling at the pins
    Each revision's board, schematic, fab files and renders are its last complete
    route: DRC clean, no unconnected items, ERC clean, the board equal to its
    schematic part for part (pads, values, footprints; only the mounting holes
    H1-H4 have no symbol).
    - Rev A: the silkscreen pass (labels clear of pads, texts and part bodies);
    copper unchanged.
    - Rev B: the previous route with the silkscreen pass. Its schematic stays the
    one it was routed from: board.py now numbers eight capacitors the other way
    round, and its placement fixes (below) are not routed yet, the routes on the
    new placement having left 1 and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
    [av-board-a.kicad_pcb, av-board-b.kicad_pcb, av-board-ca-bom.csv, av-board-ca-hand-jacks-bom.csv, av-board-ca.kicad_pcb, av-board-ca.kicad_sch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]
2026-10-27 AV boards: rev B, C-B routed on the fixed placement; prune side-by-side copies; JLC jack rotation
    Every revision: schematic = board.py, the board = its schematic part for part,
    ERC and DRC clean, no unconnected items; rev B's, C-A's and C-B's review tables
    measured on these routes.
    - Rev B: routed on the capacitor placement fixes (try-b-r1, its last gap
    finished); schematic regenerated (eight capacitors renumbered).
    - C-B: the 1V1 buck's inductor and output capacitor placed before its feedback
    divider: in the 3V6 bucks' order the divider's 6.8 pF took the inductor's place
    beside SW, the inductor went above the chip with its SW pad turned away (10.7 mm
    of SW track, FB's copper 0.2 mm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
    [av-board-b-bom.csv, av-board-b-hand-jacks-bom.csv, av-board-b.kicad_pcb, av-board-b.kicad_sch, av-board-cb-bom.csv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]
2026-10-27 AV boards: silkscreen to JLCPCB's limits; the XIAO's way in printed on rev C
    JLCPCB's silkscreen limits (its capabilities page): lines and strokes 0.15 mm
    at least, text 1 mm high with a 1:6 stroke, 0.15 mm from pads.
    - kit/pcbkit.py: designators and pin labels 1 mm (were 0.8 and 0.9 mm), every
    text's stroke 1:6 of its height; designators clear of the other parts'
    bodies, tried at 40 places beside their part before its own body.
    silk_tidy(): the parts' own silkscreen widened to 0.15 mm and cut back where
    it came within 0.15 mm of a pad, past the board's edge, under a text or onto
    another part's (the bigger parts first); EasyEDA's 0.12 mm pin 1 dots (too
    small to print) taken out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
    [av-board-b.kicad_pcb, av-board-ca.kicad_pcb, av-board-cb.kicad_pcb]
2026-10-28 AV board C-B: a protected debug header and test pads; the kit on KiCad 10, a second host
    C-B (the SOM hides the FPGA's pins, so the board brings out what bring-up needs):
    - J17, a 2 x 8 header left of the SOM: the ADV7181D's, the DP159's and the MS5351M's I2C, six
    spare FPGA pins, J22's nearest (dbg0-dbg5: AB16 L13 M13 AA16 AB17 Y17, LVCMOS33 in
    fpga/av-board-cb.cst), a 3.3 V reference and ground, labelled pin by pin, "DEBUG" above it.
    Every pin but ground through 220 R by the header (C25091, as Digilent's Pmod ports): a slipped
    probe or a wrong wire drives at most 15 mA into a pin; VREF, beside ground, is a reference
    (50 mW in its resistor when shorted), not a supply.
    - A bare tes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
    [av-board-ca.kicad_sch, av-board-cb-bom.csv, av-board-cb-hand-jacks-bom.csv, av-board-cb.kicad_pcb, av-board-cb.kicad_sch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]
2026-10-28 AV board C-B: the HDMI lines to TI's layout rules; the reference clock laid as a pair
    C-B, after an audit against the published HDMI layout rules (TI's SN65DP159 data sheet,
    SPRAAR7 and HDMI Design Guide, Intel AN 837; the specification itself is for Adopters only):
    rev-c/review.md's new HDMI rows, kit/hdmi_audit.py.
    - The TMDS pairs 1.27 mm apart along their run (5 W at 0.25 mm lines, SPRAAR7 3.1), closing to
    the ESD arrays' 0.75 mm within the receptacle's break-out; they were 0.75 mm (3 W) all the way.
    - Rule areas beside and between the pairs on F.Cu keep out other tracks, vias and the ground
    pour: 3V3, 2V5, +5V and DP_OE vias had stood beside the outer lines, their In1 antipads
    0.0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
    [av-board-cb-bom.csv, av-board-cb-hand-jacks-bom.csv, av-board-cb.kicad_pcb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]
2026-10-28 AV boards: the TMDS keep-outs from the kit for every revision; rev B's 3V3 off TMDS_CK
    The keep-outs along the TMDS pairs (TI SPRAAR7 3.1-3.3: other lines 30 mil off, 1.5 W from plane
    voids; 3.14: the planes voided under 60 % of the ESD arrays' pads) were C-B's own; now
    kit/tmds_layout.py makes them for any revision on TMDSLayout:
    - tmds_keepouts(): rule areas on F.Cu outside the outermost line, inside the innermost and
    between the pairs, each following the lines round their corners, from the corner (or, with
    TMDS_KEEP_OUT, from past the chip's 0.25 in break-out along the first leg) to where the pairs
    close up before the arrays (unspread: TMDS_KEEP_END, 1 mm, before the arrays' pads, c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
    [av-board-b-bom.csv, av-board-b-hand-jacks-bom.csv, av-board-b.kicad_pcb, av-board-cb.kicad_pcb]
2026-10-28 AV board C-A: the TMDS pairs 5 W apart up their run, kept clear; re-routed
    C-A had C-B's old faults (kit/hdmi_audit.py rev-ca, TI SPRAAR7): the pairs 3 W apart for all of
    their 75-84 mm, a +5V via 0.18 mm from TMDS_D2_P (its antipad 0.03 mm from the line in In1), the
    HPD via 0.62 mm from TMDS_CK, the ground pour within 0.3 mm of every pair, nothing voided under
    the ESD arrays. Now (rev-ca/gen_pcb.py):
    - TMDS_SPREAD 0.52: the pairs 1.27 mm (5 W) apart up their 55 mm run, as C-B's.
    - TMDS_KEEP_OUT: the kit's keep-outs along the first leg too (15-17 mm from the ADV7511 to the
    corner), past the chip's break-out, round the corners and up the run; In1 and In2 voided
    under the arrays' TMDS pads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
    [av-board-ca-bom.csv, av-board-ca-hand-jacks-bom.csv, av-board-ca.kicad_pcb]
2026-11-12 Gateware: rev C-B's bring-up image: component in, 1080p60 HDMI out
    The first FPGA design for the AV board rev C-B (GW5AST-138 on its carrier), as far as bring-up
    has got: a PS2's 480i component picture out of the HDMI port as 1080p60, in colour.
    - A register monitor on the XIAO's UART (rtl/mon.v, top.v; tools/avb.py): every chip's I2C bus bit
    by bit, frequency meters, the transceivers' controls.
    - HDMI out of the transceiver quad (gtx_quad.v, generated; its register file made without the
    IDE: gowin/serdes.py, csr_result.py): pattern.v's test picture, tmds.v coding 1, 2 or 4
    characters a clock. 1080p60 and 2160p30 are clean on the sink's counters with the SN65DP159 as a
    redriver (as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
2026-11-12 Firmware: the XIAO as a USB-JTAG and UART bridge (ESP32-S3)
    For the XIAO socket of rev C-A/C-B: the ESP32-S3's own USB-Serial-JTAG unit bridged out to D0-D3
    (the FPGA's JTAG: openFPGALoader -c esp32s3), and its USB serial port to the FPGA's UART on
    D6/D7 at 1 Mbaud. flash.sh resets with the watchdog: after a hard reset the chip stayed in its
    ROM loader. The bridge is enabled after the USB driver is installed, or it does not take.
    [main.c]
2026-11-12 Firmware: the Wi-Fi debug link (XIAO ESP32-C5)
    The XIAO on the board's Wi-Fi: the FPGA's UART on TCP 2323, a status page, updates over the
    network, a Xilinx Virtual Cable server on the JTAG pads; with a USB cable in, the chip's own
    USB-JTAG bridge on those pads (how the FPGA is loaded now) and the UART on USB serial.
    On the board (ESP32-C5 in rev C-B): the PSRAM is needed (17 KB of heap without it: the access
    point gave no DHCP lease), Wi-Fi power save off. Loading a bitstream over Wi-Fi does not work
    yet, by XVC or by the link's own loader (main/gowin.c); the README says what was tried and seen.
    [partitions.csv]
2026-11-12 Gateware: the fields half a line apart, 59.94 Hz out, the picture read back by the host
    - fbview.v: a line's field (vcap.v writes each line's F beside the store) decides which rows it
    fills: a top field's line n is frame line 2n, a bottom one's 2n + 1.
    - tools/hdmi.py --ntsc: the MS5351M at 148.5/1.001 MHz, the picture rate the source's 59.94 Hz;
    tools/video.py uses it.
    - rtl/grab.v, tools/grab.py: eight rows of a frame of the picture as sent, read through the
    monitor into a PNG: the output seen with no display connected.
2026-11-12 Gateware: the fields in the DDR3, a motion adaptive deinterlacer, no tear
    The picture's path rebuilt on the SOM's DDR3 (rtl/ddr3: our PHY, calibration and controller from
    the fpc console, calibrated and tested on this board through the monitor: tools/ddr.py):
    - cap_ddr.v: each field into one of eight slots, a slot a bank of the memory, sixteen pixels a
    256-bit line.
    - deint.v: at each output frame the last four fields; a field's own lines as they are, the lines
    between from the field before where nothing moves (weave) and from the lines above and below
    where something does (bob), by the luma differences two fields apart. A line is made when the
    output is about to want it. Whole fiel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
2026-11-12 Gateware: the scaler: FSR 1's edge adaptive upsampling, table driven
    720 x 480 to 1440 x 1080 by AMD's FSR 1 EASU (ffx_fsr1.h, MIT) in place of the nearest pixel:
    - sim/fsr.py: the shader in Python, and the form the hardware takes: each source pixel's part of
    the edge direction and strength worked out once as the pixels stream by; the output pixel's
    place between source pixels takes 2 x 9 values (the ratios are 2 and 9/4), so the four parts
    are weighed by whole numbers; the direction goes in one of 32 bins, the strength in one of 8,
    and the twelve weights for (place, direction, strength) come from a table with the division by
    their sum done. On a frame captured from the board: 56.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
2026-11-12 Firmware: the link runs the scaler by itself; the picture's settings on its web page
    main/scaler.c: what gateware/tools/hdmi.py, clkgen.py, adv.py and video.py do from a PC, done by
    the ESP through the FPGA's monitor: the MS5351M (148.5 MHz or 148.5/1.001), the SN65DP159 as a
    redriver, the sink's SCDC, the lanes, the ADV7181D for 480i component through its CP core, the
    deinterlacer's and the anti-aliasing's settings. Each second it looks whether the FPGA still
    answers and is still up (a reload, a display plugged in: brought up again) and reads what the
    capture and the deinterlacer say. I2C registers are read back after they are written and written
    again if not there (the radio beside the clo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
2026-11-12 Gateware: the bitstream in the SOM's flash: the board starts by itself
    tools/flash.sh: a bitstream into the SOM's configuration flash over the XIAO's USB-JTAG bridge
    (verified), or the flash read to a file first. With the bitstream there and the link's firmware
    in the XIAO, power is all the board needs: the FPGA loads in about 20 s, the link brings the
    clock chip, the redriver, the decoder and the settings up 2 s later. Tried on the board (the
    FPGA reloaded from its flash, the picture read back with tools/grab.py).
    READMEs: how the board stands alone.
2026-11-12 Gateware, firmware: the sound over HDMI (off until tried on a display); timing closed with all of it
    - rtl/hdmi_audio.v: HDMI's data islands: one packet in each line's back porch: the PCM1808's
    samples (two channels of L-PCM, channel status and parity, a block's start every 192), the
    audio clock's N and CTS (6144, 147456: fs is the pixel clock / 3072 exactly), the audio and the
    AVI InfoFrames (RGB, full range, 16:9, VIC 16). TERC4, the guard bands, the BCH error
    correction. Its characters go to the encoders in the control tokens' place; its preamble
    through hdmi_scr.v's control bits. HDMI register bit 2 (with bit 1, the video guard band);
    tools/hdmi.py --audio; the link's setting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
    [app.h, audio_tb.py, deint.v, deint_tb.py, easu.v, hdmi.py, hdmi_audio.v, pattern.v]
2026-11-12 README: rev C-B runs: what the board does now
2026-11-12 HDMI out: the redriver sends without hot plug; a capture dongle read by tools/cap.sh
    A USB capture dongle raises hot plug only once it sees a signal; the SN65DP159 powers its outputs
    down while hot plug is low: neither started. Its register 09 bit 2 (HPD_AUTO_PWRDWN_DISABLE) set
    in the link's bring-up and in tools/hdmi.py: the dongle locks and shows the picture.
    tools/cap.sh: a frame from the dongle (the real HDMI output, in a second).
2026-11-12 tools/capview: a capture dongle on a web page; firmware: no bring-up on hot plug
    tools/capview/capview.py: the dongle's own Motion-JPEG frames passed on to an <img> (no
    transcoding), a snapshot and a status; a systemd user unit. gateware/tools/cap.sh takes the
    service's frame when somebody is watching.
    firmware scaler.c: hot plug no longer starts a bring-up: a capture dongle drops and raises it
    each time the signal restarts, so it never ended (black frames in between); at 1080p a display
    needs nothing told.
    [scaler.c]
2026-11-12 capview: the page asks for each frame and draws it on a canvas
    A multipart stream in an <img> stayed black in the user's browser though the frames arrived.
    /frame?after=N answers with the next frame newer than N; the page draws them on a canvas and
    shows its own rate.
2026-11-12 capview: H.265 from the GPU as the page's second way
    One ffmpeg has the dongle: its Motion-JPEG passed on as before and, while somebody watches
    H.265, the same frames decoded and encoded by the GPU (hevc_vaapi, constant quantiser: this
    AMD GPU's bit-rate modes make streams ffmpeg's decoder faults, cu_qp_delta out of range),
    fragmented MP4 a frame a fragment on /h265 from the next key frame on. The page plays it
    through Media Source Extensions and keeps the player at the newest frame; a browser without
    HEVC stays with Motion-JPEG. About 5 Mbit/s for a game's 1080p60 where the JPEG is 34.
2026-11-12 capview: H.264 by the GPU and H.265 in software beside the GPU's H.265
    Chrome on a Mac refuses this AMD GPU's H.265 (VideoToolbox -12909) whatever was tried: the
    level said outright, no access unit delimiters, limited range, 720p, other quantisers, the
    speed preset, one slice; the same packaging with x265's stream plays. So the page offers
    H.264 from the GPU, the GPU's H.265 (for other decoders) and x265; one encoder at a time.
    The page reports its player's errors and its first second of playing to the service's log.
2026-11-12 capview: the dongle's sound on the page
    /audio: the dongle's ALSA device as AAC in fragmented MP4 while somebody listens; the page's
    sound switch plays it beside whichever picture and keeps it at the newest. The scaler's HDMI
    sound arrives through the dongle (peaks about -22 dB).
2026-11-12 SMAA: what it finds shown in the picture's place
    smaa.v dbg (DEINT bit 17; the link's "show what it finds"; tools/video.py --aadbg): the picture
    dimmed and grey, a pixel with an edge and nothing mixed green, a pixel mixed with the one above
    or below blue, with the one beside it red, the brighter the more. The pixel's own edges kept
    beside the weights for it. sim: matches the model with aadbg. Seen on the board through the
    capture dongle on a game's frame: at threshold 20 the strongest outlines only, at 8 the
    textures too.
    firmware: settings kept in flash by an older firmware are read as far as they go.
2026-11-12 SMAA: the diagonal patterns
    Along both diagonals through a pixel with a top edge, to 8 pixels each way, with the
    crossing edges at their ends and a second area table; their weights before the
    orthogonal ones. A switch (DEINT bit 18, the page, video.py --nodiag). The testbench
    takes a still picture (pic=FILE): the chain is exact against the model on
    sim/ref/diag480.png, the view of what it finds too.
2026-11-12 SMAA: corners kept; three long paths shortened
    SMAA_CORNER_ROUNDING 25: a weight x 1/4 (x 5/8 with one end of two) where the edge
    crossing at the nearer end of a line goes on a pixel further. A switch (DEINT bit 19,
    the page, video.py --nocorner). Exact against the model on sim/ref/menu480.png.
    easu: the no-direction test beside the products, not after them. rcas: the rounding
    added with the luma product. hdmi_audio: the samples at the front read a clock before.
    All results as before.
    [app.h, deint_tb.py, easu.v, hdmi_audio.v, lstream.v, model.py, rcas.v, scaler.c]
2026-11-12 A 16:9 picture: the scaler fills all 1920 columns
    For a game set to widescreen (its 16:9 picture in the same frame). easu.v, rcas.v: wide
    (GEOM DX bit 31); the columns counted from 120 before the line (a full-width picture
    has no columns before it to fill the window from); a row ends after its last pixel has
    its weights. The link: wide, the page.
2026-11-12 The page: cards, switches and sliders; a setting is sent as it is changed
2026-11-12 Noise: still areas averaged over two frames, the sharpening leaves noise alone; the sampling phase
    deint.v: C's and P1's samples with the same ones two fields before where they differ
    little (nr 1 to 3; DEINT 5:4). rcas.v: FSR_RCAS_DENOISE (VID bit 4), a clock more.
    On the board, a frozen frame's flat blocks: 2.32 -> 1.98 (nr 2), at full sharpening
    3.94 -> 3.12 (noise aware) -> 2.61 (and nr 2).
    focus.v (FOCUS, 37): a field's sum of squared steps between neighbours; the decoder's
    DLL phase (register 6A, 4:0) tried against it: video.py phase sweep, the link's tune.
    Killzone: 4.5 % between the sharpest (10-12) and the least (19-20).
    Timing: the scaler's row place added in two clocks, its stre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
    [app.h, deint.v, deint_tb.py, easu.v, focus.v, fsr.py, hdmi_audio.v, model.py]
2026-11-12 The hard CPU, and an on-screen display it writes; the chip's temperature; the picture's delay
    cpu.v: the SOM's A25 (Gowin's RiscV_AE350_SOC from the IDE's files, configured as the fpc
    console's): 400 MHz from PLL_R[0] (the system clock's PLL, placed there), its program 32 KB
    of block RAM the register bus can write (tools/cpu.py load: 1.3 s), the register bus at
    0xE8000000 between the monitor's words (mon.v: stall, busy). sw/: its program.
    osd.v: 8 lines of 48 characters over the picture (OSD 28, OSDW 29); sw/main.c writes
    them from the registers. TEMP (2A): the chip's ADC. LAT (27): the newest field's age
    when a frame is begun. The link: the text's switch, the temperature, the delay and the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
    [app.h, cap_ddr.v, cpu.py, cpu.v, cpu_tb.py, deint.v, gw_dtcm_config.v]
2026-11-12 The CPU runs the scaler; the link talks to it over SPI
    sw/: the bring-up, the settings (the CPU's are the ones that count), each second's
    looking after (the part shown, the sampling phase), the on-screen text, and the link's
    requests answered (link.h: what it does, the settings, commands, pixels of the picture
    as it goes out). No operating system: a loop, and waits that keep answering.
    rtl/spis.v: the XIAO's SPI port: the registers with no program on the other side (the
    CPU's program loaded through it), and a request and an answer for the program. A third
    turn on the register bus (sim/cpu_tb.py: the three at once, and messages of every length).
    The link: main/link.c; scaler.c relays (the set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
2026-11-12 The frame lock: the output's frames in step with the input's fields
    sw/board.c: ten times a second the clock chip's frequency trimmed (the PLL's b over a
    denominator of a million: 0.028 ppm a step, 300 ppm at most) so that a frame is begun
    0.5 ms after a field's end (LAT): no field shown twice or left out, the delay 16.8 ms all
    the time. On the board: in step within 10 us, the clock at -57 ppm (the console's
    against the board's crystal); from 5 ms off in 20 s. The link: the setting (lock), what
    it does on the page and in the on-screen text.
2026-11-12 The picture begun while the field is still coming in: 2 ms, not 16.8
    cap_ddr.v: prog: the lines of the field coming in that are in the memory. deint.v: ll:
    a frame begun with ll_min of them in is made from that field (the three before it its
    P1 to P3); a line not in yet is waited for. LAT 25:16: prog as the frame began; LLMIN
    (2B); DEINT bit 6. sim/deint_tb.py ll=N: the last field begun so that N lines are in
    as the frame begins: exact with 3, 12, 20 and 40.
    sw/board.c: the lock's place for it (21 lines into the field with the picture found
    from line 14), the delay as it then is. The link: the setting (lowlat) and what it does.
    On the board: in step, every frame from the field coming in,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
2026-11-12 tools/still.py: stills of what comes in and what goes out, of one frozen frame
    The two newest fields out of the DDR3 (a read of the state between asking for a line
    of the memory and reading it: with commands waiting in the monitor the first word came
    back before the memory had answered), woven; that stretched to 1080p; the scaler's
    picture read back; the two side by side. The frame lock keeps its trim while a host
    tool has the scaler.
2026-11-12 The repository is the scaler's: rev C-B first, the other board revisions in older/
    README.md: what the scaler is and does (the picture's path, the timing, the control),
    how it is put together, what was measured on the board, what is not done.
    hardware/av-board: rev-a, rev-b, rev-ca moved to older/ (not built; kept for the design
    notes and reviews rev C-B's circuits come from), their generators and library tables
    finding kit/, rev-c/ and lib/ from there (kit/rev.py finds a revision in older/ by its
    name; gen_sch.py writes the tables' path as it is from the revision; carrier.py writes a
    revision's pin file beside it); README.md about the board that is built, older/README.md
    about the others (t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
    [av-board-a-bom.csv, av-board-a.kicad_pcb, av-board-a.kicad_sch, av-board-b-bom.csv, av-board-b-hand-jacks-bom.csv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]
2026-11-13 Comparison stills in the README: two frozen frames, the plain way and the scaler's
    docs/compare/: of a frame in the game and of a results screen, the whole 1080p frames
    both ways and the frames as they came; the game's halves side by side; eight parts
    enlarged. gateware/tools/still.py: --at X,Y names the parts compared; a byte lost on
    the way while the fields are read no longer ends the capture (the lines are asked for
    again: the picture is frozen).
    [still.py]
2026-11-13 A page to compare by dragging: the plain picture and the scaler's under one line
    docs/compare/index.html: both frames, a line to drag (mouse, touch, keys) between the
    480i picture made 1080p the plain way and the scaler's; sizes fit, 1:1 (a pixel of the
    picture a pixel of the screen), 2x, 4x; ?frame= size= at= name a view. No dependencies.
    For GitHub Pages from docs/ (index.html there leads on); the README links to it.
2026-11-13 cpu: a frozen picture upsets neither the frame lock nor the numbers shown
    While the picture is held (the freeze setting, or a screen capture reading it out) no
    fields come in: the lock steered by a frame that only grew older, to the trim's end, and
    took a minute to come back; the delay shown went to 57 ms. Now the clock is left as it
    is and the delay as last measured; during a capture the on-screen text is left alone,
    so it is in the capture as it was. On the board: locked again 3 s after a full capture.
2026-11-13 README: a photograph of the board
2026-11-13 README: the board's render back, before the picture of the output
2026-11-13 README: the photograph of the board under its render
2026-11-13 xiao-wifi: a transmit clock that came up wrong at power-on: the FPGA loads its image again
    After a power-on the FPGA configures before the clock generator runs (the CPU sets it):
    lane 0's word clock, which the whole picture runs on, then comes up at some 61 MHz for
    148.35 (25 frames a second: an AV receiver found no signal), and the lanes' resets do not
    clear it. An FPGA that configures with the reference running is right. So the link
    watches the two clocks (once a second, the output up) and, the transmit clock off for
    four seconds, has the FPGA load its flash's image again by JTAG (three times at most).
    Reproduced without a power cycle (the clock generator's outputs off, a reload): 25
    fra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
    [gowin.c, gowin.h, scaler.c]
2026-11-13 The sound at 48 kHz: an AV receiver takes it
    The converter ran on the pixel clock's twin / 3072: 48.29 kHz, 0.6 % over the 48 kHz the
    channel status says. A display and a capture device played it; an AV receiver showed no
    sound. Now the clock generator's CLK2 is 512 x 48 kHz from the PLL the pixel clock comes
    from (the PLL / 36 7/32; the CPU sets it, on a design built since), audio_in.v halves it for
    the converter, and hdmi_audio.v sends CTS 148352 with N 6144 (148500 at 148.5 MHz: HDMI bit
    3): the ratio is exact whatever the frame lock does to the clock. On the board: 47998 Hz
    at 148.3465 MHz, sound on the receiver. Build s_p3r1 (every clock closed), in the flash.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
2026-11-13 720p in goes out as 720p: the picture as it came (in simulation; first seen on the board)
    A progressive 1280 x 720 picture is kept in the DDR3 as the fields are and sent as it is:
    nothing deinterlaced, anti-aliased or scaled.
    - vcap.v, cap_ddr.v: a line's words, a field's lines and the DDR3 lines a line by SRC (2C).
    - deint.v pg: a field is a frame: its lines as they are, two a step (two reads for sixteen
    pixels, the memory's row changed once), with ll the one coming in.
    - pthru.v: a store of four lines read by the output's place, 4:4:4, R'G'B'.
    - The output at 1280 x 720 [VIC 4]: the lanes as they are, a pixel every other word clock
    (pce to pattern.v, dline.v, osd.v, hdmi_scr.v, hdmi_au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
2026-11-13 deint.v: pg and nch kept for the frame: a change of what comes in no longer strands a step
    720p gave way to 480i (a game started from Open PS2 Loader) in the middle of a step: two
    lines had been asked for, four were then waited for, for ever: no frames, a blue screen.
    pg and nch are now taken when a frame is begun. sim/pthru_tb.py switch: pg taken away in
    the middle of a step and given back: frames go on (the design before: stuck).
    The CPU: no frame for two seconds while fields come in: pg the other way for a moment
    (lets a design from before this go on); 720p's rate by the decoder's clock (60.00, not
    STDI's coarse 59.77); the output's clock for 60 Hz seen to hold: locked, 0.3 ms.
    Co-Autho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
    [board.c, deint.v, pthru_tb.py]
2026-11-13 The pixel's clock sixteen times: the output's clock closes again
    pce alone was on some 2300 registers: every placement but one missed the output's clock
    on it (6.9 ns from its register to a CE). pcev: sixteen of it, kept apart, a module or a
    part of one each; hdmi_audio.v's wide registers (the subpackets, their error correction,
    the packet as sent) in blocks of their own on three more. pthru.v: the row's events from
    registered comparisons. audio_tb.py, pthru_tb.py as before.
    k_p2r2 (before pthru.v's change): sys 54.3, tx 153.85, ddr 99.99; in SRAM: 480i locked;
    the progressive bit changed 25 times in the middle of frames: the reader never stuck.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
    [audio_tb.py, hdmi_audio.v, pthru.v, top.v]
2026-11-13 SMAA: lines drawn as thin layers are smoothed: junctions by the pixels, corners only where real
    A rail drawn as a highlight and a mid tone a line apart (a bed's footboard, Tales of the
    Abyss): each layer's steps cross the next one's edge, both ways at once at every step.
    SMAA took such an end for no turn (half of each step not smoothed) and for a corner (the
    rest x 1/4): a tenth of the blend a clean step gets.
    - An end where edges cross both ways is taken for the way the pixels go on: the turn
    across which the two pixels diagonally over the crossing are alike (within the edge
    threshold); two bits a pixel more beside its edges (bm 128 bits, hk, svl, svr).
    - An end is a corner only where t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
2026-11-13 docs/compare: the game frame taken again, with SMAA's thin-layer fix running
    A new frozen frame of Killzone's jungle map (gateware/tools/still.py, the bitstream built with
    e390180), in place of the old one: the plain way, the scaler's, a half of each and the fields
    as they came. The settings as the README gives them (noise reduction medium, SMAA with
    diagonals and corners at 12, sharpening 8, 16:9). The drag page shows it as "In the game".
    The enlarged parts (tower, palms, ...) are still the earlier frame's.
2026-11-13 docs/compare: Tales of the Abyss in the results screen's place
    A frozen frame of Tales of the Abyss (PS2, 4:3; gateware/tools/still.py, the bitstream built
    with e390180): the plain way, the scaler's, a half of each and the fields as they came. The
    drag page's two frames are now Killzone and Tales of the Abyss (index.html?frame=abyss); the
    results screen's pictures and its two enlarged parts are gone, and the README follows.
2026-11-13 README: the Tales of the Abyss frame, a half of each way, under the Killzone frame
2026-11-13 README: the Tales of the Abyss frame the plain way and the scaler's, in turn
    docs/compare/abyss-swap.png: abyss-plain.png and abyss-scaler.png as an animated PNG
    (lossless, two seconds each, looping), each with which it is in its corner; in the README
    where the still half-and-half was.
